Rynnat/endoskull/research/cad_estetik/ref/orbita_tur1_on.png

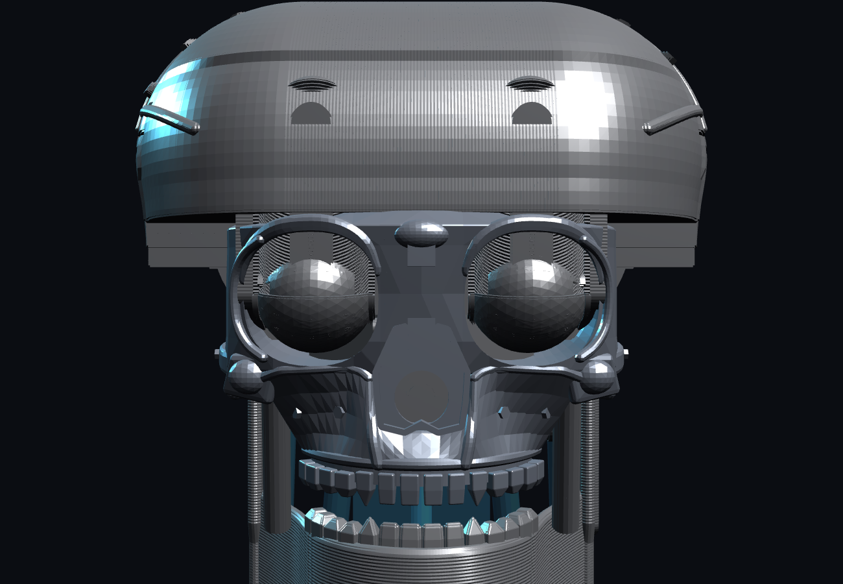
research/cad_estetik/ref/orbita_tur1_on.png
