Rynnat/endoskull/research/cad_estetik/ref/orbita_tur1_3q.png

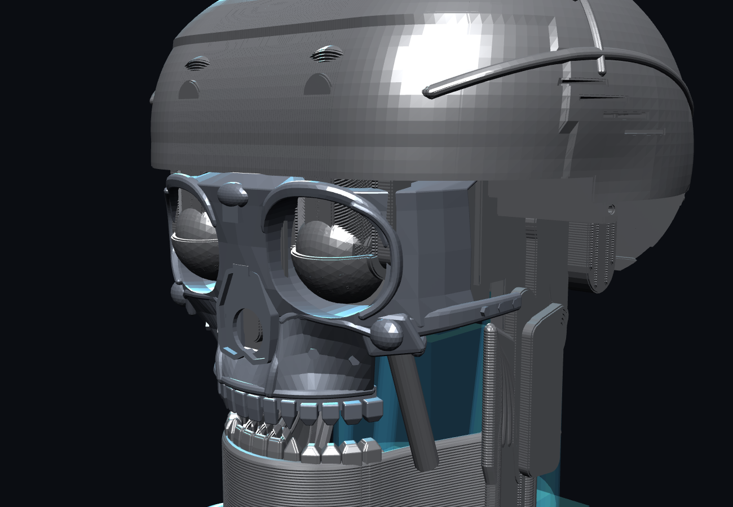
research/cad_estetik/ref/orbita_tur1_3q.png
