Rynnat/endoskull/README.md

# Endoskull

A 1:1 animatronic skull bust, designed as code (CadQuery).

**Status:** CAD and browser simulation stage.

Planned: camera eye tracking (MediaPipe), mechanical jaw, 3-axis neck (yaw / pitch / roll), audio.

## Contents
- `research/` — research notes, plan, decisions (Turkish)
  - `cad/` — parametric CadQuery model, check scripts, STL output
  - `cad_estetik/` — styling branch
  - `kuponlar/` — tolerance / measurement test coupons
- `versions/v1 … v14` — single-file interactive 3D simulation per version (`model.html`, opens in a browser)

## Note
A second design branch derived from an external model (y1, y2) and reference photos are not included in this repo for licensing reasons.
