Rynnat/endoskull/versions/v14/README.md

# Project Bust v14 — CAD SIM (omurga2 ara hali) + Etkileşim
v13 davranış katmanı + güncel CAD (2026-10-17 21:10):
- **B2 sadeleştirildi** (910k → 50.7k üçgen, simplify 0.02 mm; görünüm aynı).
- **Boyun omurga2 (ara hal, kullanıcı "şimdilik ekle")**: iki eğme MG996R sırt sırta omur kasasında (O1L/O1R, dikenli), arka L-kuleler kalktı, N1 disk, **yay ve yay direği kalktı**; arka taşma ~80 mm → ~0. P1'ler hâlâ ~30° geriye eğik (sonraki turda dikleşecek).
- Etkileşim: kişi girince "Bir insan görüyorum.", çıkınca 2 sn içinde "İnsan görüntüden çıktı." (2+ kişi: "Herkes"), geri gelince yine selam. Diğer davranışlar v13 README ile aynı (nesne algılama, sesli komutlar, uzun bakış jesti, boşta etrafa bakınma).
- Kafatası estetiği (cad_estetik/) bu sürümde YOK.

Test: `model.html?test` (BEHTEST). Üretim: research_notes/Project Bust/cad/sim_export.py.
