Rynnat/endoskull/research/cad/out/check_report_boyun.txt

SONUC: SORUN (8)
KAPSAM:
  OLCULDU:   [tek_govde_boyun] 13 parca: ayri govde sayisi (manifold decompose)
  OLCULDU:   [diferansiyel_tork [YAYSIZ (yay yok), nominal]] 70 poz: J = dpsi/dq sayisal (krank cos, rod acisi dahil), tau = J^-T (Q +- ek), pay >= 1.5 @ 2.5 kg*cm
  OLCULDU:   [diferansiyel_tork [YAYSIZ (yay yok), kutle +%30]] 70 poz: J = dpsi/dq sayisal (krank cos, rod acisi dahil), tau = J^-T (Q +- ek), pay >= 1.5 @ 2.5 kg*cm
  OLCULDU:   [yercekimi_tork_pitch [yaysiz, iki servo toplam, bilgi]] 36 parca kutle/AM, 10 aci (-25..+20): yercekimi torku + ek terimler, pay >= 1.5
  OLCULDU:   [strok_boyun] 16 eleman x 50 poz: kinematik cozum var mi + deger izinli aralikta mi (sinir payi)
  OLCULDU:   [kablo_boyun] 3 kablo x 27 poz: dogru parcali yol + servis halkasi <= kablo boyu
  OLCULDU:   [devrilme] 9 poz: toplam AM izdusumu destek cokgeninde (>= 15.0 mm, devrilme acisi >= 15.0 deg)
  OLCULDU:   [montaj_sokme_boyun_tezgah] 8 adim, 10 parca: dogrusal sokme yolu (1.0 mm adim, esik 0.5 mm3 / takili kesisim ustu)
  OLCULDU:   [montaj_sokme_boyun] 16 adim, 91 parca: dogrusal sokme yolu (1.0 mm adim, esik 0.5 mm3 / takili kesisim ustu)
  OLCULDU:   [poz_kilit] izgara 80 poz (bas_yaw 2 x bas_roll 2 x cene 2 x bas_pitch 10) + ikiye bolme (0.5 deg) = 104 poz olculdu; 1866 cift (kurallar: [('N3', 'N2', 0.3), ('N3', 'B1', 0.3), ('B4', '*', 5.0), ('*', '*', 0.4)])
  OLCULDU:   [tork_pay_ozeti_CP3b-2] pitch/roll en kotu servo payi 3 kapasite satiri (KAGIT 1: 2.0 / 2.5 / 3.5)
  OLCULMEDI: [diferansiyel_tork [YAYSIZ (yay yok), nominal]] servo kapasitesi, yay sabiti, surtunme ve dinamik ek terimler GIRDI (olculmedi); servo dis boslugu ve rod esnemesi modellenmedi
  OLCULMEDI: [diferansiyel_tork [YAYSIZ (yay yok), kutle +%30]] servo kapasitesi, yay sabiti, surtunme ve dinamik ek terimler GIRDI (olculmedi); servo dis boslugu ve rod esnemesi modellenmedi
  OLCULMEDI: [yercekimi_tork_pitch [yaysiz, iki servo toplam, bilgi]] GIRDI (olculmedi): dolgu orani / satin alinan parca kutleleri, servo kapasitesi (stall x kural), ek terimler (dinamik, surtunme); kapasite = 2 x 2.5 (krank cos ve diferansiyel paylasim diferansiyel_tork'ta)
  OLCULMEDI: [yercekimi_tork_pitch [yaysiz, iki servo toplam, bilgi]] kablo cekmesi / yay etkisi, eksen kaciklik surtunmesi, servo ic disli boslugu olculmedi
  OLCULMEDI: [strok_boyun] kinematik modelin kendisi (eklem boslugu, esneme, baski sapmasi) ve izgara disindaki ara pozlar olculmedi
  OLCULMEDI: [strok_boyun] kardan pim2 (mentese) +-45 siniri geometrik tahmin; gercek sinir poz_kilit carpismasinda (orta x dil)
  OLCULMEDI: [strok_boyun] rotil acisal siniri 25 deg [TAHMIN K3]; P1 0.4/0.6 varyant tuplerinde boy ayni, yalniz ic OD degisir
  OLCULMEDI: [kablo_boyun] kablonun gercek guzergahi, bukulme yaricapi, surtunme/asinma ve konnektor boyu olculmedi (dogru parcali model)
  OLCULMEDI: [kablo_boyun] kablo ile hareketli parcalar arasindaki carpisma (esnek) olculmedi; kanca/delik konumlari kablo yolu noktasi
  OLCULMEDI: [devrilme] dinamik kuvvetler (servo ivmesi, kablo cekmesi, carpma), masa surtunmesi / kayma, ayak esnemesi olculmedi; statik
  OLCULMEDI: [devrilme] gogus satin kalemleri (lazy susan 150 g, kartlar, hoparlor) ve adaptor kablosu cekmesi TAHMIN
  OLCULMEDI: [montaj_sokme_boyun_tezgah] yalniz dogrusal (tek yonlu) yol; donerek/egilerek takma, esnek parca, el/tornavida erisimi olculmedi
  OLCULMEDI: [montaj_sokme_boyun_tezgah] 1.0 mm'den ince engeller adim arasinda kacabilir
  OLCULMEDI: [montaj_sokme_boyun_tezgah] OMURGA: servolar kasa cebine DISARIDAN (+-X) takilir, kulak M4 somunlari yan girisli; sokme: krank vidasi -> 4 kulak vidasi -> servo; M4/M3 alet koridoru elle (olculmedi)
  OLCULMEDI: [montaj_sokme_boyun] yalniz dogrusal (tek yonlu) yol; donerek/egilerek takma, esnek parca, el/tornavida erisimi olculmedi
  OLCULMEDI: [montaj_sokme_boyun] 1.0 mm'den ince engeller adim arasinda kacabilir
  OLCULMEDI: [montaj_sokme_boyun] yay (esnek, S-kanca) ve kablo montaj sokmeye girmedi; rod grubu once kranka (asagi + yana), bas sonra iner, ust rotil vidasi sonra; P1: ortalar dillere, sonra kisaltilmis teleskop yandan catallara (pimler sokulu degil)
  OLCULMEDI: [poz_kilit] muaf cift B1 x P1L_orta_ust: kardan orta B1 diline M3 pimli (catal dili sarar)
  OLCULMEDI: [poz_kilit] muaf cift B1 x P1R_orta_ust: kardan orta B1 diline M3 pimli (catal dili sarar)
  OLCULMEDI: [poz_kilit] muaf cift B1 x rotil_ust_L: rotil gozu B1 kulagina M3 ile sikilir
  OLCULMEDI: [poz_kilit] muaf cift B1 x rotil_ust_R: rotil gozu B1 kulagina M3 ile sikilir
  OLCULMEDI: [poz_kilit] muaf cift N2 x pim_pitch_L: M4 saplama catal deliginde
  OLCULMEDI: [poz_kilit] muaf cift N2 x pim_pitch_R: M4 saplama catal deliginde
  OLCULMEDI: [poz_kilit] muaf cift N3 x pim_roll_M4x40: M4 roll pimi hac deliginde
  OLCULMEDI: [poz_kilit] muaf cift N4_L x rotil_alt_L: rotil gozu kranka M3 ile sikilir
  OLCULMEDI: [poz_kilit] muaf cift N4_R x rotil_alt_R: rotil gozu kranka M3 ile sikilir
  OLCULMEDI: [poz_kilit] muaf cift O1L x P1L_orta_alt: kardan orta kasa diline pimli
  OLCULMEDI: [poz_kilit] muaf cift O1R x P1R_orta_alt: kardan orta kasa diline pimli
  OLCULMEDI: [poz_kilit] muaf cift P1L_dis x P1L_orta_alt: orta catali tup dilini sarar
  OLCULMEDI: [poz_kilit] muaf cift P1L_ic x P1L_orta_ust: orta ust catali tup dilini sarar (M3 pim)
  OLCULMEDI: [poz_kilit] muaf cift P1R_dis x P1R_orta_alt: orta catali tup dilini sarar
  OLCULMEDI: [poz_kilit] muaf cift P1R_ic x P1R_orta_ust: orta ust catali tup dilini sarar (M3 pim)
  OLCULMEDI: [poz_kilit] muaf cift egme_mg996r_L x egme_mgkol_L: disk kol spline
  OLCULMEDI: [poz_kilit] muaf cift egme_mg996r_R x egme_mgkol_R: disk kol spline
  OLCULMEDI: [poz_kilit] muaf cift lazy_susan_alt x lazy_susan_ust: rulman (satin, tek parca)
  OLCULMEDI: [poz_kilit] muaf cift lazy_susan_ust x mg996r_yaw: servo mili rulman ic deliginde
  OLCULMEDI: [poz_kilit] kurallarla eslesmeyen ciftler bu kontrolde olculmedi (ayri cakisma kontrolleri); izgara arasi kombinasyonlar dogrusal varsayildi
  OLCULMEDI: [poz_kilit] goz yaw/pitch ve kapak pozlari izgaraya katilmadi: goz modulu bas icinde (y > 16), boyun/gogus parcalarina erisemez; goz x kapak supurmesi check.py cakisma_goz_kapak_supurme'de
  OLCULMEDI: [poz_kilit] bas ici ciftler (ayni 'bas' grubu: B4 x B1 vb.) burada olculmedi - cene supurmesi check.py'de

Project Bust CP3b-2 boyun

AYRINTI:
== tek_govde_boyun: GECTI (0 bulgu)
== diferansiyel_tork [YAYSIZ (yay yok), nominal]: GECTI (0 bulgu)
   . bas kutlesi 466 g, AM [3.8, 29.0, 9.3]; I_pitch 17.4 kg*cm2, dinamik pitch 0.149 / roll 0.104 kg*cm, surtunme 0.15; hedef 1.5
   . EN KOTU POZ p-10_r-15: servo torklari [0.234, 0.639] kg*cm (Q [0.644, 0.512] + ek {0: 0.29888298327649976, 1: 0.10372392071126256})
   . kapasite 2.2 kg*cm [2.2 kg*cm] -> en kotu pay 3.44 (hedef 1.5)
   . kapasite 2.5 kg*cm [2.5 kg*cm] -> en kotu pay 3.91 (hedef 1.5)
   . kapasite 3.5 kg*cm [3.5 kg*cm] -> en kotu pay 5.48 (hedef 1.5)
   .    p-10_r-15: maks servo 0.639 kg*cm
   .    p-25_r+0: maks servo 0.634 kg*cm
   .    p-15_r-15: maks servo 0.634 kg*cm
   .    p-15_r-10: maks servo 0.631 kg*cm
   .    p-20_r-5: maks servo 0.630 kg*cm
   .    p-20_r-10: maks servo 0.627 kg*cm
== diferansiyel_tork [YAYSIZ (yay yok), kutle +%30]: GECTI (0 bulgu)
   . bas kutlesi 605 g, AM [3.8, 29.0, 9.3]; I_pitch 22.7 kg*cm2, dinamik pitch 0.194 / roll 0.135 kg*cm, surtunme 0.15; hedef 1.5
   . EN KOTU POZ p-10_r-15: servo torklari [0.283, 0.814] kg*cm (Q [0.837, 0.665] + ek {0: 0.34354787825944966, 1: 0.13484109692464133})
   . kapasite 2.2 kg*cm [2.2 kg*cm] -> en kotu pay 2.70 (hedef 1.5)
   . kapasite 2.5 kg*cm [2.5 kg*cm] -> en kotu pay 3.07 (hedef 1.5)
   . kapasite 3.5 kg*cm [3.5 kg*cm] -> en kotu pay 4.30 (hedef 1.5)
   .    p-10_r-15: maks servo 0.814 kg*cm
   .    p-15_r-15: maks servo 0.809 kg*cm
   .    p-25_r+0: maks servo 0.807 kg*cm
   .    p-15_r-10: maks servo 0.804 kg*cm
   .    p-20_r-5: maks servo 0.802 kg*cm
   .    p-20_r-10: maks servo 0.800 kg*cm
== yercekimi_tork_pitch [yaysiz, iki servo toplam, bilgi]: GECTI (0 bulgu)
   . donen kutle 466 g, AM (notr) [3.8, 29.0, 9.3] mm, eksenden 30.5 mm
   . T(aci) kg*cm: -25:-0.180  -20:-0.057  -15:+0.067  -10:+0.190  -5:+0.312  +0:+0.432  +5:+0.548  +10:+0.660  +15:+0.766  +20:+0.867
   . yercekimi en kotu 0.867 kg*cm @ +20 deg; ek: dinamik 0.149, surtunme 0.150 -> gereken 1.166; kapasite 5.000 -> PAY 4.29 (hedef 1.5)
   . EGRI pitch: yercekimi / yay / net (kg*cm, + = asagi devirir): -25: +0.96/+0.73/+0.23  -20: +0.87/+0.65/+0.22  -15: +0.77/+0.57/+0.20  -10: +0.66/+0.49/+0.17  -5: +0.55/+0.40/+0.15  +0: +0.43/+0.32/+0.12  +5: +0.31/+0.23/+0.08  +10: +0.19/+0.15/+0.04  +15: +0.07/+0.06/+0.00  +20: -0.06/-0.02/-0.04
   . yay denge orani (nominal delik, en kucuk kareler) 0.75 (hedef 0.75); en buyuk sapma 0.022 kg*cm
   . OMURGA2: yay YOK (kaldirildi); yay sutunu bilgi amacli eski ankrajla hesaplandi
== strok_boyun: GECTI (0 bulgu)
   . P1 tup: dis 62.2 / ic 61.0 mm, pim1-tup 8.0/6.7; izinli pim1-pim1 [79.9, 117.9] (alt: ic tup ucu dis tup tabanina / dis tup agzi ic koniye 3.0 mm; ust: bindirme >= 2 x OD)
   . krank_L (r 22.8): -39.84..47.96 deg (p+20_r-15.0 / p-25_r+15.0); sinir [-60.0, 60.0] -> en kucuk pay 12.04 deg (ust, p-25_r+15.0)
   . rotil_alt_L: 0.00..1.65 deg (p-25_r+0.0 / p-25_r-15.0); sinir [None, 25.0] -> en kucuk pay 23.35 deg (ust, p-25_r-15.0)
   . rotil_ust_L: 0.00..16.65 deg (p-25_r+0.0 / p+5_r-15.0); sinir [None, 25.0] -> en kucuk pay 8.35 deg (ust, p+5_r-15.0)
   . P1L tup boyu (pim1-pim1): 80.40..115.56 mm (p+20_r-15.0 / p-25_r+15.0); sinir [79.9, 117.9] -> en kucuk pay 0.50 mm (alt, p+20_r-15.0)
   . P1L kardan ust pim1 (K5): -18.71..19.16 deg (p-15_r+15.0 / p-25_r-15.0); sinir [-25.0, 25.0] -> en kucuk pay 5.84 deg (ust, p-25_r-15.0)
   . P1L kardan alt pim1 (K5): -5.33..4.61 deg (p+20_r-15.0 / p-25_r+15.0); sinir [-25.0, 25.0] -> en kucuk pay 19.67 deg (alt, p+20_r-15.0)
   . P1L kardan ust pim2 (mentese): -26.78..32.55 deg (p-25_r+15.0 / p+20_r-15.0); sinir [-45.0, 45.0] -> en kucuk pay 12.45 deg (ust, p+20_r-15.0)
   . P1L kardan alt pim2 (mentese): -2.85..7.75 deg (p-10_r+15.0 / p+20_r-15.0); sinir [-45.0, 45.0] -> en kucuk pay 37.25 deg (ust, p+20_r-15.0)
   . krank_R (r 22.8): -39.84..47.96 deg (p+20_r+15.0 / p-25_r-15.0); sinir [-60.0, 60.0] -> en kucuk pay 12.04 deg (ust, p-25_r-15.0)
   . rotil_alt_R: 0.00..1.65 deg (p-25_r+0.0 / p-25_r+15.0); sinir [None, 25.0] -> en kucuk pay 23.35 deg (ust, p-25_r+15.0)
   . rotil_ust_R: 0.00..16.65 deg (p-25_r+0.0 / p+5_r+15.0); sinir [None, 25.0] -> en kucuk pay 8.35 deg (ust, p+5_r+15.0)
   . P1R tup boyu (pim1-pim1): 80.40..115.56 mm (p+20_r+15.0 / p-25_r-15.0); sinir [79.9, 117.9] -> en kucuk pay 0.50 mm (alt, p+20_r+15.0)
   . P1R kardan ust pim1 (K5): -19.16..18.71 deg (p-25_r+15.0 / p-15_r-15.0); sinir [-25.0, 25.0] -> en kucuk pay 5.84 deg (alt, p-25_r+15.0)
   . P1R kardan alt pim1 (K5): -4.61..5.33 deg (p-25_r-15.0 / p+20_r+15.0); sinir [-25.0, 25.0] -> en kucuk pay 19.67 deg (ust, p+20_r+15.0)
   . P1R kardan ust pim2 (mentese): -26.78..32.55 deg (p-25_r-15.0 / p+20_r+15.0); sinir [-45.0, 45.0] -> en kucuk pay 12.45 deg (ust, p+20_r+15.0)
   . P1R kardan alt pim2 (mentese): -2.85..7.75 deg (p-10_r-15.0 / p+20_r+15.0); sinir [-45.0, 45.0] -> en kucuk pay 37.25 deg (ust, p+20_r+15.0)
== kablo_boyun: GECTI (0 bulgu)
   . boyun 8 iletken (5V, GND, SDA, SCL, I2S SCK/WS/SD, 3V3): yol 272..323 mm (yaw0_p20_r15 / yaw70_p-25_r-15), degisim 51, + servis 60 = 383 / boy 420
   . egme servo L kablosu (30 cm + 30 cm uzatma): yol 178..194 mm (yaw0_p-25_r-15 / yaw70_p-25_r-15), degisim 17, + servis 40 = 234 / boy 600
   . egme servo R kablosu (30 cm + 30 cm uzatma): yol 175..191 mm (yaw0_p-25_r-15 / yaw70_p-25_r-15), degisim 17, + servis 40 = 231 / boy 600
== devrilme: GECTI (0 bulgu)
   . EN KOTU: yaw0_p20 -> on kenarina 85.6 mm, 28.7 deg
   . yaw-70_p-25: kutle 1408 g, AM (-1.2, 1.9, 153.6); en yakin destek kenari (arka, normal [-0.03, 1.0]) 87.0 mm, devrilme acisi 29.5 deg
   . yaw-70_p0: kutle 1408 g, AM (2.3, 0.6, 155.8); en yakin destek kenari (arka, normal [0.03, 1.0]) 88.2 mm, devrilme acisi 29.5 deg
   . yaw-70_p20: kutle 1408 g, AM (5.5, -0.6, 156.2); en yakin destek kenari (arka, normal [0.03, 1.0]) 89.3 mm, devrilme acisi 29.8 deg
   . yaw0_p-25: kutle 1408 g, AM (1.3, 1.9, 153.6); en yakin destek kenari (arka, normal [0.03, 1.0]) 87.0 mm, devrilme acisi 29.5 deg
   . yaw0_p0: kutle 1408 g, AM (1.3, -1.8, 155.8); en yakin destek kenari (on, normal [0.03, -1.0]) 89.1 mm, devrilme acisi 29.8 deg
   . yaw0_p20: kutle 1408 g, AM (1.3, -5.3, 156.2); en yakin destek kenari (on, normal [0.03, -1.0]) 85.6 mm, devrilme acisi 28.7 deg
   . yaw70_p-25: kutle 1408 g, AM (2.1, -0.4, 153.6); en yakin destek kenari (arka, normal [0.03, 1.0]) 89.3 mm, devrilme acisi 30.2 deg
   . yaw70_p0: kutle 1408 g, AM (-1.4, -1.7, 155.8); en yakin destek kenari (on, normal [-0.03, -1.0]) 89.2 mm, devrilme acisi 29.8 deg
   . yaw70_p20: kutle 1408 g, AM (-4.7, -2.9, 156.2); en yakin destek kenari (on, normal [-0.03, -1.0]) 87.9 mm, devrilme acisi 29.4 deg
== montaj_sokme_boyun_tezgah: GECTI (0 bulgu)
   . adim 8: 'egme_mgkol_R+N4_R' takma yonu (1.0, 0.0, 0.0) - 49 mm yol serbest
   . adim 7: 'egme_mgkol_L+N4_L' takma yonu (-1.0, 0.0, 0.0) - 49 mm yol serbest
   . adim 6: 'egme_mg996r_R' takma yonu (1.0, 0.0, 0.0) - 73 mm yol serbest
   . adim 5: 'egme_mg996r_L' takma yonu (-1.0, 0.0, 0.0) - 73 mm yol serbest
   . adim 4: 'O1R' takma yonu (0.0, -1.0, 0.0) - 127 mm yol serbest
   . adim 3: 'O1L' takma yonu (0.0, -1.0, 0.0) - 127 mm yol serbest
   . adim 2: 'N2' takma yonu (0.0, -1.0, 0.0) - 127 mm yol serbest
== montaj_sokme_boyun: SORUN (8 bulgu)
   - adim 16: 'P1R_ic+P1R_dis' sokulemez (takma yonu (1.0, 0.0, 0.0)): tersine 4.0 mm'de P1R_dis x P1R_orta_alt kesisim 1.7 mm3 (takili 0.0) -> bu sirayla TAKILAMAZ
   - adim 15: 'P1L_ic+P1L_dis' sokulemez (takma yonu (-1.0, 0.0, 0.0)): tersine 4.0 mm'de P1L_dis x P1L_orta_alt kesisim 1.7 mm3 (takili 0.0) -> bu sirayla TAKILAMAZ
   - adim 14: 'P1R_orta_alt' sokulemez (takma yonu (-0.001, 0.474, -0.88)): tersine 1.0 mm'de P1R_orta_alt x O1R kesisim 4.4 mm3 (takili 1.6) -> bu sirayla TAKILAMAZ
   - adim 13: 'P1L_orta_alt' sokulemez (takma yonu (0.001, 0.474, -0.88)): tersine 1.0 mm'de P1L_orta_alt x O1L kesisim 4.4 mm3 (takili 1.6) -> bu sirayla TAKILAMAZ
   - adim 12: 'P1R_orta_ust' sokulemez (takma yonu (-0.007, -0.473, 0.881)): tersine 2.0 mm'de P1R_orta_ust x bas:B1 kesisim 1.7 mm3 (takili 1.2) -> bu sirayla TAKILAMAZ
   - adim 11: 'P1L_orta_ust' sokulemez (takma yonu (0.007, -0.473, 0.881)): tersine 2.0 mm'de P1L_orta_ust x bas:B1 kesisim 1.7 mm3 (takili 1.2) -> bu sirayla TAKILAMAZ
   - adim 8: 'rotil_alt_R+rotil_ust_R+rod_R+N5_R' sokulemez (takma yonu (0.0, -1.0, 0.0) -> (-1.0, 0.0, 0.0) 6 mm): tersine 6.0 mm'de N5_R x N2 kesisim 4.6 mm3 (takili 0.0) -> bu sirayla TAKILAMAZ
   - adim 7: 'rotil_alt_L+rotil_ust_L+rod_L+N5_L' sokulemez (takma yonu (0.0, -1.0, 0.0) -> (1.0, 0.0, 0.0) 6 mm): tersine 9.0 mm'de rotil_alt_L x N2 kesisim 0.9 mm3 (takili 0.0) -> bu sirayla TAKILAMAZ
   . adim 10: 'pim_roll_M4x40' takma yonu (0.0, 0.0, 1.0) - 117 mm yol serbest
   . adim 9: 'bas:B1+bas:B2+bas:B3L+bas:B3R+bas:B4+bas:B5a+bas:B5b_L+bas:B5b_R+bas:B5c_L+bas:B5c_R+bas:B5g_L+bas:B5g_R+bas:B5h+bas:B5d_L+bas:B5d_R+bas:B5e_L+bas:B5e_R+bas:B5i+bas:B5f_yaw+bas:B5f_pitch+bas:B5f_alt+bas:B5f_ustL+bas:B5f_ustR+bas:C1+bas:B6L+bas:B6R+bas:sg90_yaw+bas:sgkol_yaw+bas:sg90_pitch+bas:sgkol_pitch+bas:sg90_alt+bas:sgkol_alt+bas:sg90_ustL+bas:sgkol_ustL+bas:sg90_ustR+bas:sgkol_ustR+bas:mg996r_cene+bas:mgkol_cene+bas:pca2+bas:inmp441_L+bas:kopuk_L+bas:inmp441_R+bas:kopuk_R+bas:kamera_rezerv+bas:rotil_krank+bas:rotil_cene+bas:cene_rod' takma yonu (0.0, -1.0, 0.0) - 218 mm yol serbest
   . adim 6: 'pim_pitch_R' takma yonu (1.0, 0.0, 0.0) - 176 mm yol serbest
   . adim 5: 'pim_pitch_L' takma yonu (-1.0, 0.0, 0.0) - 176 mm yol serbest
   . adim 4: 'N3' takma yonu (0.0, -1.0, 0.0) - 21 mm yol serbest
   . adim 3: 'N1+N2+O1L+O1R+egme_mg996r_L+egme_mg996r_R+egme_mgkol_L+egme_mgkol_R+N4_L+N4_R' takma yonu (0.0, -1.0, 0.0) - 133 mm yol serbest
   . adim 2: 'Y1' takma yonu (0.0, -1.0, 0.0) - 9 mm yol serbest
== poz_kilit: GECTI (0 bulgu)
   . sure 176 s; bas parcalari: bas cercevesinde y_min < 16 olanlar (taban, cene, mikrofon, cene mekanizmasi)
   . KILIT bas_yaw +0, bas_roll +0, cene +0: bas_pitch [-25.0, +20.0]  alt: -  ust: -
   . KILIT bas_yaw +0, bas_roll +0, cene +20: bas_pitch [-11.9, +20.0]  alt: ('B4', 'N2', 0.4)  ust: -
   . KILIT bas_yaw +0, bas_roll +15, cene +0: bas_pitch [-21.9, +20.0]  alt: ('B4', 'N2', 3.39)  ust: -
   . KILIT bas_yaw +0, bas_roll +15, cene +20: bas_pitch [-1.9, +20.0]  alt: ('B4', 'N2', 2.32)  ust: -
   . KILIT bas_yaw +70, bas_roll +0, cene +0: bas_pitch [-25.0, +20.0]  alt: -  ust: -
   . KILIT bas_yaw +70, bas_roll +0, cene +20: bas_pitch [-11.9, +20.0]  alt: ('B4', 'N2', 0.4)  ust: -
   . KILIT bas_yaw +70, bas_roll +15, cene +0: bas_pitch [-21.9, +20.0]  alt: ('B4', 'N2', 3.39)  ust: -
   . KILIT bas_yaw +70, bas_roll +15, cene +20: bas_pitch [-1.9, +20.0]  alt: ('B4', 'N2', 2.32)  ust: -
== tork_pay_ozeti_CP3b-2: GECTI (0 bulgu)
   . YAYSIZ (yay yok), nominal: 2.2 kg*cm -> pay 3.44  2.5 kg*cm -> pay 3.91  3.5 kg*cm -> pay 5.48
   . YAYSIZ (yay yok), kutle +%30: 2.2 kg*cm -> pay 2.70  2.5 kg*cm -> pay 3.07  3.5 kg*cm -> pay 4.30
