Rynnat/endoskull/research/08_yanak_piston_omurga_ref.md

# 08 — Yanak (P2) pistonu ve boyun omurgası: görsel/ölçü referansı

Tarih: 2026-10-17 · Araştırma notu, karar yok. Project Angela kullanılmadı.
Envanter (plan-v2) bu notta okunmadı: konu görsel referans, servo ölçüsü (MG996R 40.7 × 19.7 × 42.9) görevden alındı.
Etiketler: [K] kaynaklı · [H] hesap (bu not) · (belirsiz) gözlem/hafıza, kaynak bulunamadı, kullanıcı referans fotoğrafla doğrulasın.

**Kaynak durumu (önemli):** RPF'nin teknik başlıkları (neck piston placement, T1/T2 research thread, T-800 skull help) WebFetch'e **403** verdi. Bu yüzden içerikleri yalnızca arama özetinden alındı. Hiçbir üretici (Sideshow, Prime 1, Hot Toys, Blitzway) yanak pistonu ya da boyun omurgası için ölçü vermiyor. Aşağıdaki mm değerleri insan anatomisi ve bizim çene kinematiği üzerinden **hesap [H]**. Filmden ölçülmüş değil.

---

## 1. Kaynaklı bulgular

| # | Bulgu | Kaynak |
|---|---|---|
| 1 | Stan Winston Studio'nun T2-3D ışıklı T-800 kafatasında "cheek pistons, a neck assembly, connecting rods" var. Döküm üretan, vakum metalize kaplama. 38.25 × 25.5 × 15.25 cm (kaide ve boyun dahil) | [Propstore T2-3D skull](https://propstore.com/product/t2-3d-battle-across-time-1996/light-up-t-800-endoskeleton-skull/) |
| 2 | Yüzün iki yanındaki **dik** pistonlar yalnız görünüş içindir, çeneyi taşımaz (kit yapımcısının gözlemi) | [RPF T-800 Skull help](https://www.therpf.com/forums/threads/t-800-skull-help.361460/) (403, arama özeti) |
| 3 | Çene pistonlarının üst ve alt uçlarında çıkıntı/halka var. M1 ile LFS kitleri bunda farklı. Üstteki halka biraz kalın, alttaki ince. Hayatta kalan endo'ların çoğunda ince olanı var. T1/T2 referans fotoğrafları başlıkta | [RPF T1/T2 Endoskeleton Research Thread s.2](https://www.therpf.com/forums/threads/t1-and-t2-endoskeleton-research-thread.340427/page-2) (403, arama özeti) |
| 4 | Zizolfo yapımı: çene oyulmuş, küçük yanak pistonları arkadan görünüyor. Pistonlar kitten çıktığı gibi kullanılmış | [CultTVman, Zizolfo endo](https://culttvman.com/main/john-zizolfos-terminator-endoskeleton/) |
| 5 | Yazdırılabilir kafatası (Noah Williamson): çeneyi açan pistonlar **kırılgan**. Gerçek boy için %130 ölçek gerekiyor. Çene ve üst diş parçalarında doluluk artırılmalı. Toplam ~70 saat baskı | [All3DP](https://all3dp.com/4/3d-print-terminator-skull-complete-moving-eyes-jaw/) |
| 6 | Remix: borular baskıda zayıf kaldığı için **+2 mm kalınlaştırılmış**. Ağız ve çene boruları yüzünden model 3 parçaya bölünmüş | [3dgo / Thingiverse 392804](https://3dgo.app/models/thingiverse/392804) |
| 7 | Cults3D 1:1 animatronik kafatası: ayrı mafsallı çene ve boyun, içte çene servosu ve LED bağlantıları | [Cults3D](https://cults3d.com/:3363296) |
| 8 | Boyun: kopyalarda metal hortum kanalın **altında** da duruyor **içinde** de (Toynami ile Sideshow farklı). Pistonların düz mü açılı mı durduğu tartışmalı, "açılı" öneriliyor. Kablonun işi başı yana çekmek | [RPF neck piston placement](https://www.therpf.com/forums/threads/calling-all-terminator-endo-experts-neck-piston-placement.139569/post-2137086) (403, arama özeti) |
| 9 | Sideshow 1:1 büst: 27″ yükseklik × 17″ omuz genişliği (68.6 × 43.2 cm), mafsallı baş, LED göz. Basın fotoğrafları (arka/yan): [Press02](https://www.sideshow.com/wp/wp-content/uploads/2015/06/400219_Press02.jpg), [Press04](https://www.sideshow.com/wp/wp-content/uploads/2015/06/400219_Press04.jpg), [Press06](https://www.sideshow.com/wp/wp-content/uploads/2015/06/400219_Press06.jpg), [Press08](https://www.sideshow.com/wp/wp-content/uploads/2015/06/400219_Press08.jpg), [Press10](https://www.sideshow.com/wp/wp-content/uploads/2015/06/400219_Press10.jpg) | [Sideshow blog](https://www.sideshow.com/blog/presenting-the-terminator-t-800-life-size-bust) |
| 10 | Zizolfo: orijinal omuz parçasında boyun iki yandan bağlı. LED kabloları göğüsten geçip boynun tepesinden çıkıyor | [CultTVman](https://culttvman.com/main/john-zizolfos-terminator-endoskeleton/) |
| 11 | T2 için Stan Winston Studio hem kabloyla oynatılan kukla hem de sabit endo yaptı | [Propstore full-size T2 endo](https://propstore.com/product/terminator-2-judgment-day/full-size-t-800-endoskeleton/) |
| 12 | 1:2 Agora: uzaktan kumandalı çene, 650+ parça. Kit topluluğunda pack fotoğrafları var | [Agora](https://www.agoramodels.com/jp/terminator-t-800), [Agora topluluk pack 10](https://community.agoramodels.com/topic/198-james-hs-terminator-t-800-pack-10/) |
| 13 | Sideshow 1:1 T2 "Combat" büstü (görsel referans) | [ScreenAnarchy](https://screenanarchy.com/2008/10/sideshow-terminator-2-combat-exclusive-11-endoskeleton-bust.html) |
| 14 | Boyun hortumu için ev yapımı çözümler: araba ayna mafsalı, lehim teli | [BYC forum endo kit](https://byyourcommand.net/cylonforum/viewtopic.php?p=37268) |
| 15 | Kafatasını referans alan RPF baskı yapımları (çene doğruluğu tartışması) | [RPF 3D printed display](https://www.therpf.com/forums/threads/t-800-skull-3d-printed-display.289728/), [RPF 3D printing T-800 bust](https://www.therpf.com/forums/threads/3d-printing-t-800-bust.214545/) |
| 16 | Ayrıntılı T1 kafatası 3B modeli (görsel referans için render) | [RenderHub Rekvizit T1 V2](https://www.renderhub.com/skynet-2029/terminator-t-800-endoskeleton-rekvizit-t1-v2) |

### Gözlem (belirsiz, fotoğrafla doğrula: #3, #9, #16 görselleri)
- Yanak pistonu her yanda **tek** ve neredeyse **dik**. Üst ucu elmacık kemiğinin (zigomatik ark) altında, göz çukurunun dış-alt köşesinin altında. Alt ucu mandibula gövdesinin dış yüzünde, ramus ile gövdenin birleştiği yerin önünde (masseter kasının yeri). Kulak arkasına bağlanmıyor.
- Görünüş **2 kademe**: kalın silindir yukarıda, ince rod aşağıda. Her iki uçta halka ya da göz (#3'teki "üst/alt çıkıntı").
- Silindir çapı göz çukurunun genişliğinin ~1/4'ü. 1:1'de kabaca Ø9–12 silindir, Ø5–7 rod.

---

## 2. Konu 1: P2 yanak pistonu, uç noktaları ve strok [H]

**Çerçeve:** Orijin = çene kondil pivotu (I22 ekseni), **x ileri, y yukarı**, mm, yandan görünüş. Pistonun yanal konumu kafatası dış yüzüne göre: yüzeyden ~6–8 mm dışarıda (Ø8–10 boru + boşluk).
**Anatomi girdisi [H, tipik erkek]:** kondilden gonion'a (ramus boyu) ~55–60 mm. Zigomatik arkın alt kenarı kondil seviyesinde (±5 mm). Elmacık gövdesi kondilin ~30–40 mm önünde. Kafatası boyu 190 mm.
**Çene:** 0..20° açılma (PLAN §3). Açılmada x>0 olan noktalar aşağı ve geriye döner.
Hesap: L' = (x cos θ + y sin θ, −x sin θ + y cos θ), θ = 20°.

| Seçenek | Üst uç U (B2) | Alt uç L (B4) | Boy kapalı → açık | Strok | Duruş | Boy / kafatası | Çap önerisi |
|---|---|---|---|---|---|---|---|
| **A: film oranı, kısa ve dik** | (+30, +8), zigomatik ark altı, elmacık kökü | (+25, −50), mandibula gövdesi, açının önü | 58.2 → 67.8 | **+9.6** | üst uç 5° önde, açılınca ~20° arkaya yatar | 0.31 | silindir Ø10 × 36, rod Ø6 |
| **B: plana yakın (82.5→90.5)** | (+20, +30), elmacık üstü / şakak altı | (+30, −50), gövde | 80.6 → 87.7 | **+7.1** | 7° geri yatık, açılınca neredeyse dik | 0.42 | Ø8 × 48 + rod Ø5 (plandaki Ø8 × 80) |
| **C: çapraz, neredeyse strok yok** | (−10, +5), kondilin arkası, kulak önü | (−5, −60), gonion | 65.2 → 61.6 | **−3.6** (kısalır) | dik, ramusun arkasında | 0.34 | Ø10 tek kademe + kılıf |

**Yorum:**
- A, film görüntüsüne en yakın seçenek (belirsiz). Strok büyük olunca teleskop bindirmesi en az 10 mm olmalı. Kapalı boy 58 mm, bunun 36'sı silindir. Kapalı konumda bindirme 26, açıkta 16 mm kalır. Açılırken alt uç ~6 mm dışa da kayar; rotil ya da küresel mafsal gerekir (I28 zaten K5).
- B, plandaki P2 boyu ve stroku (82.5→90.5, 8 mm) ile tutarlı. Görsel olarak "uzun yanak pistonu", filmdekinden ~%35 uzun (belirsiz).
- C açılmada kısalıyor. Teleskop gerekmez, bir kılıf yeter, sürtünme en az. Ama ramusun arkasında olduğu için önden pek görünmez.
- Üç seçenekte de alt uç alt diş sırasının en az 8 mm arkasında kalmalı. Konsept dersi (PLAN §6): ramus önü 5°'de kilitleniyordu. A'nın alt ucu ramus önüne yakın, `poz_kilit` taramasında öncelikli bakılmalı.
- Sürtünme 0.3 N, kol ~40 mm alınırsa çeneye 2 × 0.12 = 0.24 kg·cm. Bu PLAN'daki ile aynı ve A, B, C arasında fark ≤ 0.05 kg·cm [H].

---

## 3. Konu 2: boyun omurgası, arka görünüm

### Filmdeki görsel dil (belirsiz, #8, #9, #13 fotoğraflarıyla doğrula)
- Ortada omur benzeri **istif bir kolon**: yuvarlak gövde + disk aralığı. Arkada kısa diken çıkıntıları var ama insan omurgasına göre belirgin değiller.
- Kolonun iki yanında **2 büyük piston**. Üstleri kafatası tabanında, altları omuz/köprücük köküne bağlı. Hafif açılı duruyorlar (#8 tartışması).
- Kolon boyunca ya yanından geçen **örgülü metal hortum** var (konumu kopyaya göre değişiyor, #8). Ek olarak ince kablo demetleri.
- Arka yüz, ön yüzden daha "dolu". Pistonlar ve hortum arkaya yakın geçiyor, aralar açık ve içi görülüyor.

### İnsan ölçüsü girdisi [H, tipik]
C2–C7 toplam ~110–120 mm. Omur gövdesi ~14–15 mm, disk ~4–5 mm (adım ~19 mm). Diken boyu C3–C5 ~12–18 mm, C7'de en uzun ~25–30 mm (vertebra prominens; C3–C6 dikenleri çatallı). Genel anatomi: [Wikipedia Cervical vertebrae](https://en.wikipedia.org/wiki/Cervical_vertebrae).

### Bizim kısıt
İki MG996R sırt sırta (19.7 boyutları birleşik) blok olarak 40.7 × 39.4 × 42.9 mm. Kulaklarla 54 mm. Kasa et kalınlığı 2 mm ile dış ölçü ≈ **45 × 44 × 47** (kulaklar hariç) [H]. Bu blok arkada yaklaşık 2.5 omur adımı (47 / 19) yer kaplar.

| Seçenek | Görünen omur | Adım / ara | Diken | Servo bloğu | Görünüm |
|---|---|---|---|---|---|
| **O1: anatomik 6 omur (C2–C7)** | 6 | 19 mm (gövde 14 + ara 5) | 12, 14, 16, 18, 22, 28 mm (aşağı doğru artan), 10° aşağı eğik | 3 omur (C4–C6) servo kasasının arka kapağına kabartma, ön yüzleri sahte; aralarda 3 mm gölge yarığı | İnsana en yakın; diken uçları kasa arkasından 28 mm'ye kadar taşar, yaw süpürmesinde göğüs kafesine çarpabilir |
| **O2: endo stili 4 kalın omur** | 4 | 26 mm (gövde 20 + ara 6) | eşit 15 mm, köşeli plaka | 2 omur tam olarak servo kasasının kendisi (47 mm ≈ 2 × 26 − ara) | En sade; ara boşluklardan servo gövdesi ve kablolar görünür ("açık yapı") |
| **O3: 5 omur + 2 arka piston** | 5 | 22 mm (gövde 16 + ara 6) | 12–20 mm | Kasa 2 omur. Kasanın iki yanından 2 kozmetik arka piston (Ø8, P1 ile aynı boru) iniyor; bir yanda örgülü hortum (Ø6) | Filme en yakın (#8 açılı piston + hortum). Parça sayısı +4 (2 piston, hortum klipsi ×2) |

**Ortak öneriler:** dikenleri omur kasasından ayrı basılan, M3 ile takılan parçalar olarak yap. Bu sayede uzunluk kuponla denenebilir ve tabla yönü dik kalır. Ara yarıkları kablo çıkışı olarak kullan; MG996R kablosu 3 mm, demet Ø~7. Arka pistonlar P1 boru stokundan gelirse yeni malzeme gerekmez.

---

## 4. Tek öneri (karar değil)
**P2 için A seçeneği**, plana göre P2 boyu 80'den ~58 mm'ye, stroku 8'den ~10 mm'ye çıkar. **Boyun için O3.** İkisi de filme en yakın oranlar. Ölçüler [H]; yazıcıya geçmeden önce Sideshow Press04/Press06 görselinden kafatası boyuna oranla piksel ölçümü yapılmalı.

## 5. Plan için riskler
| Risk | Bu projede | Rakam |
|---|---|---|
| **Çakışma / kilitlenme (kritik)** | A'nın alt ucu ramus önüne yakın; konsepte çene 5°'de kilitlenmişti | alt uç–diş sırası mesafesi ≥ 8 mm olmalı, yanal kayma ~6 mm |
| Tolerans zinciri | teleskop bindirmesi + 2 küresel mafsal | A: bindirme açıkta 16 mm; boşluk 0.4–0.6 (P1_ic varyantı ile aynı) |
| Mukavemet | yazdırılmış ince borular kırılgan (#5, #6) | rod ≥ Ø5, et ≥ 1.2 mm; ya da rodu M3 dişli çubuk/Ø5 alüminyum yap |
| Tork | kozmetik sürtünme | çeneye +0.24 kg·cm, mevcut pay 4.4 → değişmez |
| Montaj erişimi | P2 adım 15, yandan, B2 kabuğu takılıyken | M3×10 vidaya tornavida açısı: üst uç elmacık altında kalınca ≤ 30° eğik erişim |
| Boyun dikeni ↔ göğüs | O1'in 28 mm C7 dikeni | yaw ±, pitch +20'de G1 manubrium/T1'e yakın; `poz_kilit` ızgarasına ekle |
| Tabla | dikenler ve pistonlar dik basılır | diken ayrı parça → kasa tablaya düz oturur |
| Kablo | 2 MG996R + 5 SG90 + LED, boyun içinden | demet Ø~7–9, omur arası yarık ≥ 5 mm |
