Rynnat/endoskull/research/cad_estetik/DECISIONS.md

# CP3b-1 kararları (2026-10-17)

Kaynaklar: PLAN.md (onaylı), KARARLAR.md, KAGIT_OLCUM.md (kupon yerine kâğıt değer, kötü uç), konsept v6 (model.html, yalnız koordinat/form). Project Angela dosyalarına bakılmadı.

## Genel yaklaşım
- Organik formlar (kafatası kabuğu, tüpler, kaburgalar) manifold3d ile kuruldu (konsept `skullWarp` aynen Python'a taşındı). Mekanik arayüzler (SG90 cebi, somun tuzağı, vida-pim, kol cepleri) agent-flow/sablonlar'dan CadQuery kesicisi olarak alındı. Alternatif: tamamen CadQuery. Organik yüzeyde loft/sweep hem yavaş hem kırılgan olurdu, o yüzden seçilmedi.
- Kabuk kütlesi KAGIT_OLCUM 8'deki kötü uç değeriyle hesaplandı: 0.22 g/cm² × dış alan. Diğer basılı parçalar için dilimleyici yaklaşımı kullanıldı (çevre 1.0 mm + %15 dolgu). Tartıyla doğrulanmadı.
- Üst kapak stroku ≤ 60° ve kapak kolunda 1.5× (r 8) ile 1.8× (r 6.67) iki delik: KAGIT_OLCUM 6.
- MG996R cebi +0.3, kol cebi 0.2, M3 vida-pim 3.3: KAGIT_OLCUM 3, 4, 11.

## PLAN SAPMASI: ust kapak stroku 75 -> 60
Neden: KAGIT_OLCUM 6'da SG90'ın kötü uç hızı 0.15 s/60°. 1.5× bağlantıyla 60° kapak için servo 40° döner, bu da ~100 ms eder. 75° ile 100 ms tutmuyordu. Alternatif 1.8× deliği daha hızlı ama torku daha düşük; ikisi de modelde.

## PLAN SAPMASI: kapak malzemesi PETG 0.8 -> PLA 1.2
Neden: KARARLAR'da "PETG YOK" var. PLA'da 0.8 mm kabuk 2 çevreye düşüyor ve kırılgan oluyor, o yüzden 1.2 mm (3 çevre) seçildi. Kapak başına ~1 g ek kütle çıktı.

## PLAN SAPMASI: goz yaw pimi M3 vida-pim -> O1 tel pim
Neden: göz yaw ekseni gimbal halkasının üst ve alt noktasında. Halka radyal 1.6 mm (r 12.6..14.2) ve üst kapağın iç yarıçapı 15.0, yani M3 kafası (1.9 mm) ya da somunu sığmıyor. Halka O1.0 deliğe pres O1 çelik tel (BOM'daki tel), göz O1.3 delikte dönüyor. Pitch ekseni M3 olarak kaldı (dışta M3x10 vida-pim, içte M3 dişli çubuk). Alternatif olarak halkanın dışına yoke konabilirdi, ama kapak süpürmesine giriyordu.

## PLAN SAPMASI: ust kapak pivotu iki yan -> tek yan (dis)
Neden: iç bantta (göz merkezinden 12.6–14.6 mm) halkayı pitch çubuğuna bağlayan kulak var. Bu kulak θ 109–157° aralığında süpürüyor; üst kapağın iç yan plakası açıkken aynı bölgeye giriyordu. Üst kapak yalnız dış yanda pivotlu. Kabuk 1.2 mm, kapak ~1 g; konsol açıklığı 24 mm. Alt kapak iki yanda pivotlu.

## PLAN SAPMASI: B2 vidalari onden 4x M3 -> alttan 4x M3
Neden: önden (−Z) girecek alet yolunu elmacık ve göz modülü kapatıyor. B1'in iki alt kulağına (x ±38..52) 2'şer M3 alttan (+Y) giriyor, somun yan kanallı. Bunun için montaj sırası değişti (aşağıya bakın).

## PLAN SAPMASI: montaj sirasi B2, B4'ten once
Neden: B2 vidaları alttan giriyor ve çene takılıyken alet yolu dar kalıyor. Baş tezgâh montajı: B1 → SG90×5 → çene MG996R → PCA#2 → mikrofonlar → kamera rezervi → **B2 (alttan, +Y)** → B5 göz modülü (−Y) → SG90 kolları → **B4 (alttan, +Y)** → C1 + rod → B3R (+X) → B3L (−X). Kontrol: montaj_sokme_bas.

## PLAN SAPMASI: kubbe sagital bindirme + 6x M3 her yari -> bindirme dili vidasiz + 3x M3 B1'e
Neden: sagital dikişteki iç vidalara iki yarı kapandıktan sonra erişilemiyor. B3L'de 6 mm × 1.6 mm bindirme dili var ve B3R'nin altına giriyor. Her yarı B1'e 3 vidayla bağlanıyor: 2 yandan (X ekseni, şakak penceresinden; vida başı dışta "cıvata" görünümü veriyor) ve 1 arkadan (Z). Toplam 6 vida, plandaki 12 yerine.

## PLAN SAPMASI: mikrofon yeri kabuk deligi 12 mm -> sakak penceresinde ayri kap
Neden: kubbenin yan alt kenarı y 46'da bitiyor. Bunun altı şakak penceresi; çene krankı, kondil ve rod görünür kalıyor (Terminatör iskelet görünümü). Kulak hizasındaki mikrofon bu açık bölgede, B6 kabının içinde duruyor. Kart köpük (EVA 1.5) içinde yüzüyor, kap B1 koluna köpük conta + 2× M2 ile bağlı. Dış yüzde O1.5 delikli ızgara var. Titreşim yolu: B1 → conta → kap → köpük → kart. Ölçülmedi.

## PLAN SAPMASI: cene servosu yonu konsept mil Y -> mil X
Neden: konseptte çene servosunun mili Y'deydi; krank XZ düzleminde dönüyor, kondil kolu ise YZ'de hareket ediyordu, ikisi uyuşmuyordu. Mil +X'e çevrildi: B1'in +X yan duvarına 4× M4 kulak (PLAN I21), krank r 20 (Ç1) YZ düzleminde, rod 2 rotil ile kondilin arkasındaki kola (r ~20) bağlı. Servo konumu PLAN'daki yer (pivotun arkası, z −10..−50, y 34..54). R1'i önlemek için konseptten ~10 mm yukarı alındı; rotil REZERV kulakları (x ±27.5..32.5, y < 15) servonun altında kaldı.

## PLAN SAPMASI: lazy susan 100-120 -> 100 OD [TAHMIN]
Neden: köprücük iç ucu (x ±18..70) güverte kenarına yaklaşıyor. Ø100 ile 2 mm pay kalıyor. Delikler oval (±3 mm, KAGIT 10). K8 ölçülünce güncellenir.

## Diğer tasarım seçimleri (sapma değil)
- SG90'ların mile yakın ucu (kablo) arkaya bakıyor. Kollar tel yönüne göre seçildi: yaw +Z r 18 (iki göz, iki tel tek delikte), pitch −X r 12 → pitch çubuğu, alt kapak +X r 12 → alt çubuk, üst kapaklar dışa r 12. Kol katmanları farklı yükseklikte (ped 12/18/24), böylece teller ve kollar birbirini kesmiyor.
- Göz modülü: kapak/halka/plaka x bantları (göz merkezinden): halka göbeği 12.6–14.6, üst kapak 15.0–16.2, alt kapak 16.6–17.8, çerçeve 18.2–21.2. Bantlar arasında 0.4 eksenel pay var. Kapak kabukları |x| ≤ 12'de, yani eksen etrafında süpürmede birbirine giremiyor.
- B3 kubbe alt kenarı: önde y 50 (üst kapak süpürmesi en çok y 47.8), yanlarda 46, arkada (z < −58) 10.
- REZERV (CP3b-2): B1'de roll pimi kulakları (Z, y 0), rotil kulakları (X, y −6), yay kancası (z −64) yalnız yer tutucu. U-haç süpürmesi y ≤ 14.2 hesabıyla B1 tabanı y 15..18'de.
- Kozmetik detay (cıvata başı, sırt, oluk) kabuğa entegre. Kütle bütçesinde ayrı satır yok, CAD hacminde var.

# CP3b-1 devam (2026-10-17, 2. oturum)

## PLAN SAPMASI: kamera rezervi 32x32 -> 24x24
Neden: göz çukuru kenarı ile maksilla arasında ~25 mm yer var, 32×32 OV5640 kartı sığmıyor. B2 kamera çerçevesi 24×24 kart için (M2 ×2, lens Ø8). Kart seçilince yeniden bakılacak (STATE: kullanıcı işi).

## Alt kapak bağlantısı yeniden düzenlendi (sapma değil: servo ve kapak plandaki gibi)
Sorun: tel noktası θ −160'taydı ve kapak kapanırken orada çoğunlukla −Y yönünde hareket ediyor. Dikey milli SG90 kolu ise XZ düzleminde dönüyor; 20°'nin üstünde tel boyu tutmadı.
Çözüm: alt çubuğa göz ekseninin altında bir tel kolu eklendi (`ALT_KOL`: r 11, θ −118 → −78, x −13.2, orta blok ile alt kapak iç bandı arasında). Bu nokta kapanırken ~+Z yönünde 7.5 mm ilerliyor. Servo plakanın altına alındı (ped 28.7 → 7.7, alçak ped kodu yaw ile aynı), kol r 14 → 10, nötrde −24°. Tel neredeyse yatay (y 23 → 20). Tel yaw tellerinin (y ≥ 27) altından geçiyor ve yaw kolunun |x| ≤ 12.1 süpürmesinin dışında kalıyor. Kapak 0..40° için servo 0..−44° dönüyor, doğrusal ve her pozda çözülüyor.
Alternatifler: (a) önceki aday, yani mil (−31.3, 40) ve r 16: sol üst kapak servosu ile çakışıyordu. (b) X milli yatay servo (paralel düzlemde 4-çubuk): yeni bir B1 braketi gerektiriyordu, seçilmedi.

## Süpürme çakışmaları için yerleşim kaydırmaları
- Üst kapak kapalı aralığının üst kenarı 60 → 55 (kabuk ve yan köprü). Yaw −32/pitch −24 pozunda göz yaw kolu, kapağın arka kenarına 2° giriyordu.
- Pitch servosu mil x 18 → 20.5 (pitch çubuğu tel kulağı x 8.5): yaw kolu, ±27° süpürmede pitch servo gövdesine giriyordu.
- Üst kapak servoları mil x ±38 → ±37: kolun ucu (r 9 + 2.6) B3 ön direğine 0.3 mm yaklaşıyordu.
- B1 ön kenarında |x| 14..16.6, z 54..60 bölgesine çentik açıldı: alt kapak iç kolu kapanırken plakanın ön kenarına iniyordu.
- B3 kenar kaburgasında B1'in arka plakası, arka dili ve arka direk tabanı için (+0.4) boşluk bırakıldı: B1 × B3 arka dil kesişimi 8 mm³'tü.
- Alçak pedli SG90 (yaw, alt) için plaka açıklığı yerel x −11.5 → −12.6: kablo çıkışı çıkıntısı yukarı sökmede plakaya takılıyordu.

## B2 tek gövde
Burun köprüsü, kaş kemerine ve armut kenarına 8 mm genişliğinde iki blokla bağlandı. Kamera çerçevesi zaten bağlıydı; ayrık gövde köprüydü.

## G4 bindirme dili
Boss, dilin üstünde (aynı Y bandında) yer alıyordu ve G4L × G4R kesişimi 1.5 cm³'tü. Boss dilin ALTINA taşındı (tek blok, iki vida, kendi yarısının z ±50 kaburgasına bağlı). Somun tuzağı boss tabanında. Orta bölgede (|x| < 12.4) kaburgalar dilin 0.4 altına kadar boşaltıldı. Dilin kökü kendi üst plakasına bağlandı.

## Destek listesi (havada ada kararı)
Aşağıdaki parçalar ağaç destekle basılacak, ada bulgusu not olarak raporlanıyor (`params.DESTEKLI`). Diğer bütün parçalar desteksiz ve adasız.
B1 (alt kulaklar), B2 (kemer/köprü/diş sırası), B3L/B3R (kaburga uçları), B4 (çene kolu ucu), B5a (pivot diskleri), B5d_L/R (0.05 mm² tesselasyon kenarı), B5g_L/R (pitch kulağı), G1 (omur/kart tablası çıkıntıları), G2L/G2R (kaburga uçları). Yön değişimi denenmedi: organik formlarda tek düz taban yok.

## B1 hafifletme (yarım)
Plakada açgözlü daire delik yerleşimi kullanıldı (delik + 2 mm et halkası, hiçbir özelliğe ve kenarın 2.5 mm içine girmiyor) ve PCA dik plakasına 40×22 pencere açıldı. Sonuç 58.4 → 54.6 g (dilimleyici yaklaşımı), hedef ≤ 45 g'a ulaşılamadı. Bu kütle modelinde ince levhanın kütlesi yüzey alanıyla orantılı. Kalan 25.7 g plakada; ön/yan bölgeler servo cepleri, kulaklar ve REZERV yük yolu (roll/rotil kulakları) ile dolu. Açık iş (STATE).

# ESTETIK TUR (2026-10-17, 3. oturum)

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

# ESTETIK TUR 2 (2026-10-17, 4. oturum): "gozluk gibi" duzeltmesi, mekanizmaya dokunulmadi

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

# CP3b-2 (2026-10-17, boyun mekanizmasi) - ara

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

## ORBITA TURU (2026-10-17): oyulmus goz cukuru (kullanici: "gozluk takiyor gibi")
- Kok neden: eklenen halka/huni, arkasinda ve yaninda yuzey yok. Cozum: ust yuz tek surekli kabuk (`_YUZ` satir tablosu, `serit` 1.6), cukurlar boolean ile oyulur (`_loft` bukey halka zarflari). Eski `_orb_ic`, `_orbita`, alin rafi, frontal zigoma `yassi_tup`, burun koprusu ust kutusu silindi. Kenar = oyugun kenari (ekli tup YOK; tur 1'de denenen supraorbital/yanal tup gozluk cercevesi gibi okundugu icin tur 2'de kaldirildi).
- Mekanizma sabit: yeni kabuk `zarf_b2.py` yasak zarfindan cikarilir. Zarf = 81 goz/kapak pozu + cene 0..CENE_ACI (5 deg adim) hareketli gruplar + montaj-sokme supurmeleri (B2 -Y cikar -> digerleri +Y 50 mm/1 mm adim; B3 +-X 40; B4/C1/rod -Y) + P2 rezervi; 6 eksen x 0.6 + yuz bolgesinde 26 yon x 0.45 buyutme. Sadece eksen buyutmesi kosegen yuzeylerde 0.35 kalip B2 x B5e 0.000 mm (411 bulgu) verdi -> 26 yon eklendi. Zarf kesiminden kopan adaciklar atilir (build ciktisinda listelenir, en buyugu ~180 mm3).
- Sonuc: cukur tavani B2'de olamaz (B5 +Y sokulur). Derin duvar z 66'da biter.
- Acik: Z1 (kure<->B2 1.02 nominal) ve et_yapisal B2 %14.6 -> STATE.

# CP3b-2 devam (2026-10-17)
- **Yay yeniden konumlandi (gercek AM ile):** CAD bas AM (3.7, 28.8, 8.8) planin (19.8 one) cok gerisinde; bas +17 deg'de kendiliginden dengede. Pivotun dik altindaki ankraj %75'i tutturamiyordu (oran -3..+7). En kucuk kareler taramasi (_tmp/cp2/yay2.py): kafa kulagi (8, -2, -54), ankraj (8, -45, -118), k 0.020 N/mm, etkin sifir boy 22.8 -> oran 0.77, en buyuk sapma 0.033 kg*cm. 5 delik yay hatti boyunca 9 mm arayla (on gerilme ayari): oran 0.57..0.96 (KAGIT %60-95 kapsar).
- **Yay kulagi x 0 -> x 8 (B1_boyun icinde eski kulak kesildi):** roll pimi M4x40 arkadan (+Z) takiliyor (onde sg90_yaw govdesi var); x 0 kulagi pim yolunu kapatiyordu (montaj_sokme ile bulundu).
- **Egme servo montaji:** servo ortadan asagi indirilip disari (+-X) kaydirilir (kulaklar braket ic yuzunde) - N2'den ONCE. Krank asagi + 8 mm yana. Rod grubu (iki rotil + rod + kilif) bastan ONCE kranka takilir, bas indirilince ust rotil vidalanir.
- **Braket arka kosegeni kaldirildi, braket z -64'e kadar:** P1 dis tupu pitch +13 / roll 15'te 0.11 mm yaklasiyordu (poz_kilit buldu).
- **PLAN SAPMASI: P2 yanak pistonu bu turda kurulmadi.** Neden: plan ust ucu B2'de; B2 paralel ajanin calisma alaninda (dokunma yasagi). B1'e baglanan duzlemsel varyant mandibula govdesinin (x 50-57, y -40..-60) icinden geciyor, disindan gecen varyant (x >= 60) icin B4'e yeni kulak + B2 elmacik olcusu gerekiyor. B2 serbest kalinca plan yerinden (B2 kulagi -> B4) mentese uclu (duzlemsel hareket, kardan gerekmez; strok ~10, bindirme yeterli - hesap STATE_CP3b2). Yer tutucu satin.rezerv'de, kutle PLAN tahmini (6 g).
- Yeni check'lerin kendi testi: `checks/test_bust_cp3b2_ekleri.py` (strok 65>60 ve cozumsuz poz yakalanir; diferansiyel J^-T dogrulanir ve pay 1.25 < 1.5 yakalanir; poz_kilit bilinen engelde alt siniri bulur ve hedef ihlalini yakalar).

# CP3b-2 plan sapmalari (baslik bicimi; gerekceler yukaridaki "CP3b-2" bolumlerinde)
## PLAN SAPMASI: pitch pimi 1x M4x40 -> 2x M4x14 saplama
Neden: roll (Z) ve pitch (X) eksenleri U-mafsal merkezinde kesisiyor; roll M4x40 B1 kulaklari + hactan geciyor, pitch iki yandan catal disindan hac icine 3.3 kendinden kilavuzlu (PLAN I13).
## PLAN SAPMASI: P1 SCM yeri (+-55, -10, -20) -> mastoid alti (+-42, -4, -30) -> N1 arka kolu
Neden: plan yeri bas -25'te gonion'a 4 mm (piston r 5) ve K5 kardan yigini ile bindirme 8 mm; yeni yerde strok 34.5, bindirme 31, kardan pim1 +-18.7.
## PLAN SAPMASI: N5 kilif et 0.8 -> 1.2
Neden: PETG yok; PLA 0.8 iki cevre (kapak karari ile ayni).
## PLAN SAPMASI: P2 yanak pistonu kurulmadi (B2 kilitli)
Neden: ust ucu B2'de; B2 paralel ajanin alani. B1'e baglanan varyant mandibula govdesinden geciyor. B2 serbest kalinca mentese uclu duzlemsel P2 (STATE_CP3b2 acik is 1).

# ESTETIK TUR 3 (2026-10-17, paralel cad_estetik/): orbita_tavan / kubbe_kenar / sakak, params.ESTETIK ile ayri ayri geri alinabilir
- Her anahtar False -> eski kod yolu birebir (dogrulandi: ucu False build'inde B2 39.35, B3L 46.864, B3R 45.774 cm3 = degismemis kodun bugunku ciktisi; cache'teki eski B3 46.724/45.587 bayatti).
- **orbita_tavan (B3):** B5 +Y ile cikarildigi icin B2'de goz ustu yok (supurme kesigi = ustten acik yarik). B3 en son takilir, +-X cikar; B2'nin sakak duvari y <= 54.3'te her z'de oldugundan tavan B2 ust sinirinin ALTINA inemez. Bu yuzden tavan = y >= 55.0'da, kas satiri (y 49.5) 3 mm gerisinden baslayip kubbe yuzeyine egimle kaynayan 1.6 alin plakasi (serit, 4 satir). z > 40'ta B3 disi hicbir parca y > 49 degil. 1. deneme duz yatay plaka -> "kask siperi" etkisini artirdi, atildi; 2. deneme egimli alin.
- **kubbe_kenar (B3):** alt kenar basamaklari kosinus gecis: on z 16..44 (46 -> 54.5), arka z -74..-60 (10 -> 46); kenar kaburgasi = bolge - (bolge +4 y ve +-3 z kaydirmalarinin kesisimi). Yalniz malzeme kaldiran / B2'nin arkasinda kalan bolge. Gorsel etkisi kucuk (STATE_estetik).
- **sakak (B2):** _YUZ satirlarinin son 3 noktasi params.EST_SAKAK: kas ucu (y 49.5) ve elmacik satirlari (y 16, 7) disari, orta satirlar (y 30, 44) B5a supurme zarfinin (|x| <= ~57.6) hemen disinda -> 5..8 mm icbukey temporal cukur; son noktalar 6..9 mm geri (z 44..47). Orbita oyugu (_zyuz) eski tabloyu kullanir, goz cukuru degismez. Ice cokertme denenmedi: B5a cerceve +Y supurmesi |x| < 57 bolgesini zaten kesiyor (delik olurdu).

# ESTETIK TUR 3 / 2. bolum (2026-10-17, T-800 referansi ref_t800/ORANLAR.md): kas_kemeri + sakak_pencere, orbita_tavan=False
- Koordinator/kullanici: tavan "sapka siperi", sakak farki az, kubbe yuze oturtulmus kask. kubbe_kenar begenildi (kaldi), orbita_tavan False.
- **kas_kemeri (B3 + B2):** kas bandi B3'e tasindi. B5 +Y cikar (B3'ten SONRA cikar: sokme sirasi B3L, B3R ilk), B3 +-X en son takilir -> goz ustunde malzeme ancak B3'te olabilir ve B2 o y bandinda olmamali: B2 y <= 47.0'a kirpilir (eski kas satirlari 49.5/53.5 + glabella ustu gider), B3 kas alt yuzu y 48.6 + 1.6 kemer (kapak supurmesi 47.8, B5g 47.4). Kas onu min(104, kubbe + 5.5) (goz +27 mm, ORANLAR #2: 30). Basamaksiz alin icin kubbe kabugu z'de gerdirilir (z > 4: k(y) = 1 + 0.11 t^0.8, y 60 -> 136 sonumlenir; ayni warp detaylara). Duz alin plakasi + kubbe kesimi denendi (tur 2.1): siperlik gibi okundu, atildi.
- **sakak_pencere (B3):** once alt kenari oval yayla kaldirmak denendi (tur 2.1) -> tum yan acildi, ref'te pencere kapali. Son: yan duvarda kapali oval delik (z -48..36, y 50..90, 84 x 40; ref 90 x 70 ama y < 46 alani mekanizma nedeniyle zaten acik) + 1.6 genis 8 mm ice donen dudak. Alt bant y 46..50 kalir -> on direk sekmesi kabuga bagli kalir.
- **YAPILMADI (kisit):** kubbe arka-alt kenari goz hizasina indirilmedi: z -52..-58'de B1 arka direk (x 42..48, y <= 46) ve cene krank C1 (x 61.4..65.4, y <= 42, z -26..-14) kabuk icinde kaliyor; arka (z < -60) zaten y 10..13'e iniyor. Pencere altinda (y < 46) kapali sakak kemigi yok: ayni neden (C1 + B1 aski). Panel cizgileri referanstaki gibi islenmedi (butce).
