Rynnat/endoskull/versions/v11/README.md

# Project Bust v11 — CP3b-2 ara hali: boyun mekanizması CAD (N1–N5, Y1, P1)
Kontroller henüz bağlanmadı; baskıya gönderme.
