Rynnat/endoskull/versions/v12/README.md

# Project Bust v12 — CAD SIM
Gerçek CAD parçaları + CAD kinematiğinden eklem tabloları (göz 9x9, kapaklar, çene, boyun pitch x roll) + v6 hareket motoru (fare/otonom/kamera yüz takibi/mikrofon/TTS hoparlör) + çene-eğme kilidi (check_report_boyun). Üretim: research_notes/Project Bust/cad/sim_export.py
