Rynnat/endoskull/versions/v3/README.md

# Project Bust v3 — detaylı görsel

Gölgeler, fırçalanmış metal, kırmızı göz parıltısı + göz çukuru ışığı, diş eti / cıvata detayları, kaburga kemik/kıkırdak ayrımı, kablo demetleri, yazılı kaide, Döndür düğmesi, T-800 tarzı boyun pistonları.
Bilinen sorun: boyun pistonları ramusun ÖNÜNDEN geçiyor → baş ~5°'den fazla eğilemiyor (kilit). v4'te düzeltildi.
