Rynnat/endoskull/versions/v4/README.md

# Project Bust v4 — boyun pistonları ramus arkasında (güncel)

v3 + yan boyun pistonları ense yanına alındı (ramusun arkasından iner); kilit yalnız aşağı eğmeyi sınırlar. Ölçüm (adım adım sim): nötr boşluk 28 mm, çene kapalı −21°, çene açık −8°.
Kaynak notlar ve kararlar: research_notes/Project Bust/ (KARARLAR.md bağlayıcı).
