Rynnat/endoskull/versions/v7/README.md

# Project Bust v7 — CAD önizleme (CP3b-1, kontroller TEMİZ DEĞİL: SORUN 33)
Gerçek CadQuery parçaları (31 STL), nötr poz. Mavi yarı saydam = CP3b-2 yer tutucuları (boyun, eğme, yay, pistonlar).
Baş 437.9 g / 500. Açık: gövde statik çakışmaları, montaj sökme, çene servo vida aleti yolu, Z2 toleransı, B1 54.6 g > 45.
Kaynak: research_notes/Project Bust/cad/ (onizleme.py ile üretildi). Baskıya gönderme.
