Rynnat/endoskull/versions/v8/README.md

# Project Bust v8 — CAD önizleme, estetik tur (SORUN 23, temiz değil)
v7 + maksilla/elmacık/burun açıklığı, anatomik mandibula (gonial açı, ramus, çene ucu), yassı kaburgalar, S köprücük, akromion + humerus başı. Baş 446.3 g / 500. Mekanizma değişmedi. Baskıya gönderme.
