Rynnat/endoskull/versions/v10/README.md

# Project Bust v10 — orbita sıfırdan (oyulmuş göz çukurları), ara hal
Yüz üst yarısı sürekli kemik kütlesi; orbitalar boolean ile oyuldu. Açık: kubbe-alın geçişi kask gibi, gözler sığ. Baskıya gönderme.
