Rynnat/endoskull/versions/v5/README.md

# Project Bust v5 — insan iskeleti kabartmaları

v4 + gerçek omur biçimi (gövde, disk, arka kemer, arkaya-aşağı diken, yan çıkıntılar; C7 uzun diken), göğüs omurları T1–T5, kaburga başları, üçgen kürek kemiği + spina + akromion, köşeli (süperelips) göz çukuru kenarı + dış sütun, şakak çizgisi, mastoid, ense çizgisi ve çıkıntısı, şakakta soğutma yarıkları (girinti), sivri köpek dişleri, çene ucu çıkıntısı.
Kütle notu: kabartmalar ince sırt (birkaç g), girintiler kafayı hafifletir.
