Rynnat/endoskull/versions/v9/README.md

# Project Bust v9 — 2. estetik tur son hali (SORUN 23, temiz değil)
Tek tek dişler (köpek dişi sivri), göz çukuru kenarları kalınlaştı/kafaya bağlandı, burun plakası. Ajan bitmeden alınan ara görüntü. Baskıya gönderme.
