Rynnat/endoskull/research/cad/ref/boyun_adim1_arka3q.png

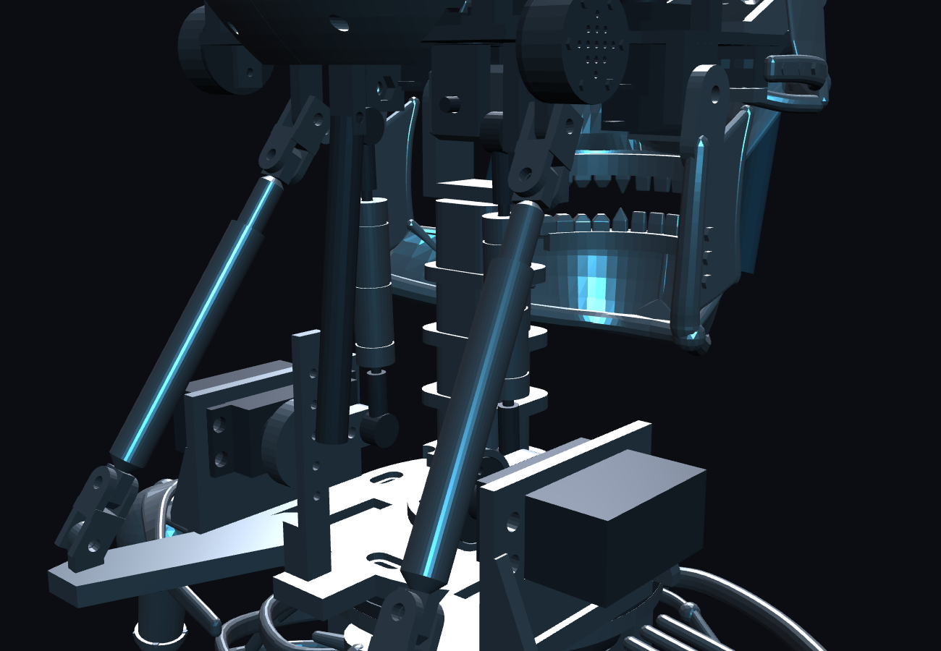
research/cad/ref/boyun_adim1_arka3q.png
