Rynnat/endoskull/research/cad/ref/boyun_adim1_yan.png

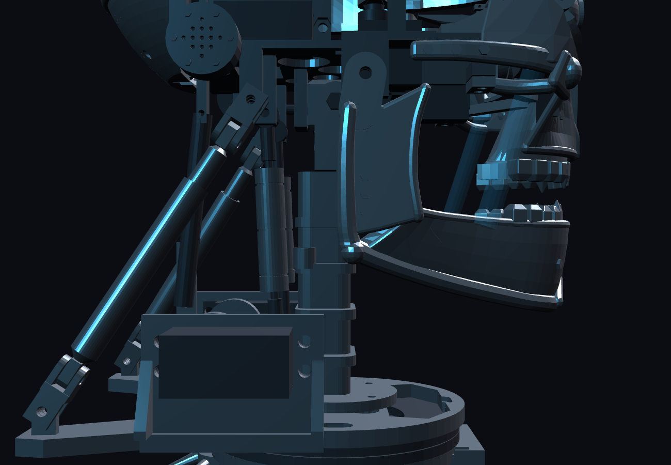
research/cad/ref/boyun_adim1_yan.png
