Rynnat/endoskull/research/cad/ref/boyun_adim2_arka.png

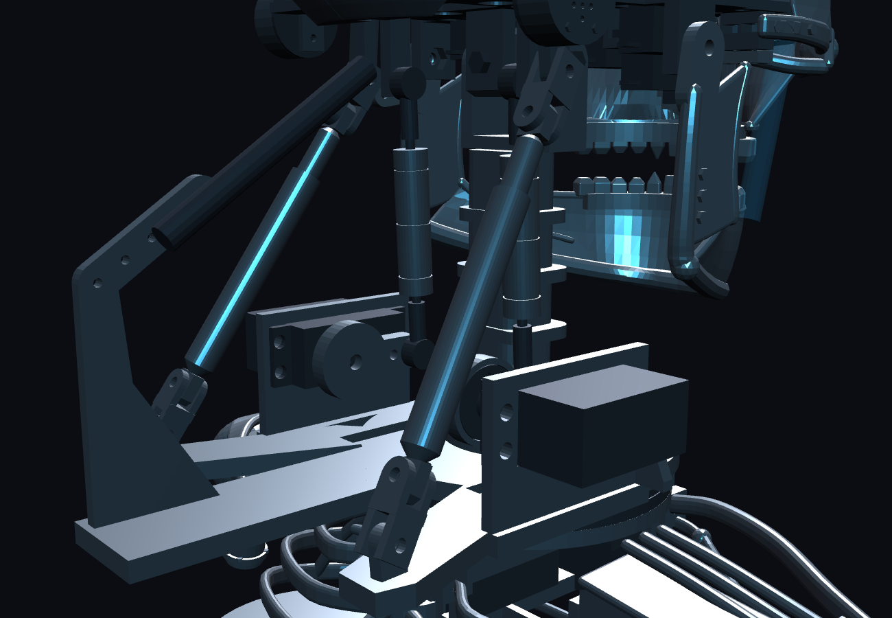
research/cad/ref/boyun_adim2_arka.png
