Rynnat/endoskull/research/cad/ref/boyun_adim2_on3q.png

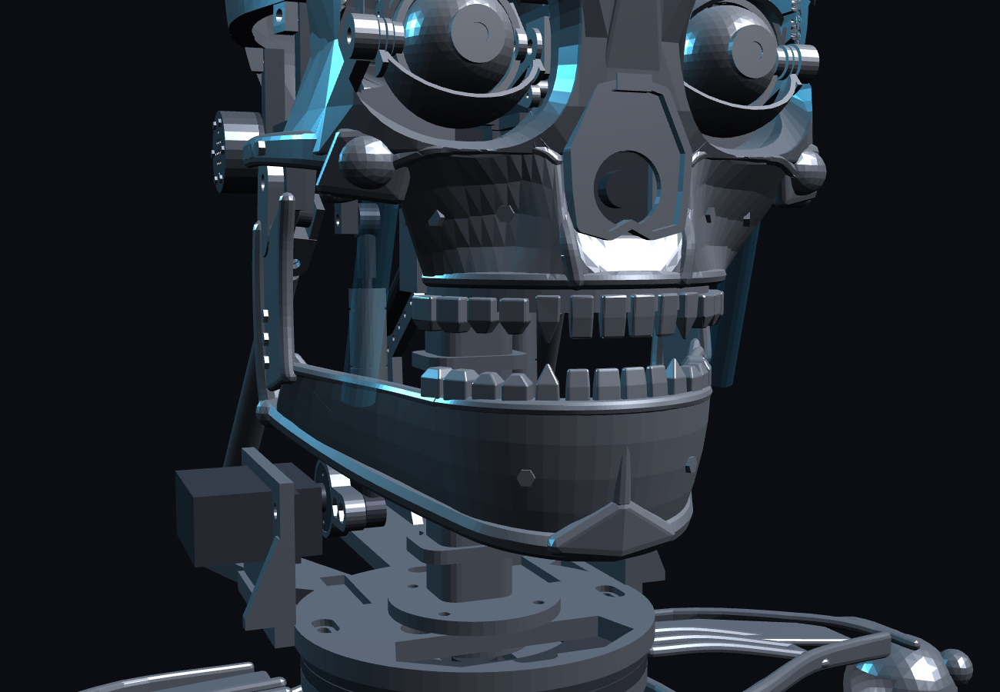
research/cad/ref/boyun_adim2_on3q.png
