Rynnat/endoskull/research/cad/ref/boyun_adim2_yan.png

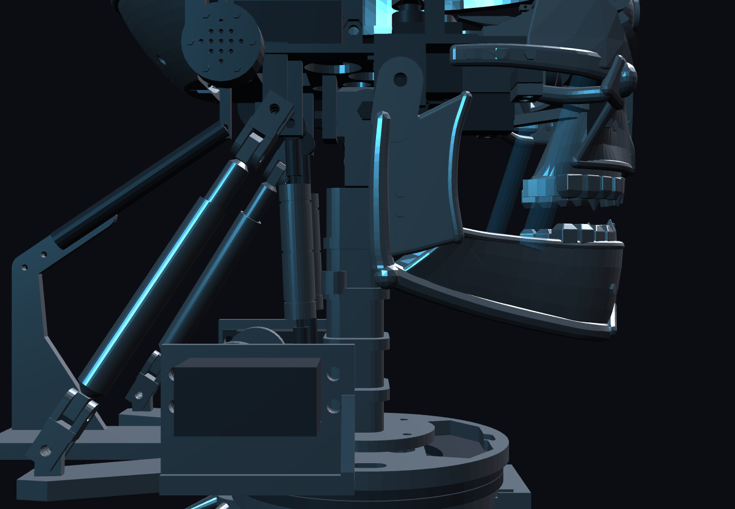
research/cad/ref/boyun_adim2_yan.png
