Rynnat/endoskull/research/cad/ref/cad_estetik2_3q.png

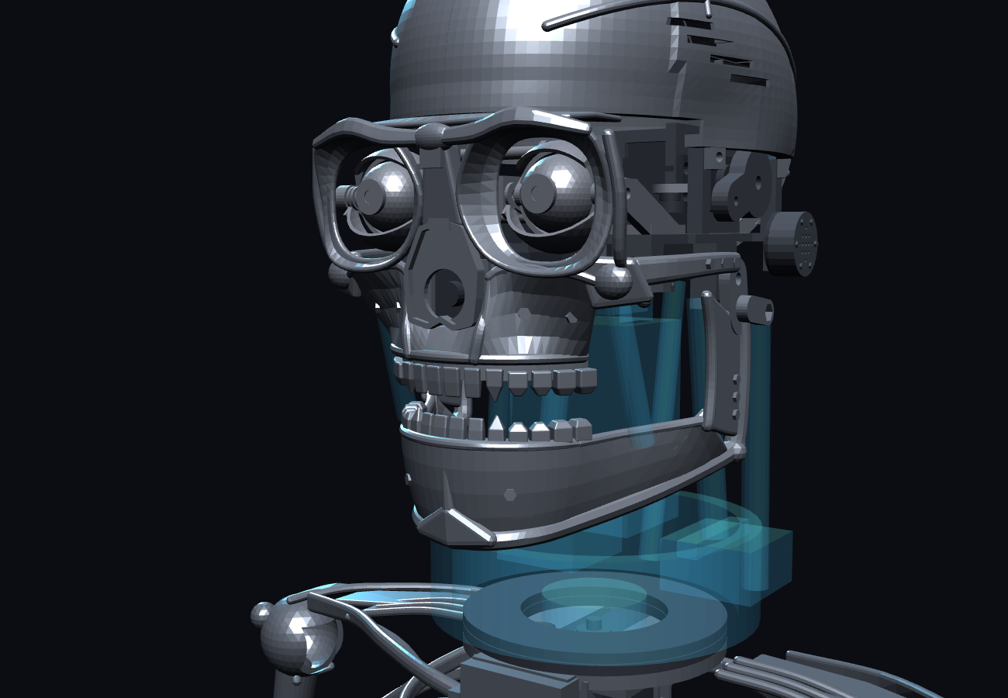
research/cad/ref/cad_estetik2_3q.png
