Rynnat/endoskull/research/cad/ref/cad_estetik2_on.png

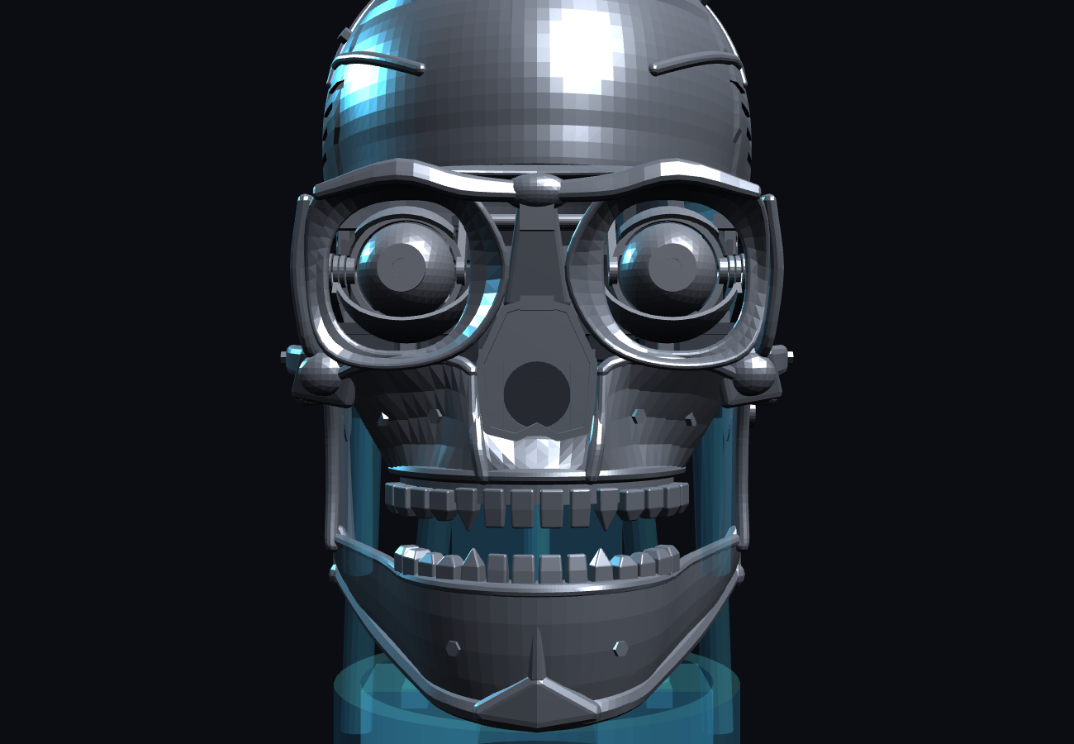
research/cad/ref/cad_estetik2_on.png
