Rynnat/endoskull/research/cad/ref/cad_estetik2_yuz.png

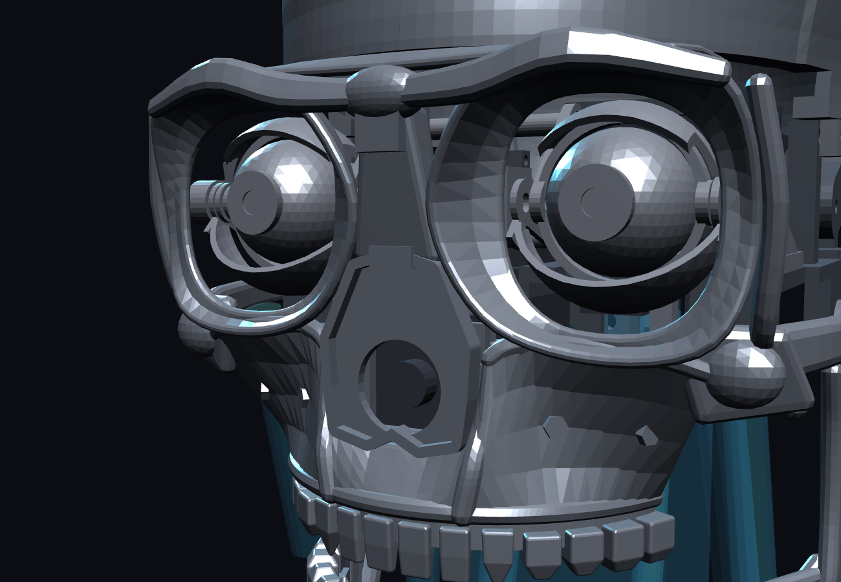
research/cad/ref/cad_estetik2_yuz.png
