Rynnat/endoskull/research/cad/ref/cad_estetik_3q.png

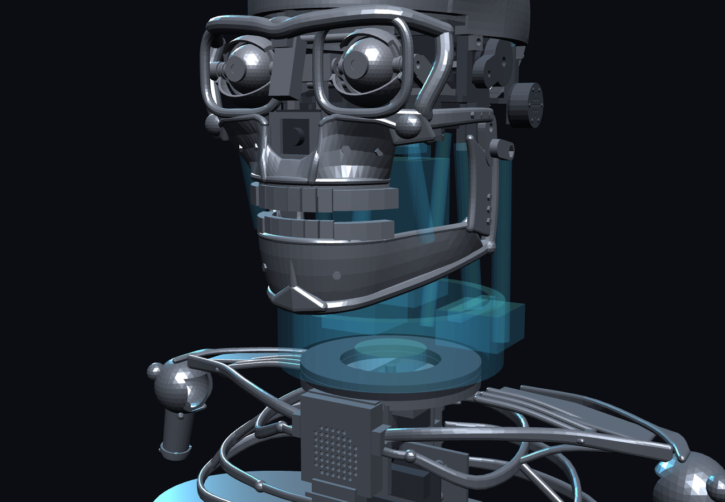
research/cad/ref/cad_estetik_3q.png
