Rynnat/endoskull/research/cad/ref/cad_estetik_on.png

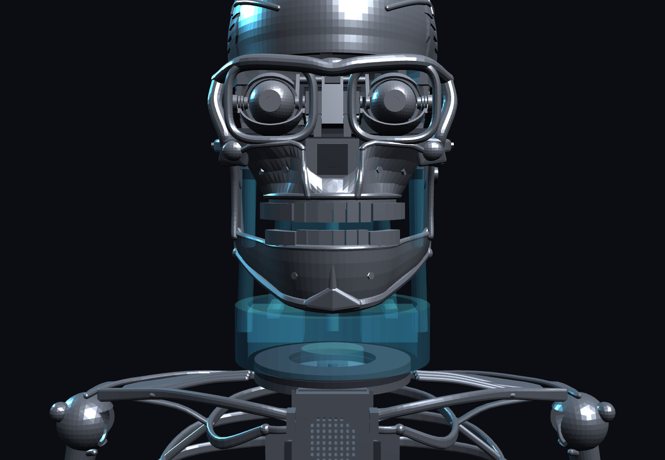
research/cad/ref/cad_estetik_on.png
