Rynnat/endoskull/research/cad/ref/cad_estetik_yan.png

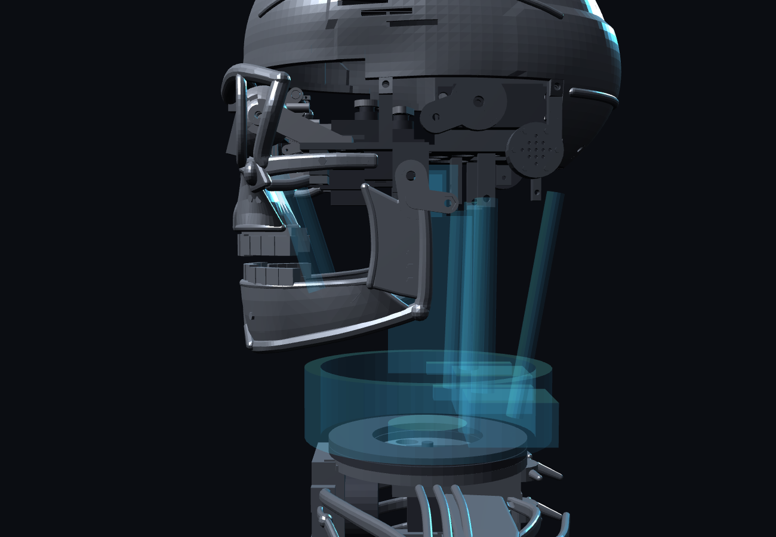
research/cad/ref/cad_estetik_yan.png
