Rynnat/endoskull/research/cad/ref/cad_estetik_yuz3q.png

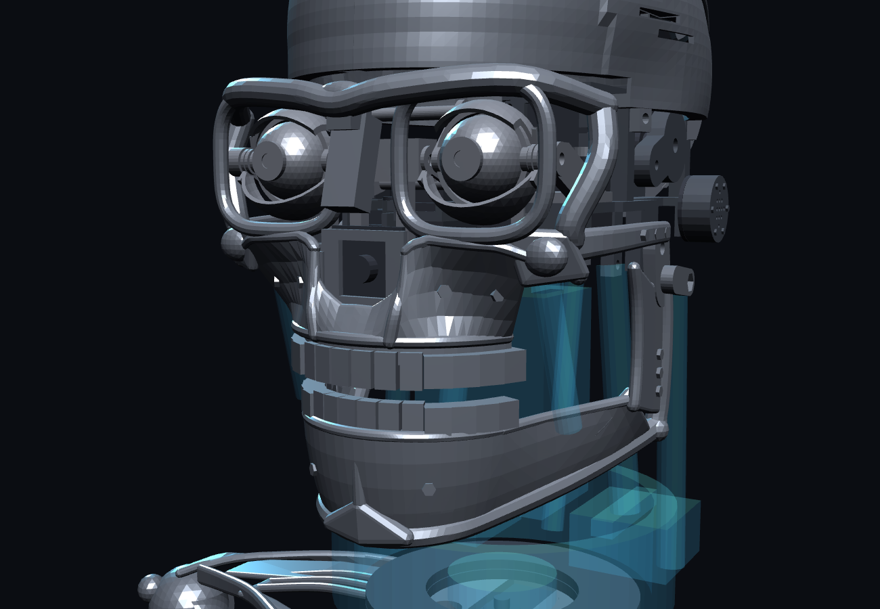
research/cad/ref/cad_estetik_yuz3q.png
