Rynnat/endoskull/research/cad/ref/cad_v7_3q.png

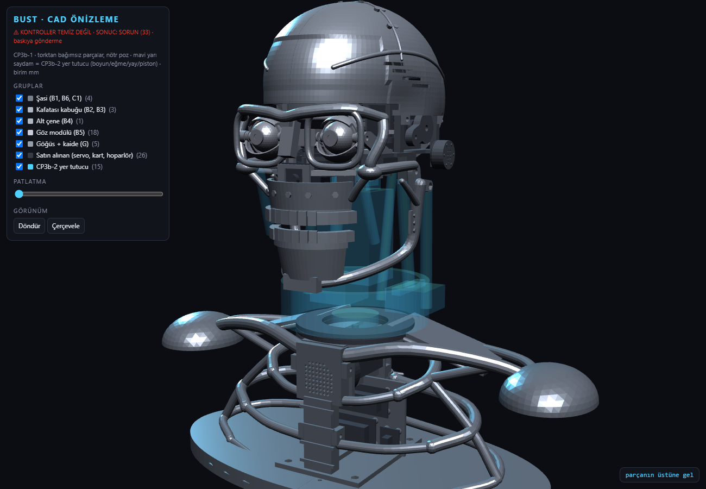
research/cad/ref/cad_v7_3q.png
