Rynnat/endoskull/research/cad/ref/konsept_3q.png

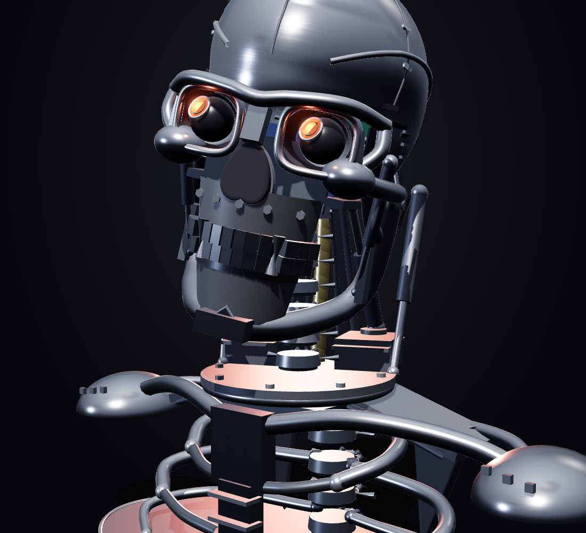
research/cad/ref/konsept_3q.png
