Rynnat/endoskull/research/cad/ref/konsept_on.png

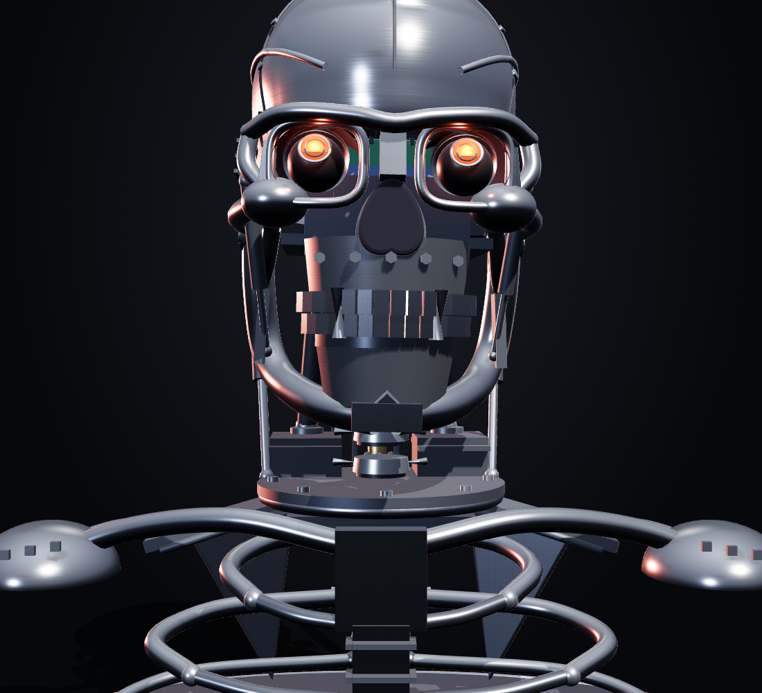
research/cad/ref/konsept_on.png
