Rynnat/endoskull/research/cad/ref/konsept_yan.png

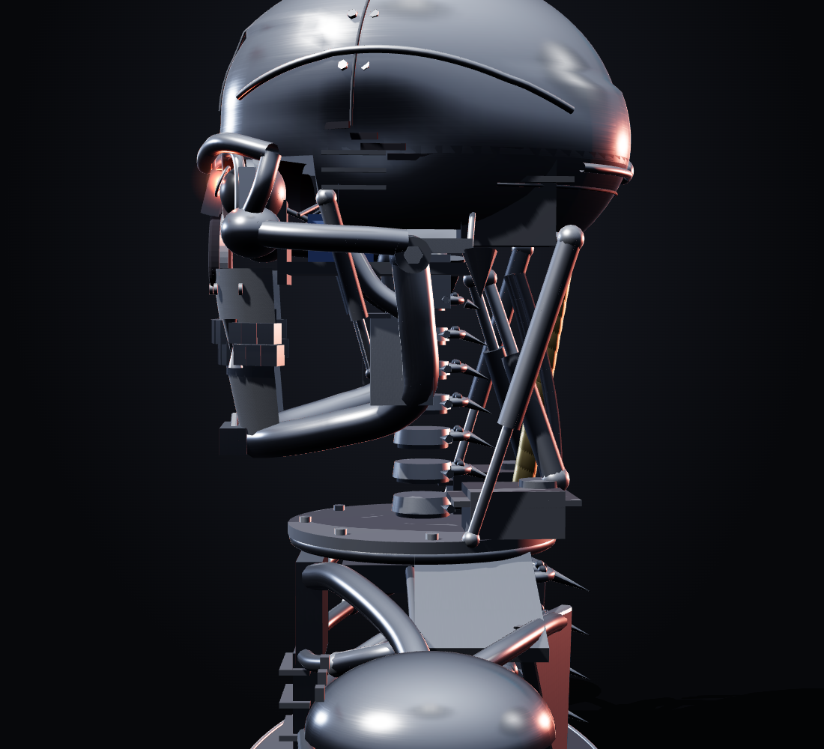
research/cad/ref/konsept_yan.png
