Rynnat/endoskull/research/cad/ref/omurga2_arka34.png

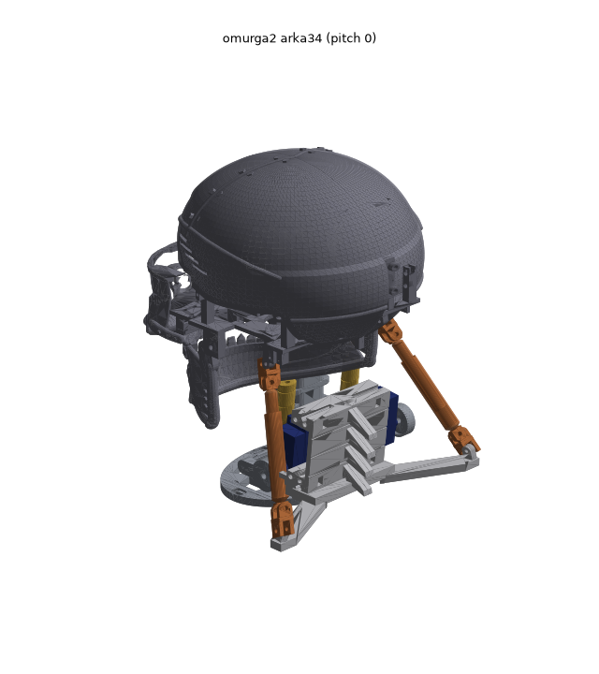
research/cad/ref/omurga2_arka34.png
