Rynnat/endoskull/research/cad/ref/omurga2_karsilastirma.png

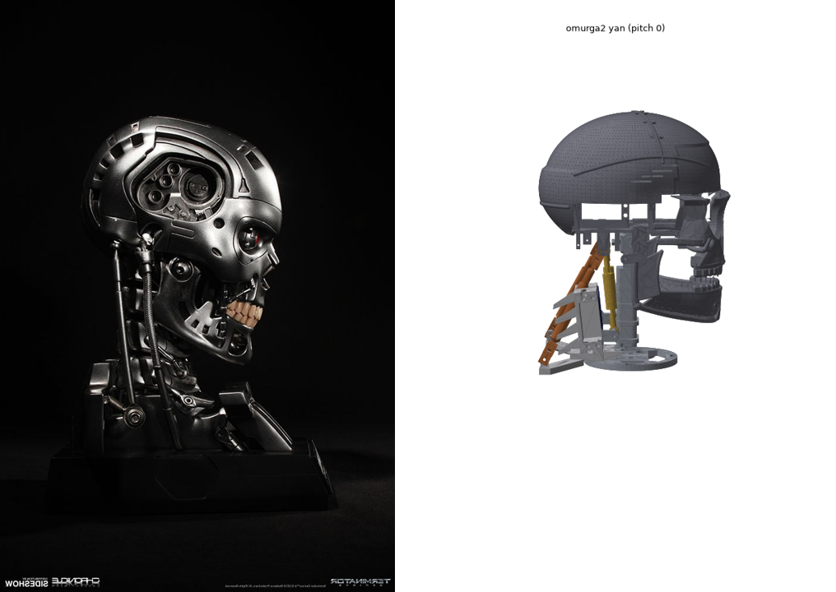
research/cad/ref/omurga2_karsilastirma.png
