Rynnat/endoskull/research/cad/ref/omurga2_on34.png

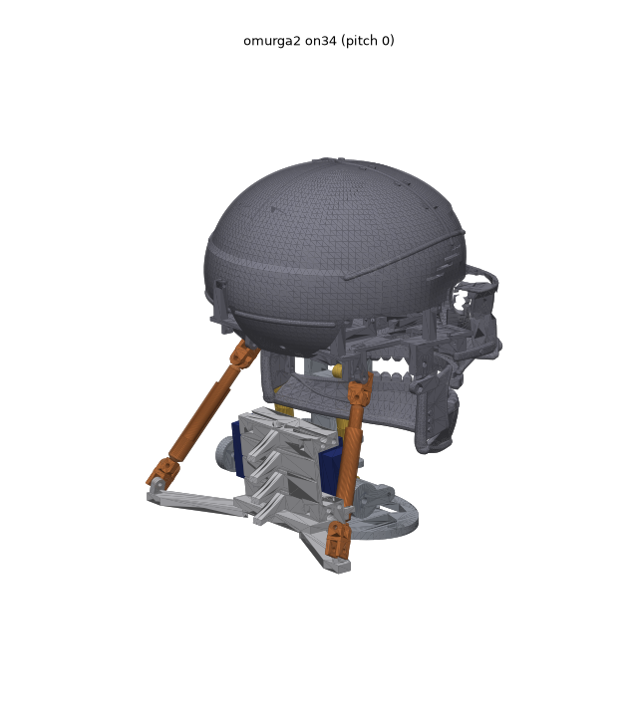
research/cad/ref/omurga2_on34.png
