Rynnat/endoskull/research/cad/ref/omurga2_yan.png

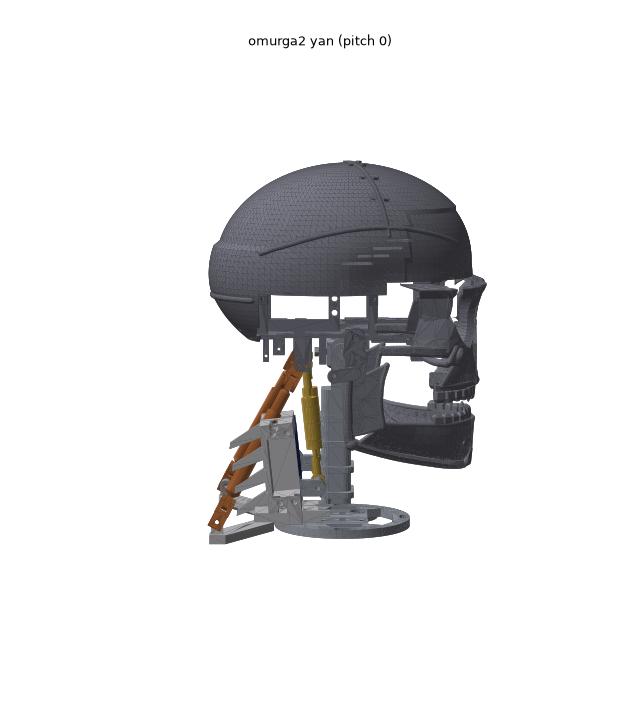
research/cad/ref/omurga2_yan.png
