Rynnat/endoskull/research/cad/ref/omurga_arka34.png

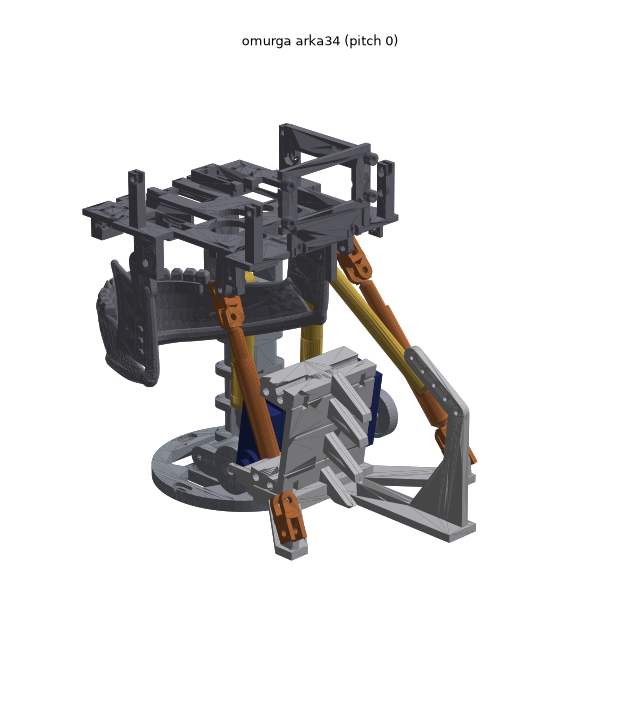
research/cad/ref/omurga_arka34.png
