Rynnat/endoskull/research/cad/ref/omurga_arka.png

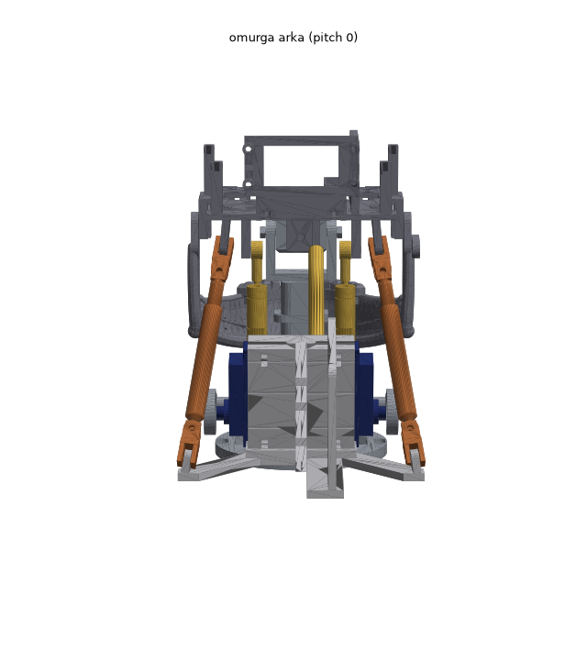
research/cad/ref/omurga_arka.png
