Rynnat/endoskull/research/cad/ref/omurga_yan.png

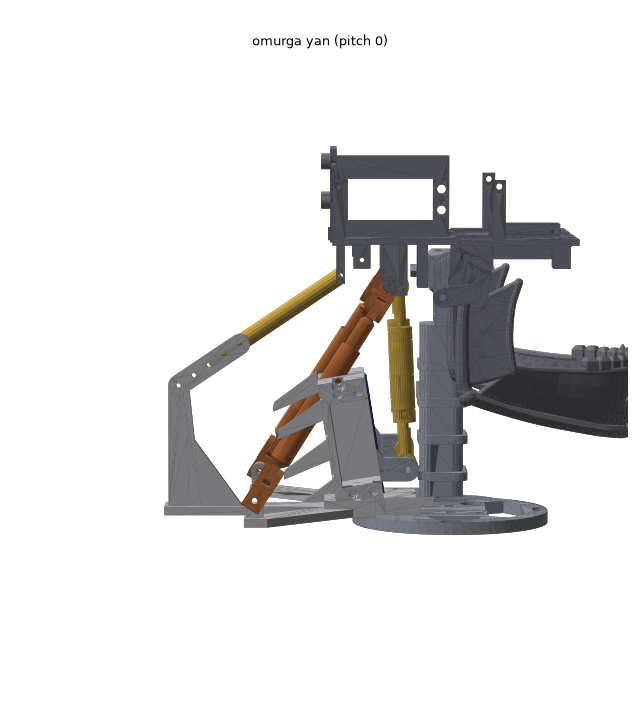
research/cad/ref/omurga_yan.png
