Rynnat/endoskull/research/cad/ref/orbita_tur1_yuz.png

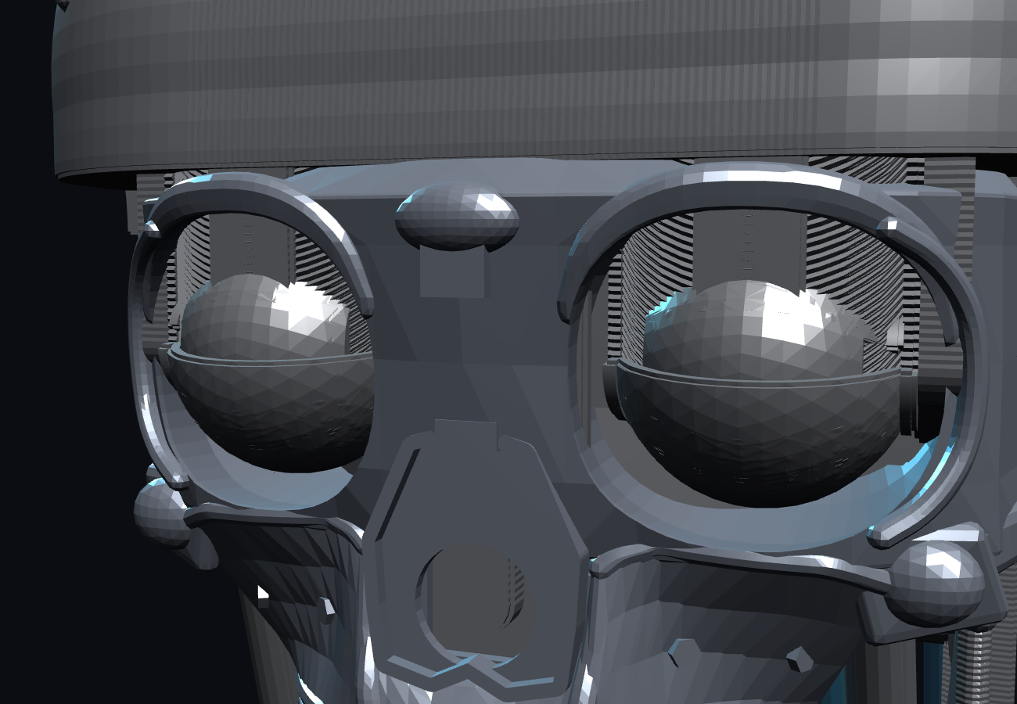
research/cad/ref/orbita_tur1_yuz.png
