Rynnat/endoskull/research/cad/ref/orbita_tur2_yuz.png

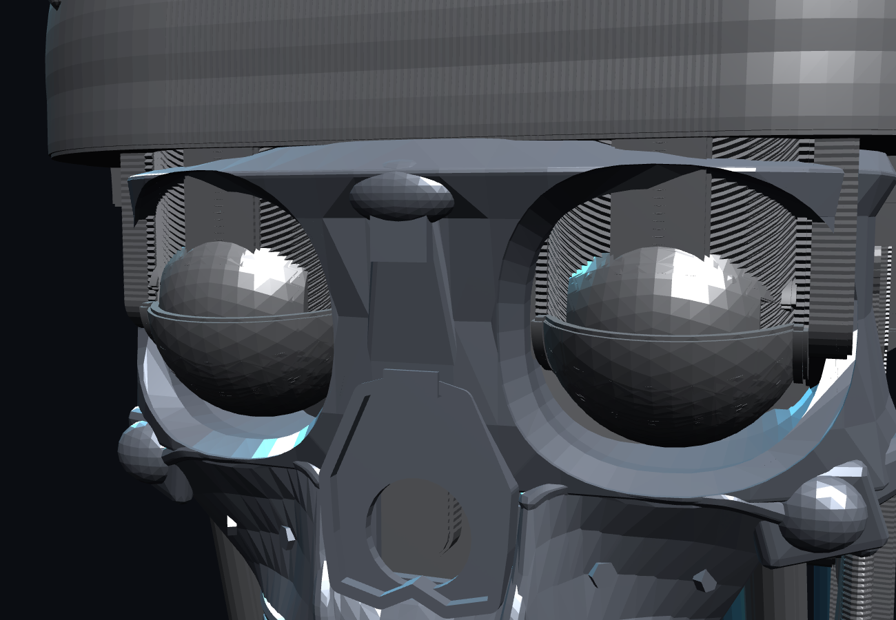
research/cad/ref/orbita_tur2_yuz.png
