Rynnat/endoskull/research/cad_estetik/ref/estetik_hepsi.png

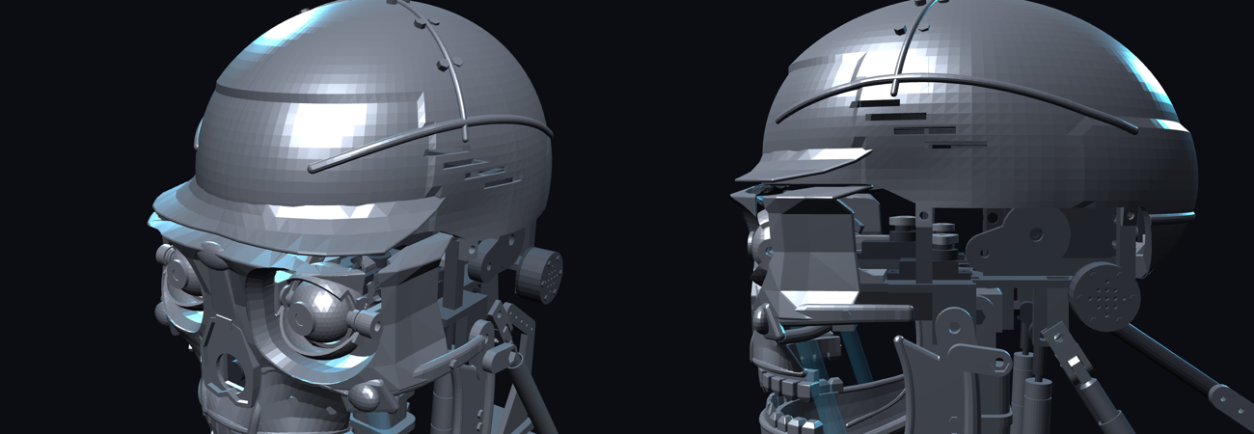
research/cad_estetik/ref/estetik_hepsi.png
