Rynnat/endoskull/research/cad_estetik/ref/kars_on34_1.png

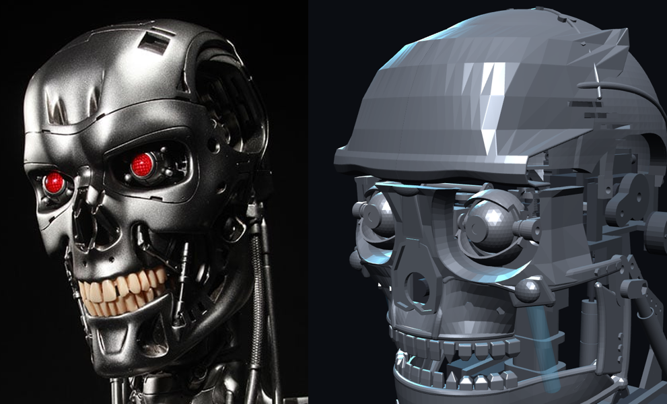
research/cad_estetik/ref/kars_on34_1.png
