Rynnat/endoskull/research/cad_estetik/ref/kars_on34_2.png

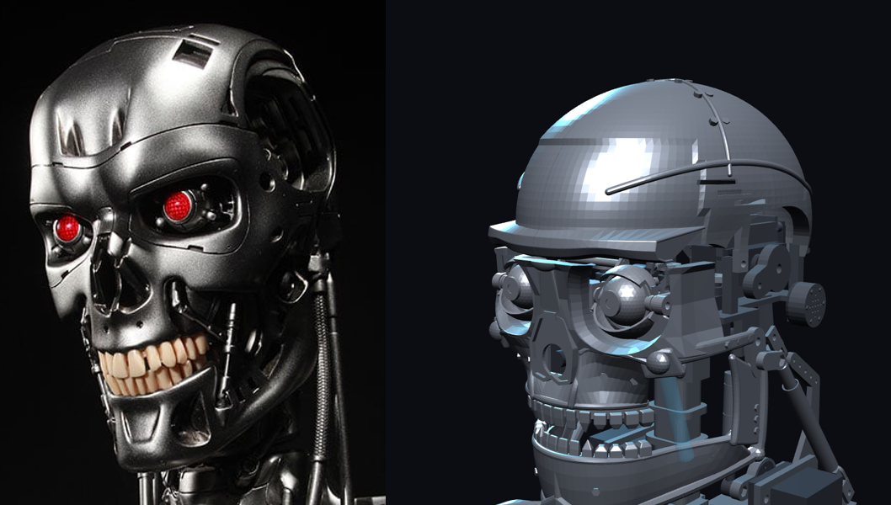
research/cad_estetik/ref/kars_on34_2.png
