Rynnat/endoskull/research/cad_estetik/ref/kars_on_2.png

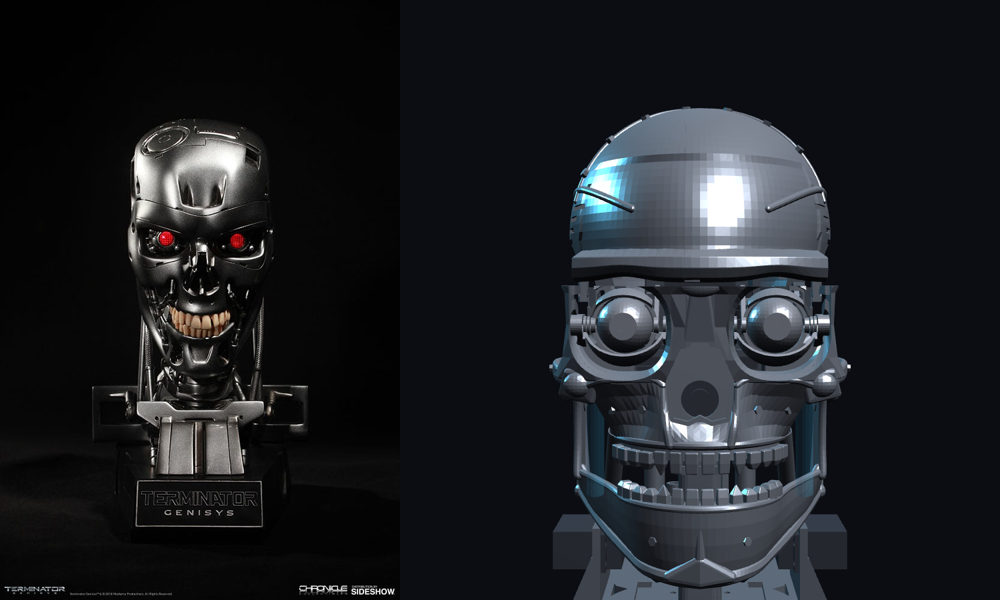
research/cad_estetik/ref/kars_on_2.png
