Rynnat/endoskull/research/cad_estetik/ref/kars_yan_1.png

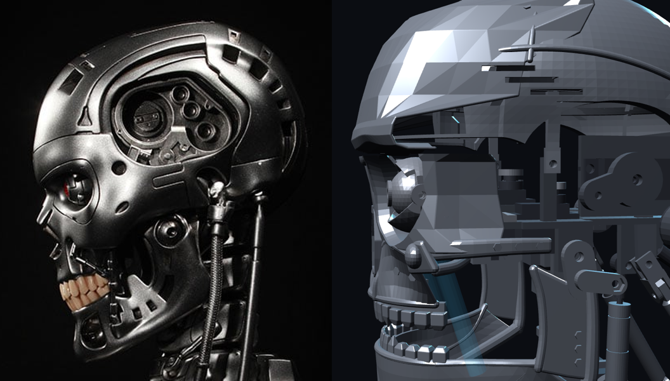
research/cad_estetik/ref/kars_yan_1.png
