Rynnat/endoskull/research/cad_estetik/ref/kars_yan_2.png

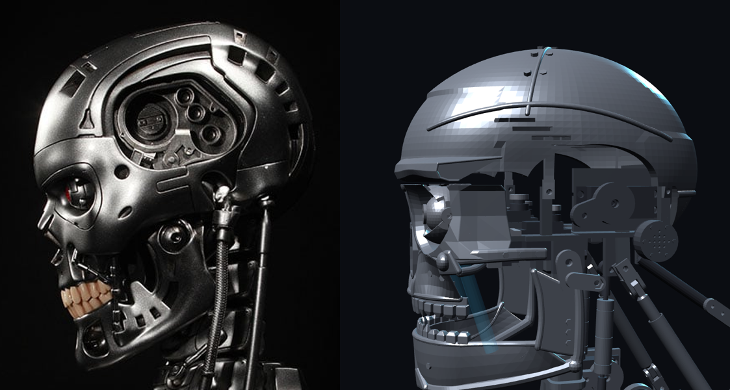
research/cad_estetik/ref/kars_yan_2.png
