Rynnat/endoskull/research/kuponlar/out/render/K1_3q.png

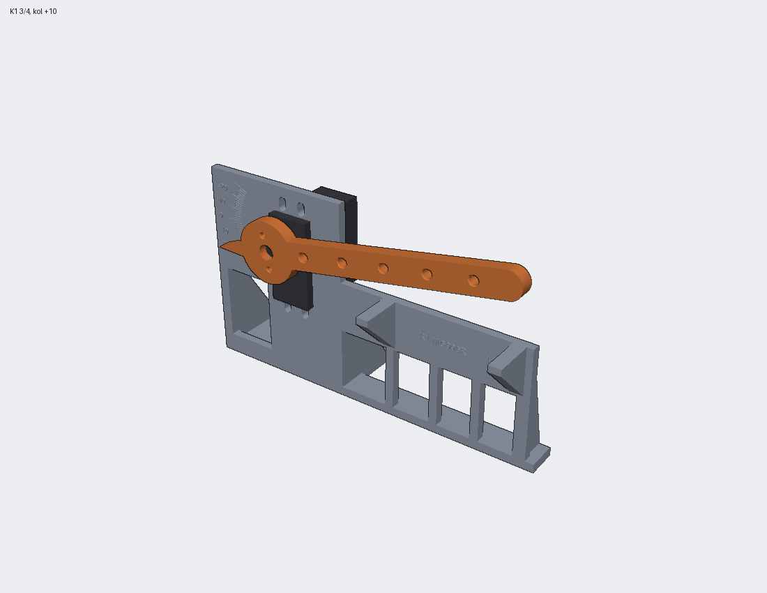
research/kuponlar/out/render/K1_3q.png
