Rynnat/endoskull/research/kuponlar/out/render/K1_arka.png

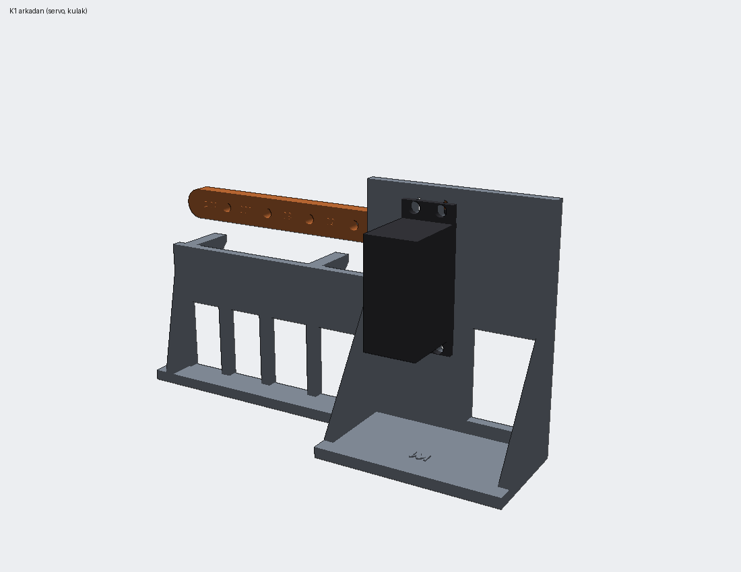
research/kuponlar/out/render/K1_arka.png
