Rynnat/endoskull/research/kuponlar/out/render/K2_mg_K1de.png

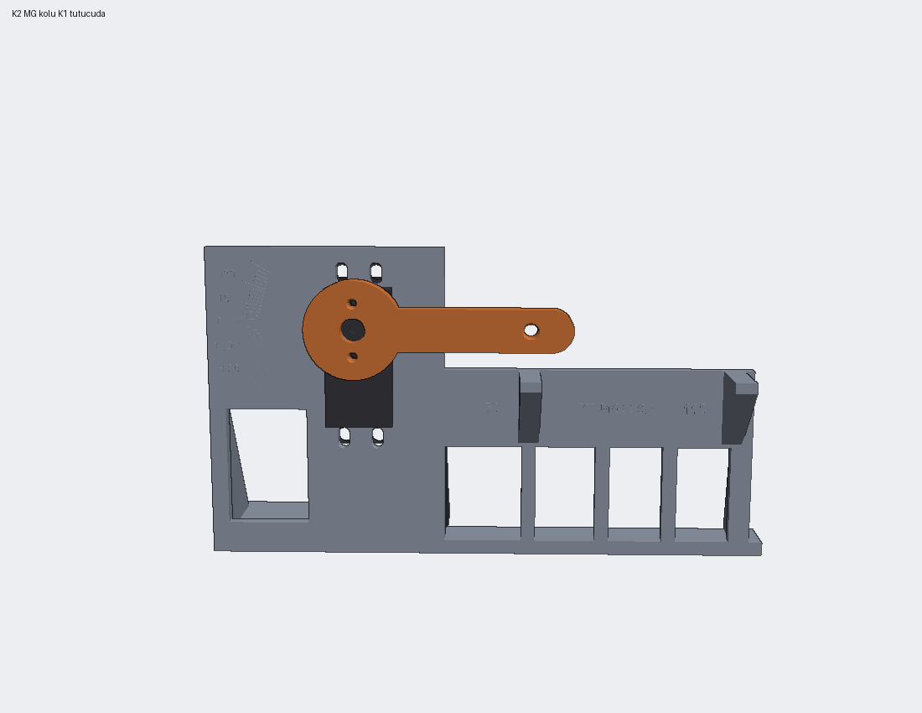
research/kuponlar/out/render/K2_mg_K1de.png
