Rynnat/endoskull/research/kuponlar/out/render/K2_pim.png

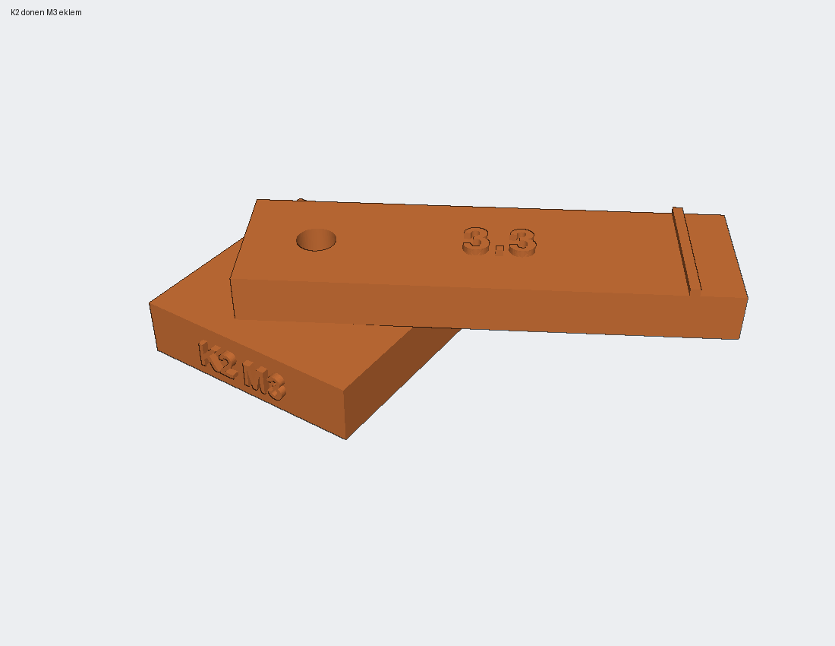
research/kuponlar/out/render/K2_pim.png
