Rynnat/endoskull/research/kuponlar/out/render/K3_3q.png

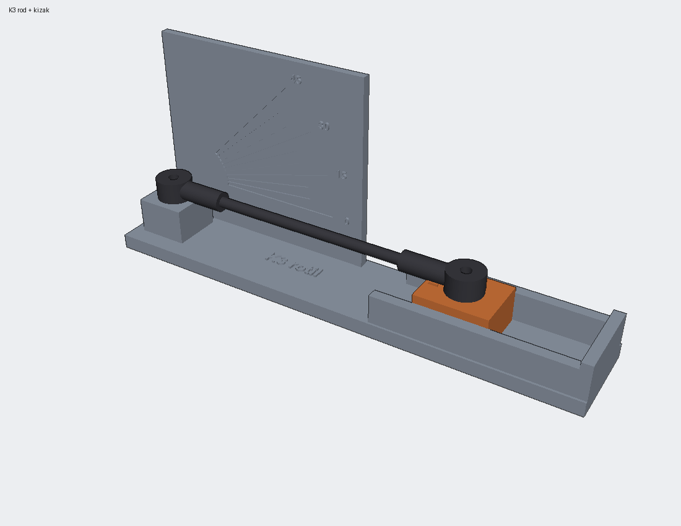
research/kuponlar/out/render/K3_3q.png
