Rynnat/endoskull/research/kuponlar/out/render/K3_egim45.png

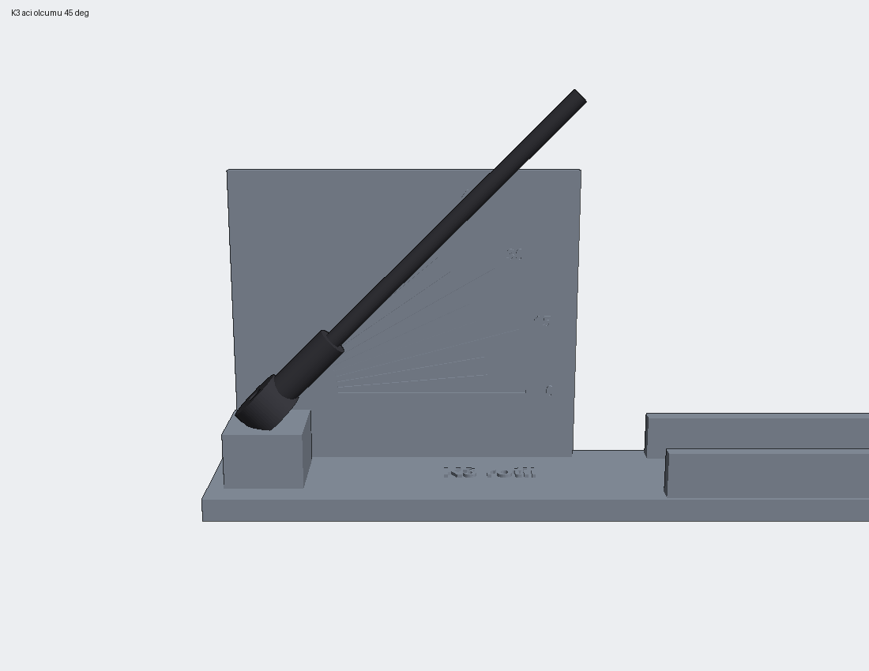
research/kuponlar/out/render/K3_egim45.png
