Rynnat/endoskull/research/kuponlar/out/render/K4_3q.png

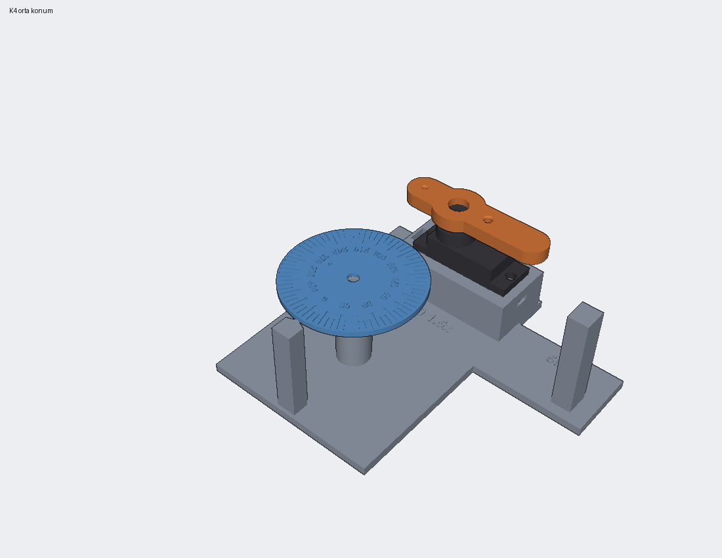
research/kuponlar/out/render/K4_3q.png
