Rynnat/endoskull/research/kuponlar/out/render/K4_K2sg.png

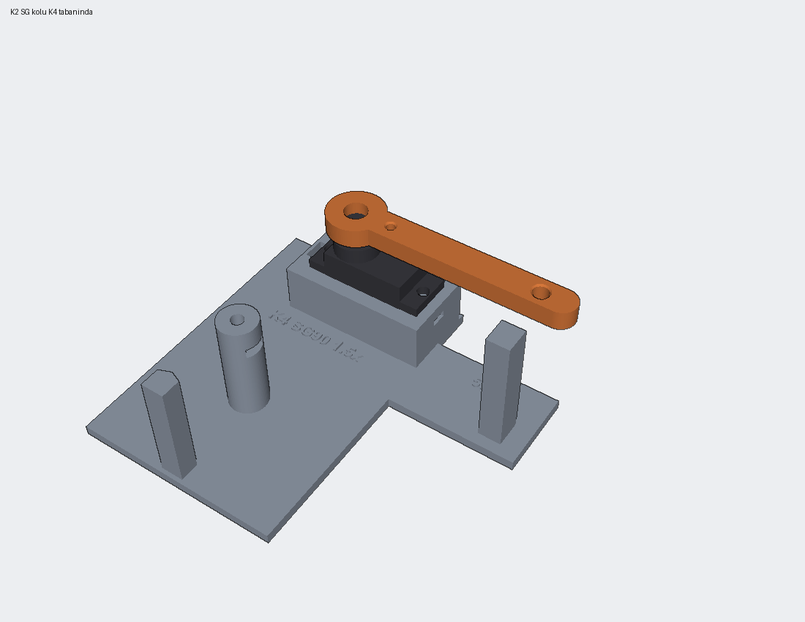
research/kuponlar/out/render/K4_K2sg.png
