Rynnat/endoskull/research/kuponlar/out/render/K4_ust_m25.png

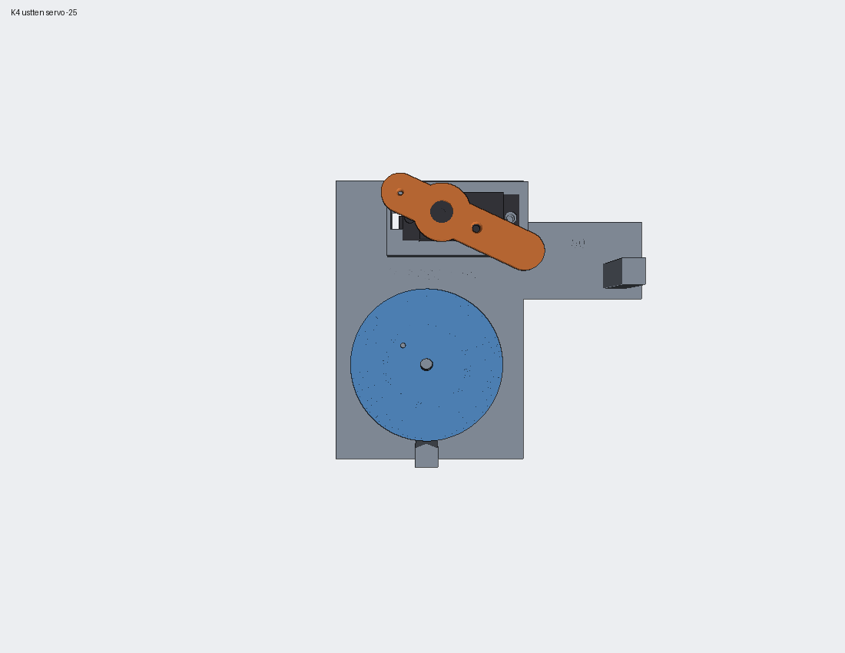
research/kuponlar/out/render/K4_ust_m25.png
