Rynnat/endoskull/research/kuponlar/out/render/K5_cift.png

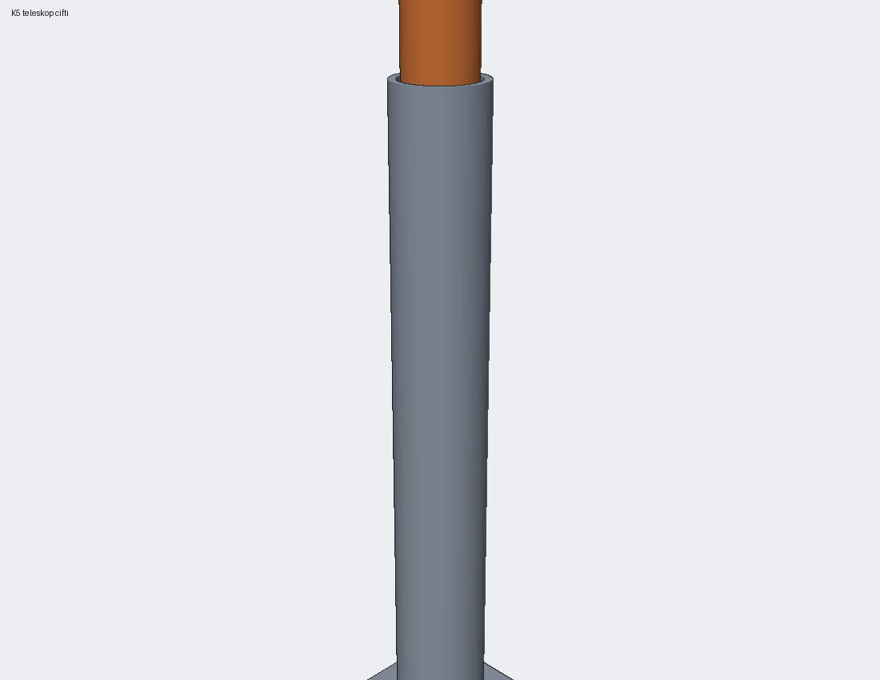
research/kuponlar/out/render/K5_cift.png
