Rynnat/endoskull/research/kuponlar/out/render/K5_kardan.png

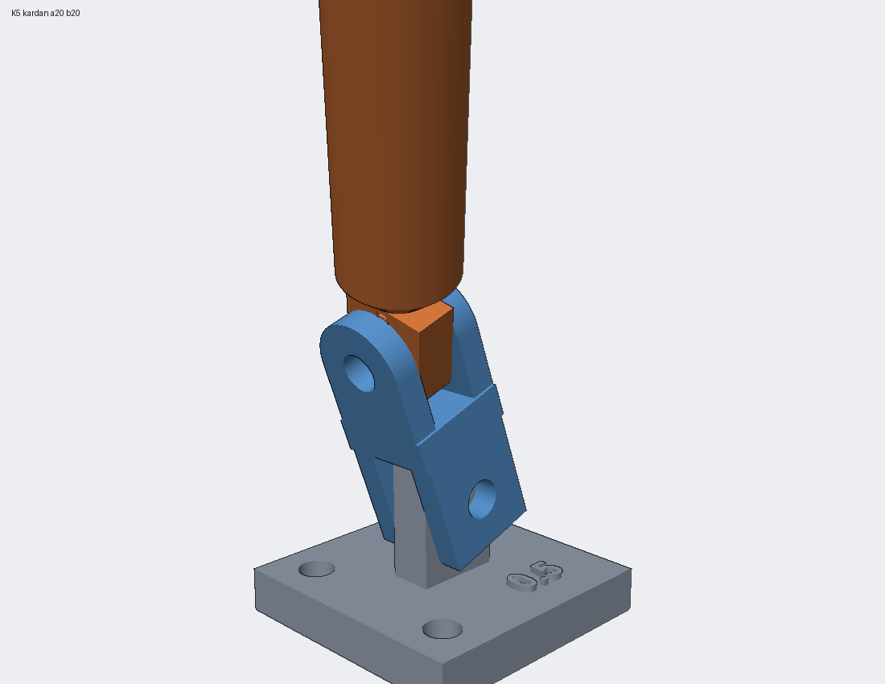
research/kuponlar/out/render/K5_kardan.png
