Rynnat/endoskull/research/kuponlar/out/render/tabla_1.png

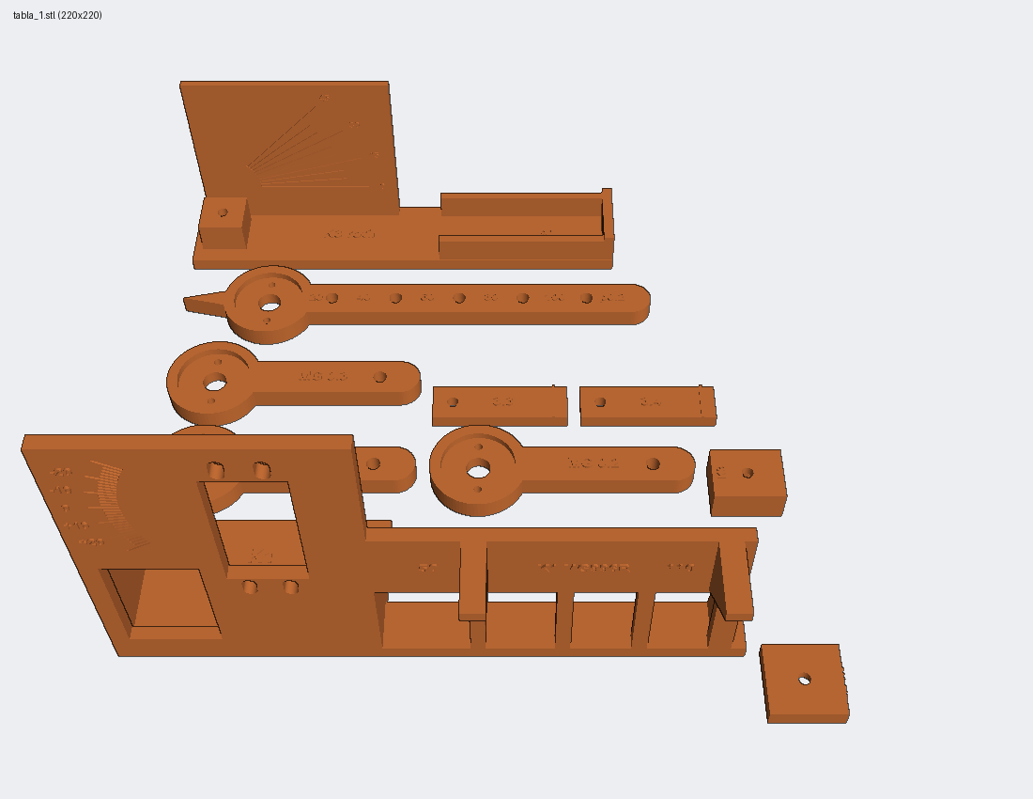
research/kuponlar/out/render/tabla_1.png
