Rynnat/endoskull/research/kuponlar/out/render/tabla_2.png

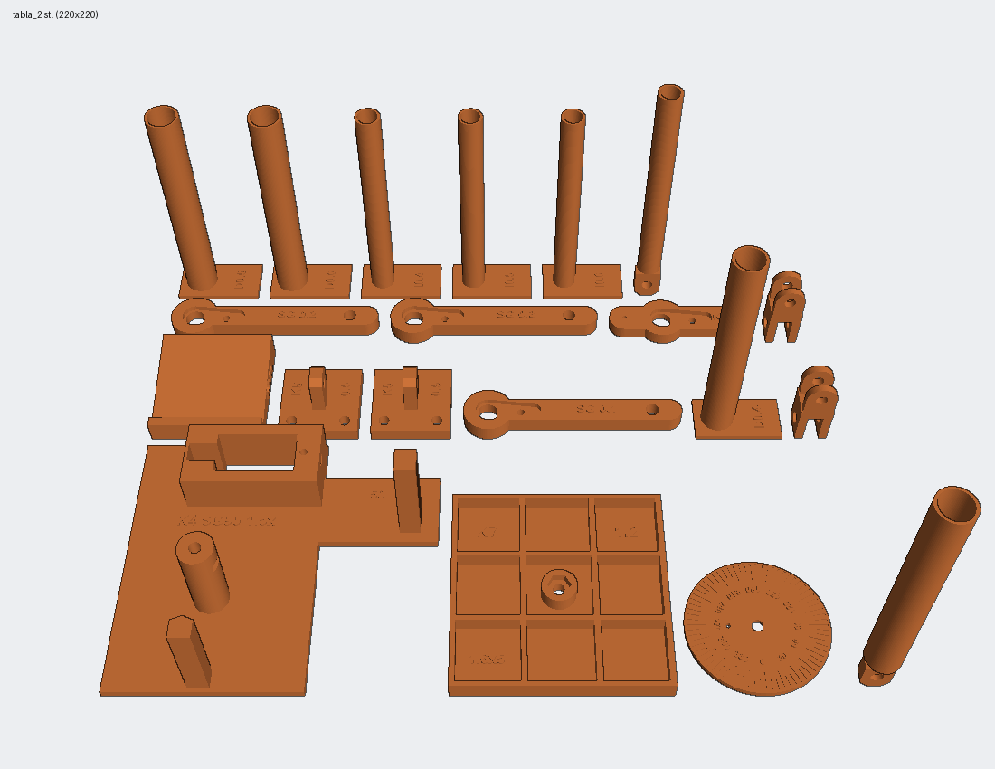
research/kuponlar/out/render/tabla_2.png
