Rynnat/endoskull/research/cad/out/stl/B5d_R.stl

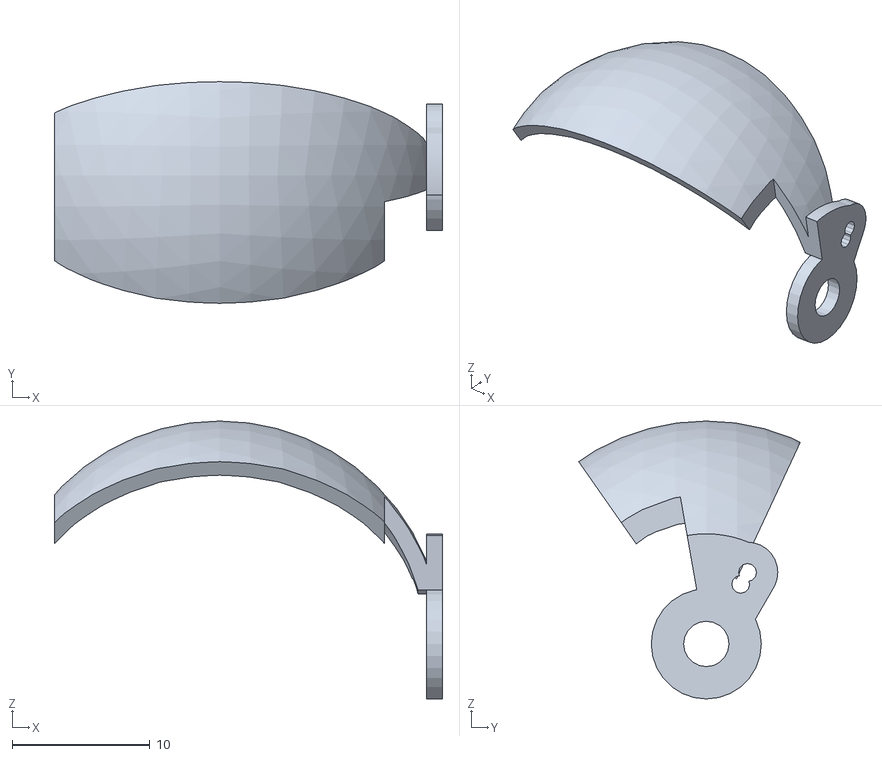
[picture p48: CAD file, 2026-10-19]
research/cad/out/stl/B5d_R.stl
28.2 x 16.1 x 20.2
