Rynnat/endoskull/research/cad/out/stl_varyant/P1_ic_bosluk06.stl

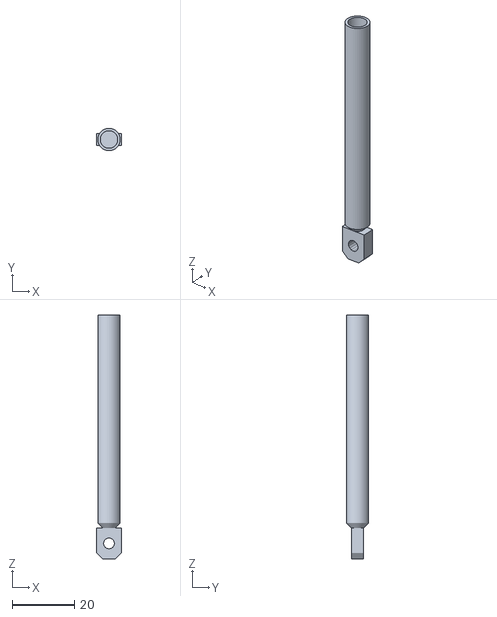
[picture p49: CAD file, 2026-10-19]
research/cad/out/stl_varyant/P1_ic_bosluk06.stl
8.00 x 7.20 x 78.4
