Rynnat/endoskull/research/cad_estetik/out/stl/B5f_pitch.stl

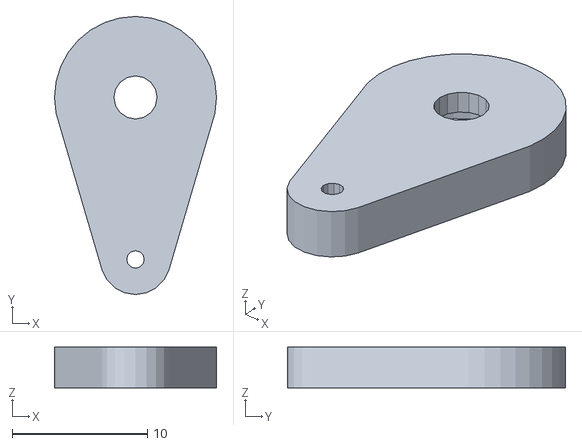
[picture p50: CAD file, 2026-10-19]
research/cad_estetik/out/stl/B5f_pitch.stl
12.0 x 20.6 x 3.00
