Rynnat/endoskull/research/cad_estetik/out/stl_varyant/N4_L_pay03.stl

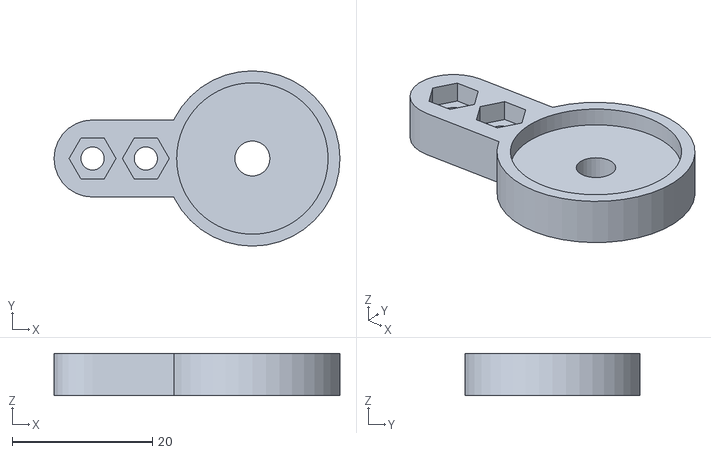
[picture p51: CAD file, 2026-10-19]
research/cad_estetik/out/stl_varyant/N4_L_pay03.stl
40.8 x 25.0 x 6.00
