Rynnat/endoskull/research/kuponlar/out/stl/K5_kardan_orta.stl

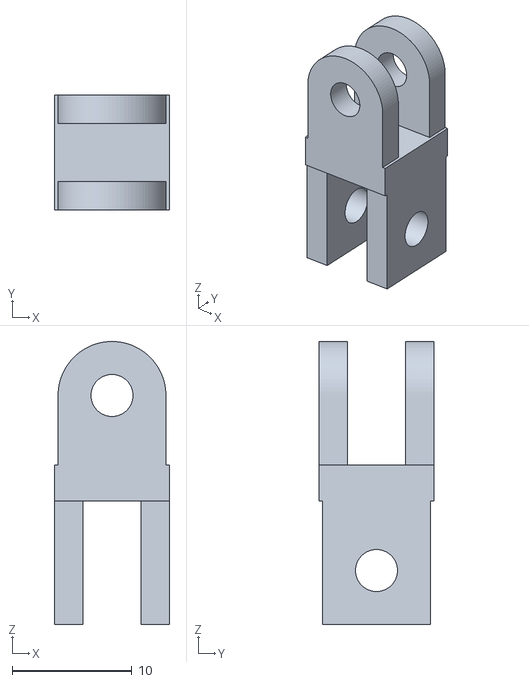
[picture p52: CAD file, 2026-10-19]
research/kuponlar/out/stl/K5_kardan_orta.stl
9.60 x 9.60 x 23.6
