Rynnat/endoskull/research/kuponlar/out/tabla/tabla_1.stl

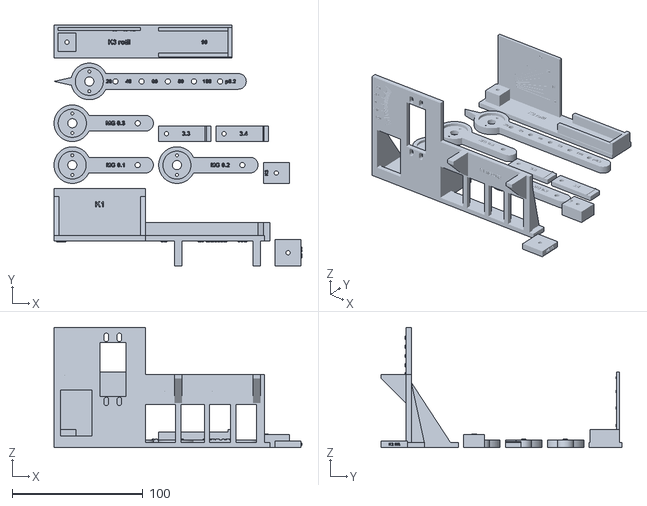
[picture p53: CAD file, 2026-10-19]
research/kuponlar/out/tabla/tabla_1.stl
189.6 x 184.0 x 92.0
