Rynnat/endoskull/research/cad/out/stl/B6L.stl

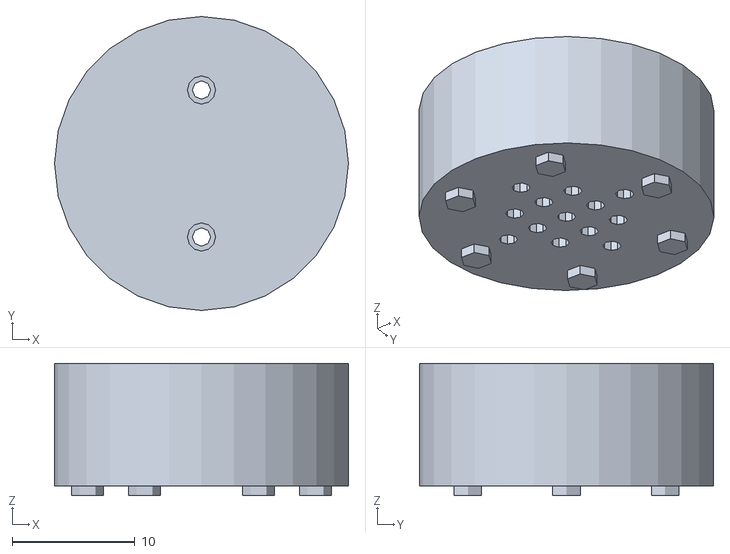
[picture p54: CAD file, 2026-10-19]
research/cad/out/stl/B6L.stl
24.0 x 24.0 x 10.8
