Rynnat/endoskull/research/kuponlar/out/stl/K4_krank.stl

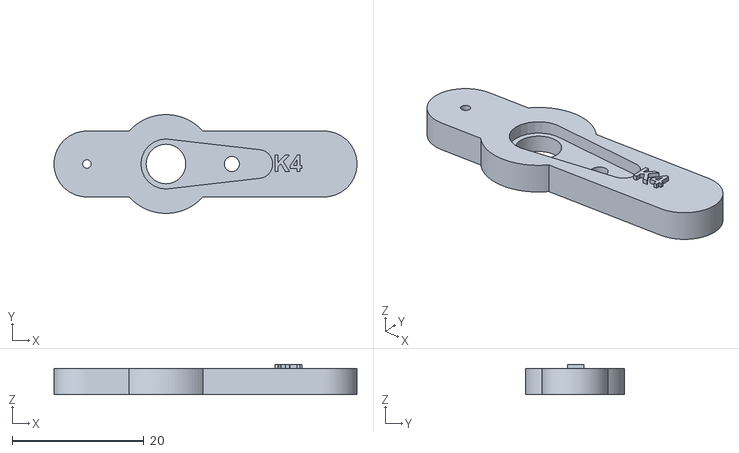
[picture p55: CAD file, 2026-10-19]
research/kuponlar/out/stl/K4_krank.stl
46.0 x 15.0 x 4.60
