Rynnat/endoskull/research/kuponlar/out/tabla/tabla_2.stl

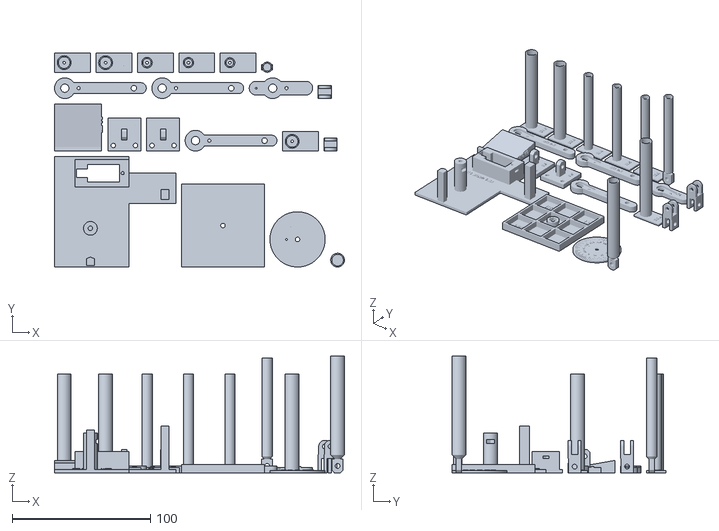
[picture p56: CAD file, 2026-10-19]
research/kuponlar/out/tabla/tabla_2.stl
210.0 x 155.0 x 84.5
