Rynnat/endoskull/research/cad/out/stl/B5h.stl

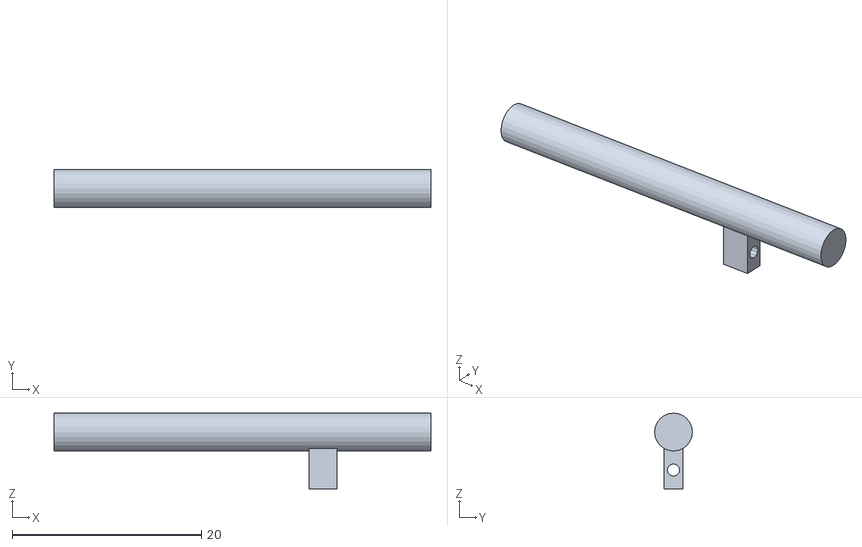
[picture p57: CAD file, 2026-10-19]
research/cad/out/stl/B5h.stl
39.8 x 4.00 x 8.00
