Rynnat/endoskull/research/cad/out/stl_varyant/P1_ic_bosluk04.stl

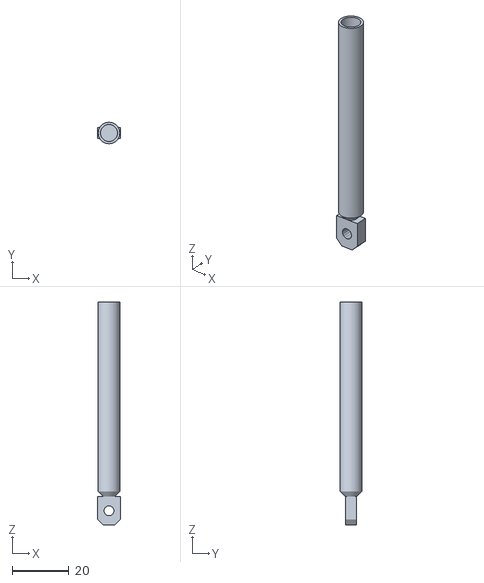
[picture p58: CAD file, 2026-10-19]
research/cad/out/stl_varyant/P1_ic_bosluk04.stl
8.00 x 7.60 x 78.6
