Rynnat/endoskull/research/cad_estetik/out/stl/B5e_L.stl

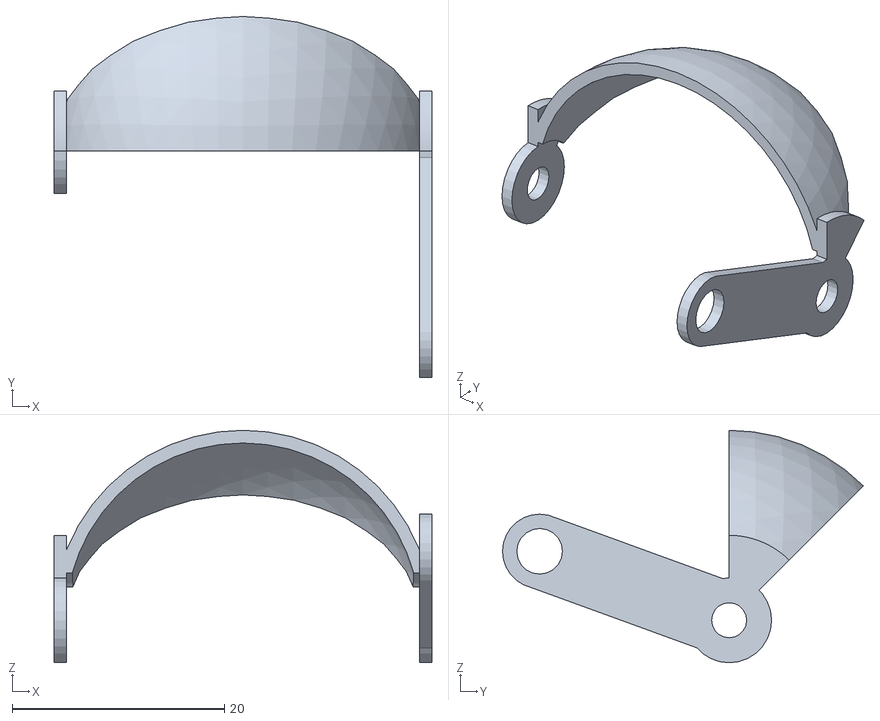
[picture p59: CAD file, 2026-10-19]
research/cad_estetik/out/stl/B5e_L.stl
35.6 x 34.0 x 21.9
