Rynnat/endoskull/research/kuponlar/out/stl/K2_mg_p0.3.stl

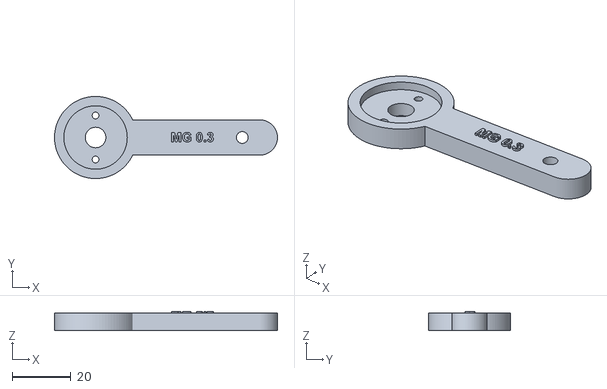
[picture p60: CAD file, 2026-10-19]
research/kuponlar/out/stl/K2_mg_p0.3.stl
76.0 x 28.0 x 6.60
