Rynnat/endoskull/research/kuponlar/out/stl/K4_taban.stl

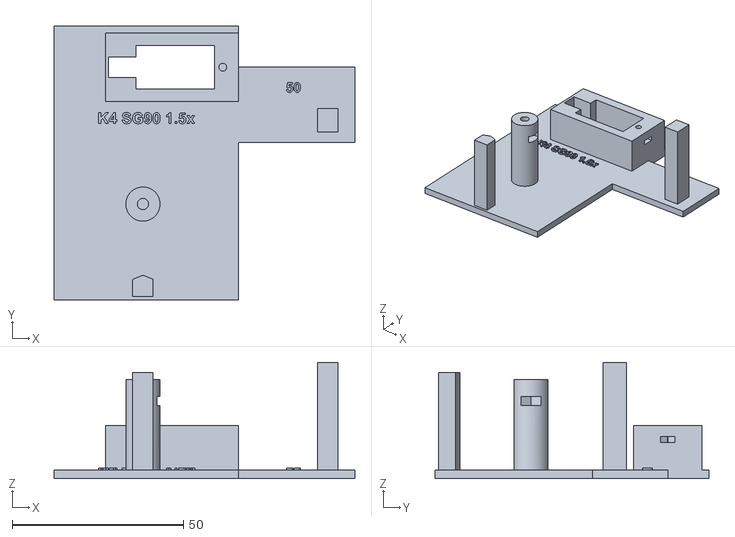
[picture p61: CAD file, 2026-10-19]
research/kuponlar/out/stl/K4_taban.stl
88.0 x 80.0 x 34.0
