Rynnat/endoskull/research/cad/out/stl/G2L.stl

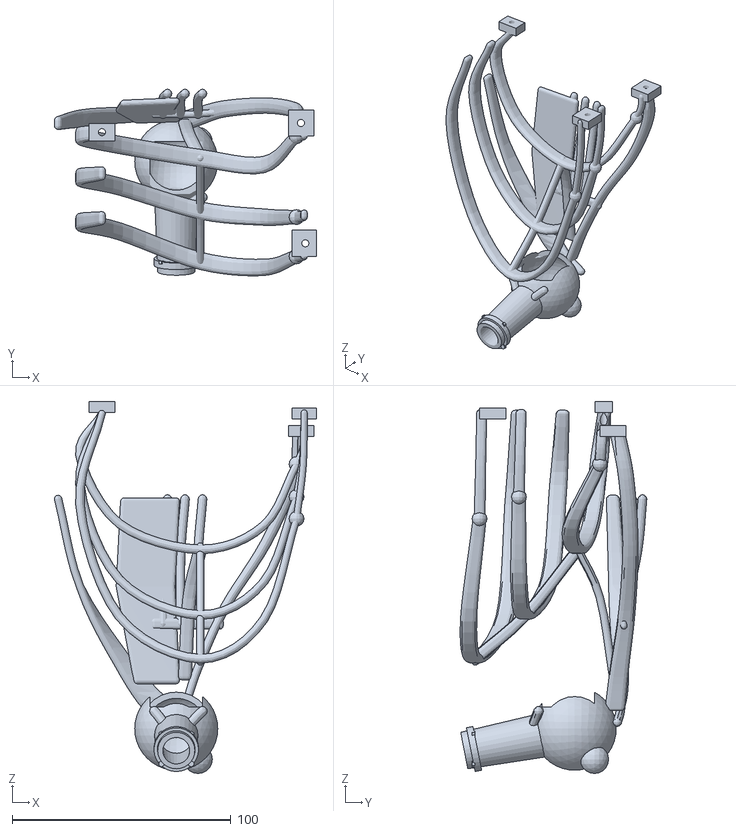
[picture p62: CAD file, 2026-10-19]
research/cad/out/stl/G2L.stl
119.9 x 85.4 x 170.1
