Rynnat/endoskull/research/cad_estetik/out/stl/B4.stl

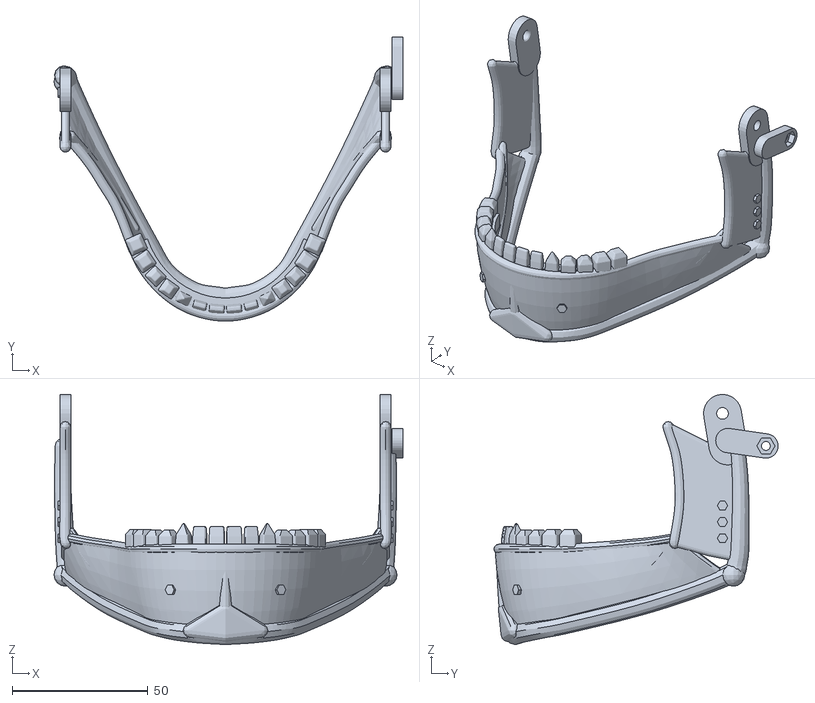
[picture p63: CAD file, 2026-10-19]
research/cad_estetik/out/stl/B4.stl
128.6 x 104.7 x 92.2
