Rynnat/endoskull/research/kuponlar/out/stl/K4_disk.stl

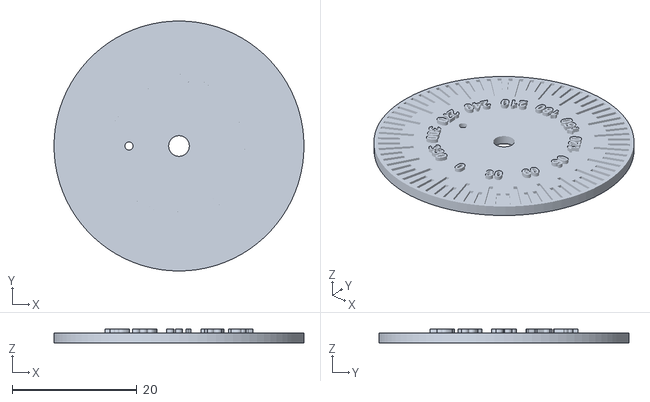
[picture p64: CAD file, 2026-10-19]
research/kuponlar/out/stl/K4_disk.stl
40.0 x 40.0 x 2.20
