Rynnat/endoskull/research/cad/out/stl/B1.stl

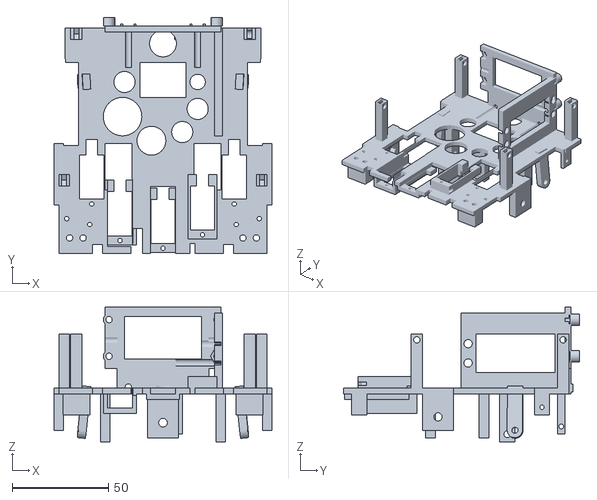
[picture p65: CAD file, 2026-10-19]
research/cad/out/stl/B1.stl
113.2 x 122.4 x 70.0
