Rynnat/endoskull/research/cad_estetik/out/stl/B5c_L.stl

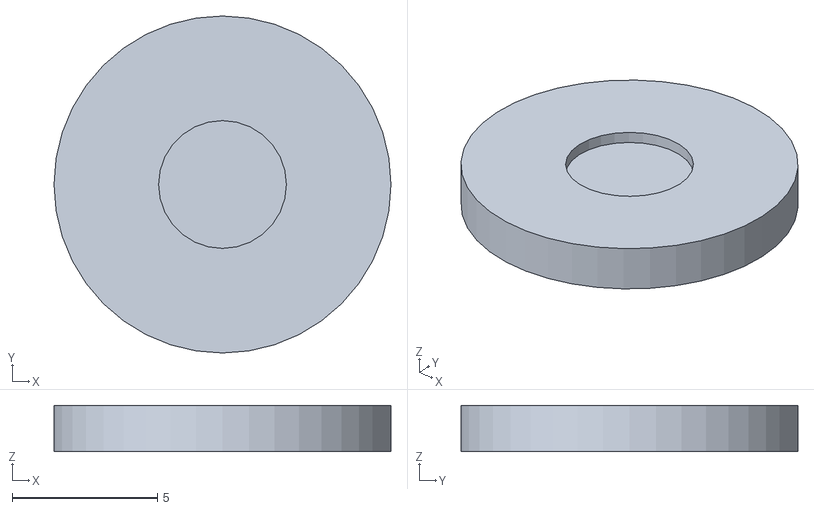
[picture p66: CAD file, 2026-10-19]
research/cad_estetik/out/stl/B5c_L.stl
11.6 x 11.6 x 1.60
