Rynnat/endoskull/research/kuponlar/out/stl/K3_kizak.stl

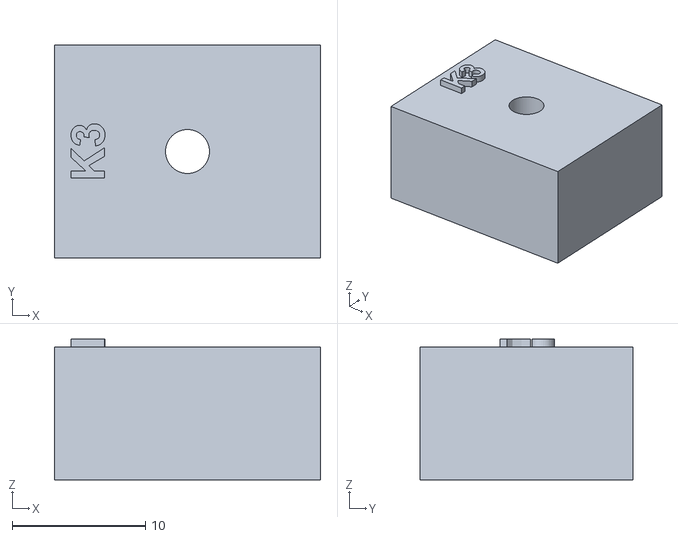
[picture p67: CAD file, 2026-10-19]
research/kuponlar/out/stl/K3_kizak.stl
20.0 x 16.0 x 10.6
