Rynnat/endoskull/research/cad/out/stl/N5.stl

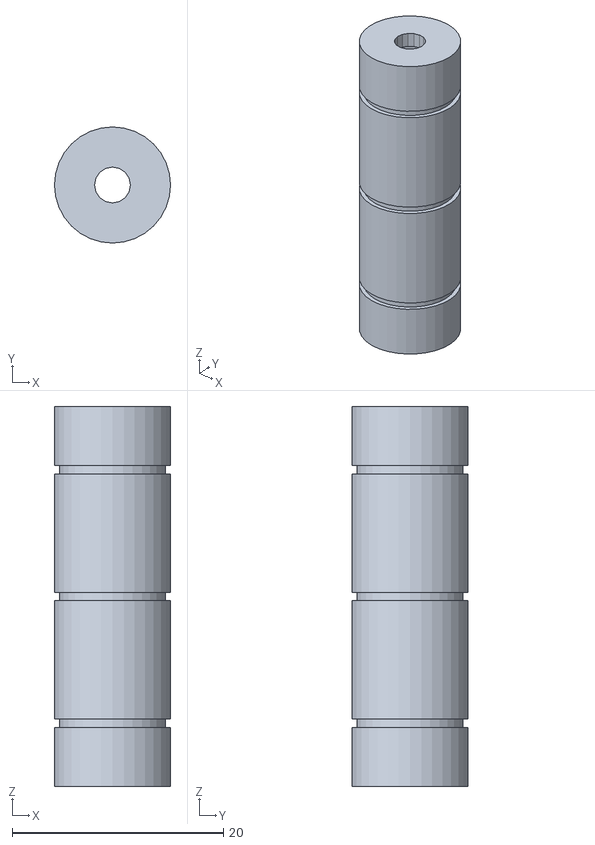
[picture p68: CAD file, 2026-10-19]
research/cad/out/stl/N5.stl
11.0 x 11.0 x 36.0
