Rynnat/endoskull/research/cad_estetik/out/stl/P1_ic.stl

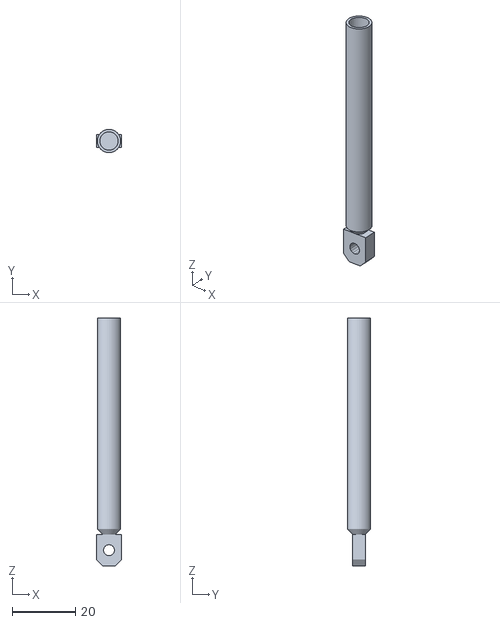
[picture p69: CAD file, 2026-10-19]
research/cad_estetik/out/stl/P1_ic.stl
8.00 x 7.40 x 78.5
