Rynnat/endoskull/research/cad/out/stl/B3L.stl

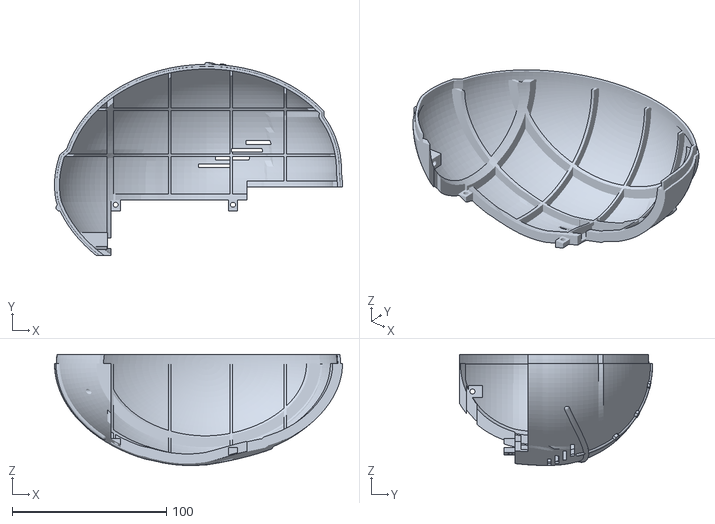
[picture p70: CAD file, 2026-10-19]
research/cad/out/stl/B3L.stl
186.6 x 125.3 x 71.9
