Rynnat/endoskull/research/kuponlar/out/stl/K5_ic_0.6.stl

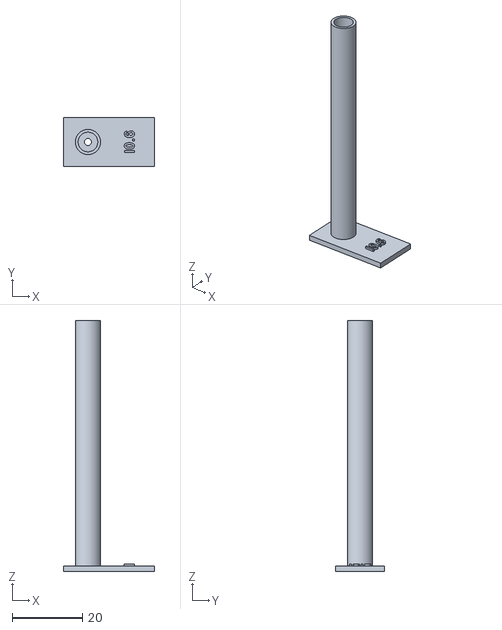
[picture p71: CAD file, 2026-10-19]
research/kuponlar/out/stl/K5_ic_0.6.stl
26.0 x 14.0 x 71.6
