Rynnat/endoskull/research/cad/out/stl/N1.stl

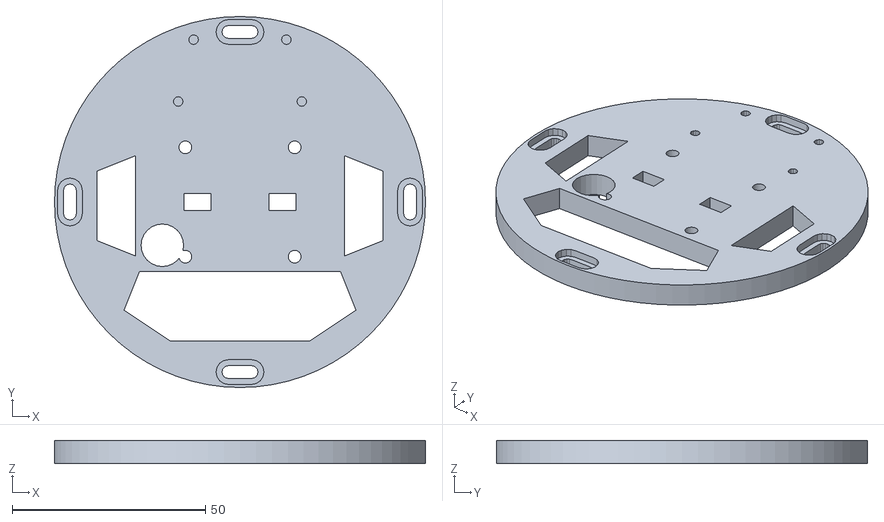
[picture p72: CAD file, 2026-10-19]
research/cad/out/stl/N1.stl
96.0 x 96.0 x 6.00
