Rynnat/endoskull/research/cad_estetik/out/stl/B3L.stl

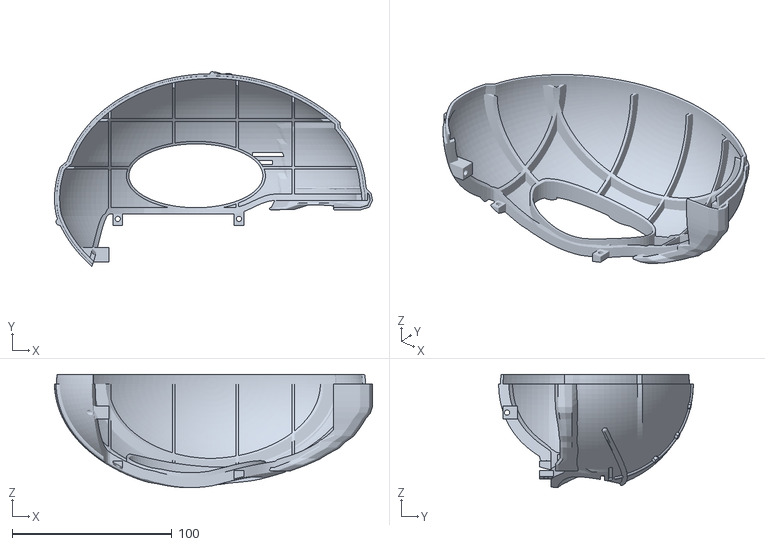
[picture p73: CAD file, 2026-10-19]
research/cad_estetik/out/stl/B3L.stl
199.4 x 122.1 x 71.1
