Rynnat/endoskull/research/kuponlar/out/stl/K2_sg_p0.3.stl

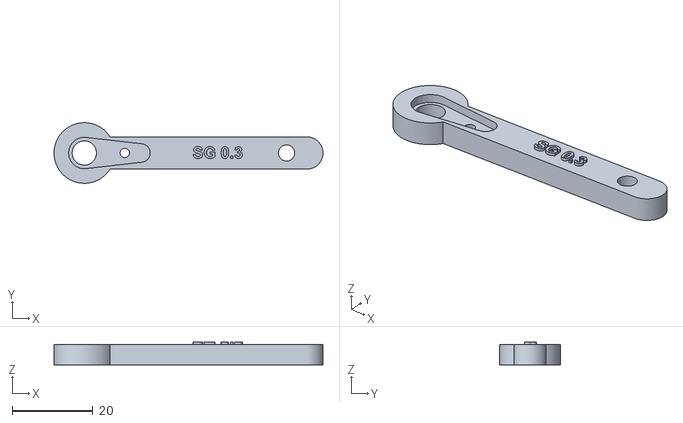
[picture p74: CAD file, 2026-10-19]
research/kuponlar/out/stl/K2_sg_p0.3.stl
66.5 x 15.0 x 5.60
