Rynnat/endoskull/research/cad/out/stl/B5b_R.stl

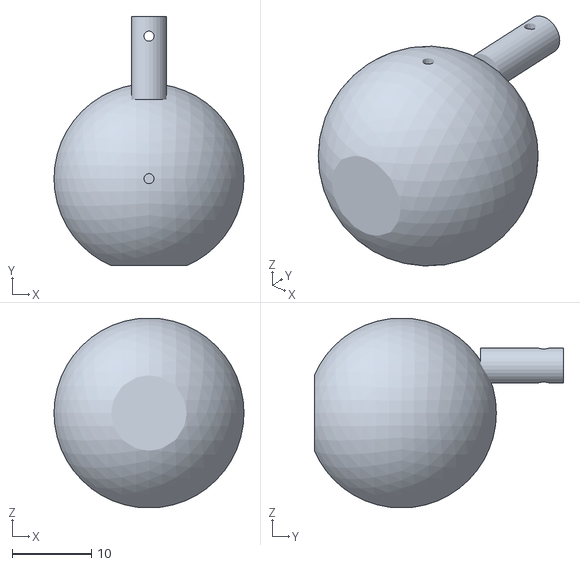
[picture p75: CAD file, 2026-10-19]
research/cad/out/stl/B5b_R.stl
24.0 x 31.5 x 23.9
