Rynnat/endoskull/research/cad_estetik/out/stl/B5g_R.stl

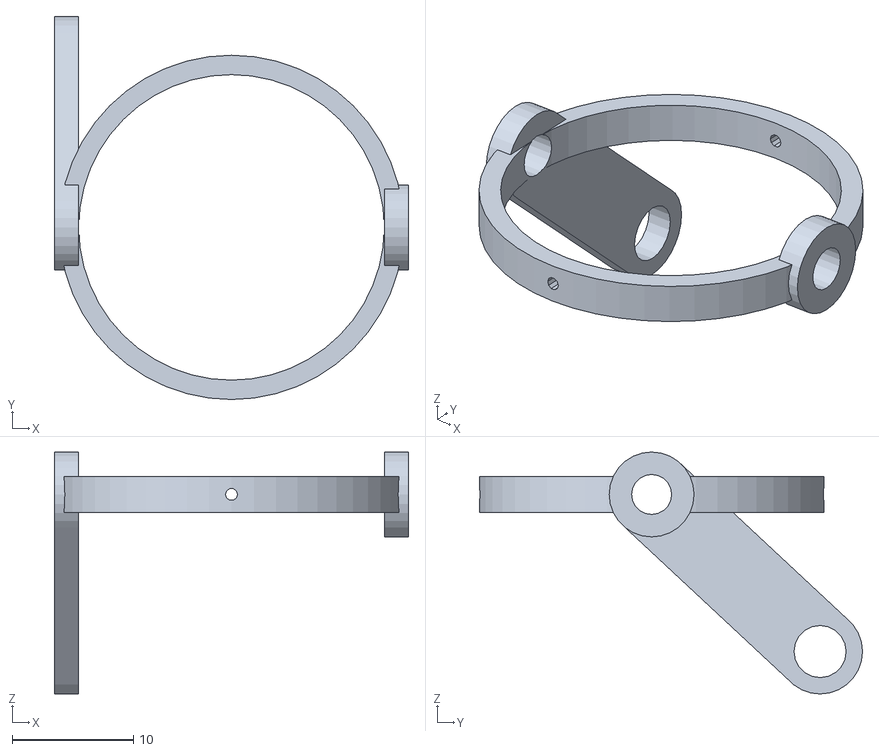
[picture p76: CAD file, 2026-10-19]
research/cad_estetik/out/stl/B5g_R.stl
29.2 x 31.6 x 20.0
