Rynnat/endoskull/research/kuponlar/out/stl/K5_kardan_ankraj.stl

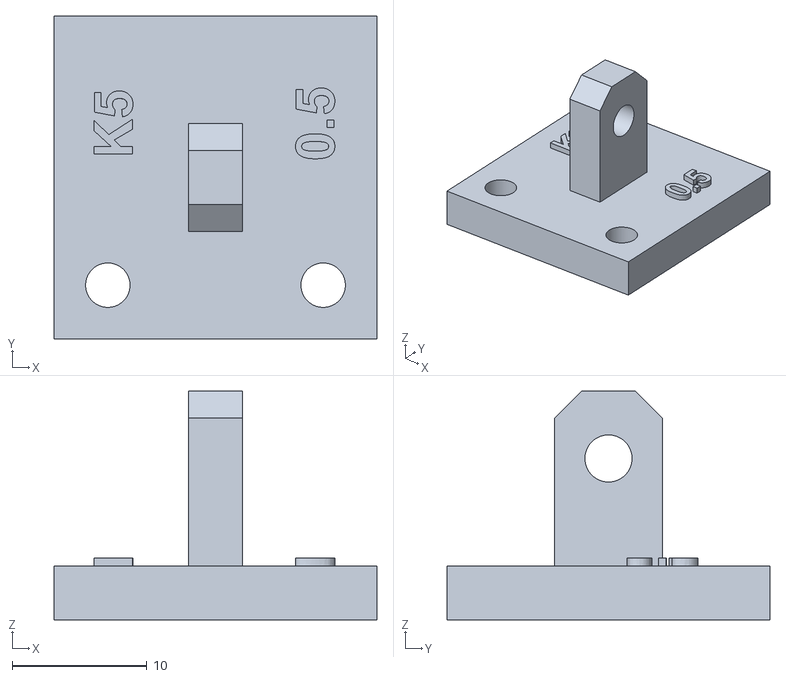
[picture p77: CAD file, 2026-10-19]
research/kuponlar/out/stl/K5_kardan_ankraj.stl
24.0 x 24.0 x 17.0
