Rynnat/endoskull/research/cad/out/stl/Y1.stl

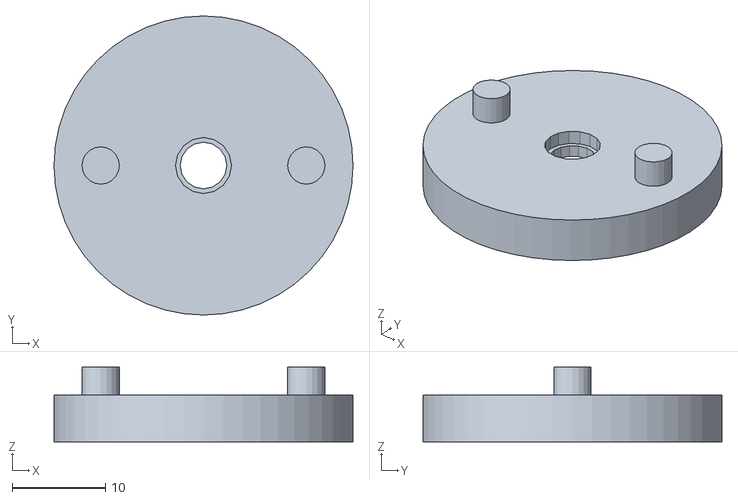
[picture p78: CAD file, 2026-10-19]
research/cad/out/stl/Y1.stl
32.0 x 32.0 x 8.00
