Rynnat/endoskull/research/kuponlar/out/stl/K3_taban.stl

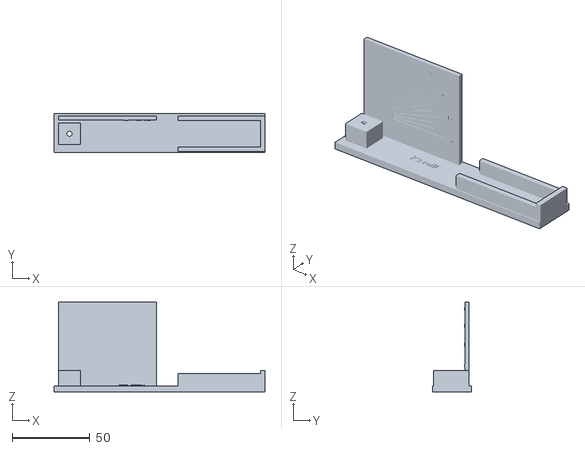
[picture p80: CAD file, 2026-10-19]
research/kuponlar/out/stl/K3_taban.stl
136.0 x 25.0 x 58.0
