Rynnat/endoskull/research/cad/out/stl/N4_L.stl

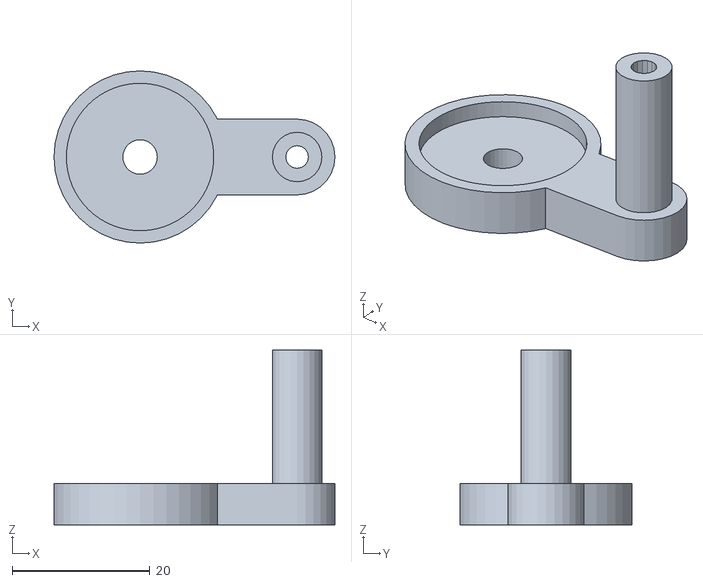
[picture p81: CAD file, 2026-10-19]
research/cad/out/stl/N4_L.stl
40.8 x 25.0 x 25.4
