Rynnat/endoskull/research/cad_estetik/out/stl/N2.stl

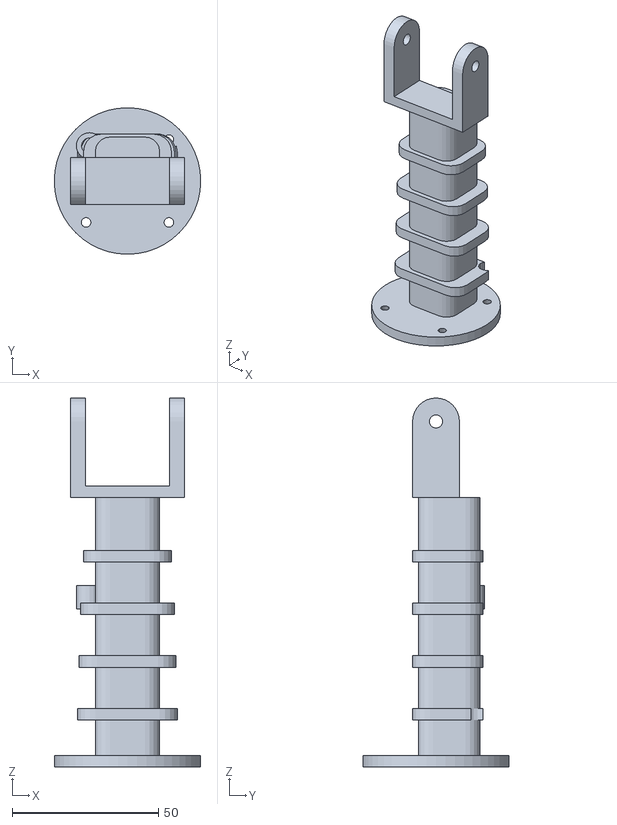
[picture p82: CAD file, 2026-10-19]
research/cad_estetik/out/stl/N2.stl
50.0 x 50.0 x 126.0
