Rynnat/endoskull/research/cad_estetik/out/stl/G1.stl

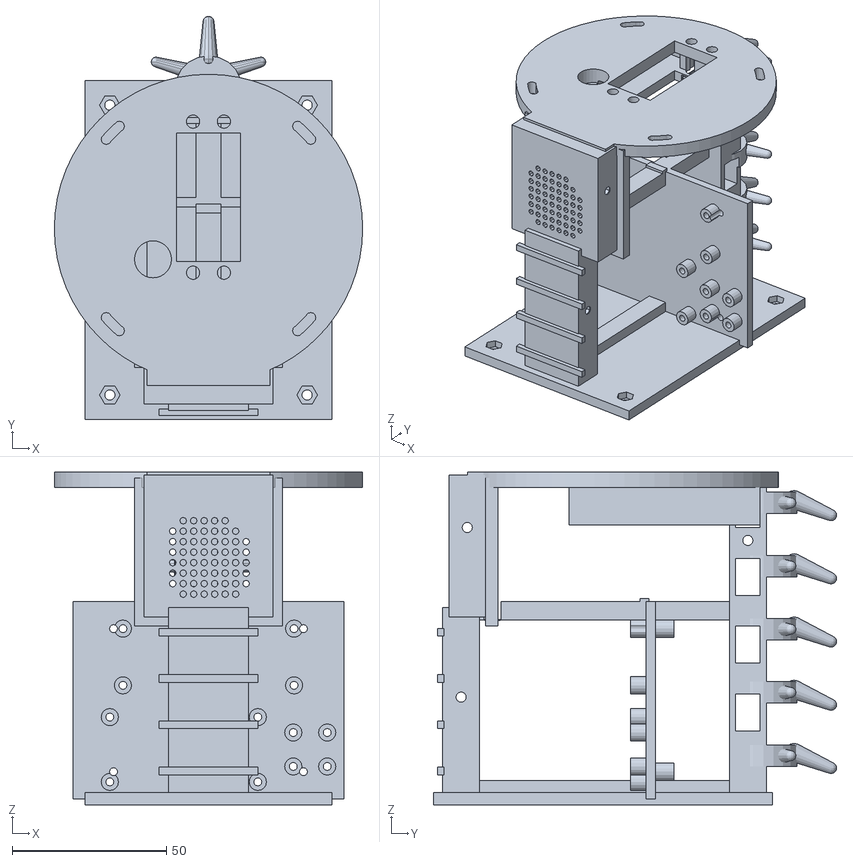
[picture p83: CAD file, 2026-10-19]
research/cad_estetik/out/stl/G1.stl
100.0 x 130.8 x 108.0
