Rynnat/endoskull/research/kuponlar/out/stl/K1_kol.stl

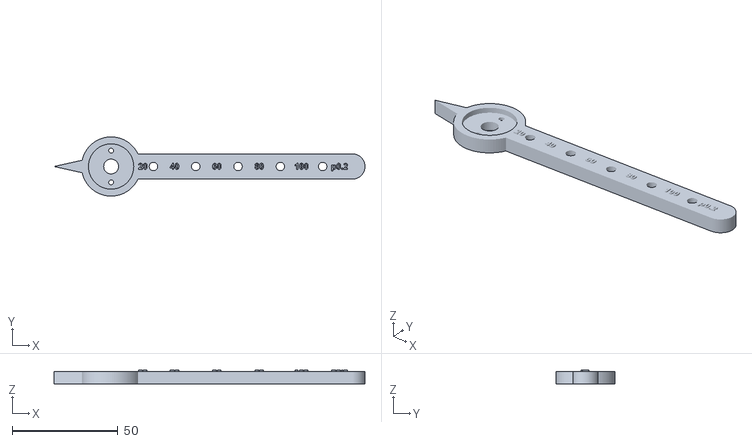
[picture p84: CAD file, 2026-10-19]
research/kuponlar/out/stl/K1_kol.stl
147.0 x 28.0 x 6.60
