Rynnat/endoskull/research/cad_estetik/out/stl/N1.stl

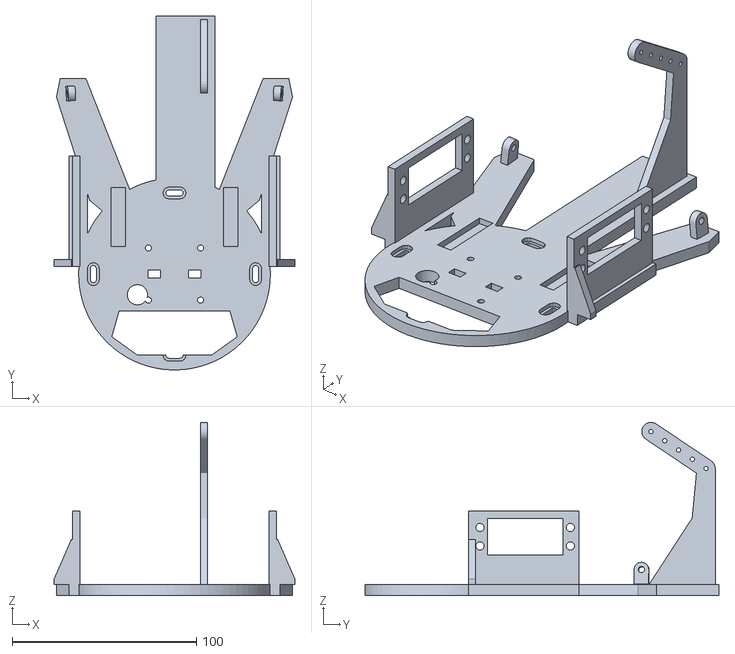
[picture p85: CAD file, 2026-10-19]
research/cad_estetik/out/stl/N1.stl
130.6 x 191.9 x 94.0
