Rynnat/endoskull/research/kuponlar/out/stl/K5_kardan_dis.stl

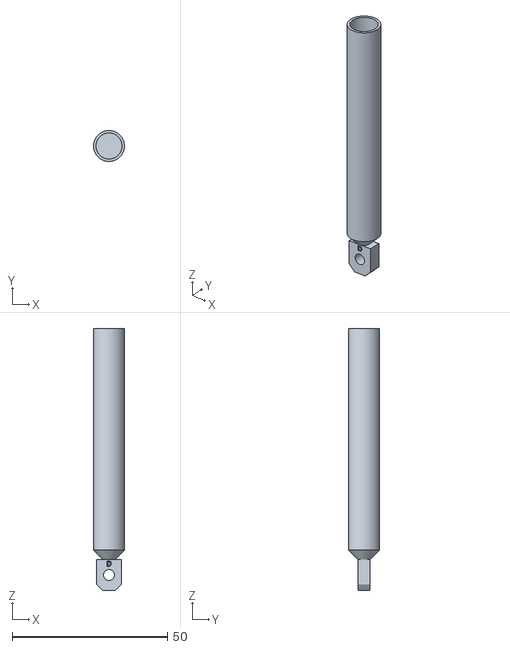
[picture p86: CAD file, 2026-10-19]
research/kuponlar/out/stl/K5_kardan_dis.stl
10.0 x 10.0 x 84.5
