Rynnat/endoskull/research/cad/out/stl/B3R.stl

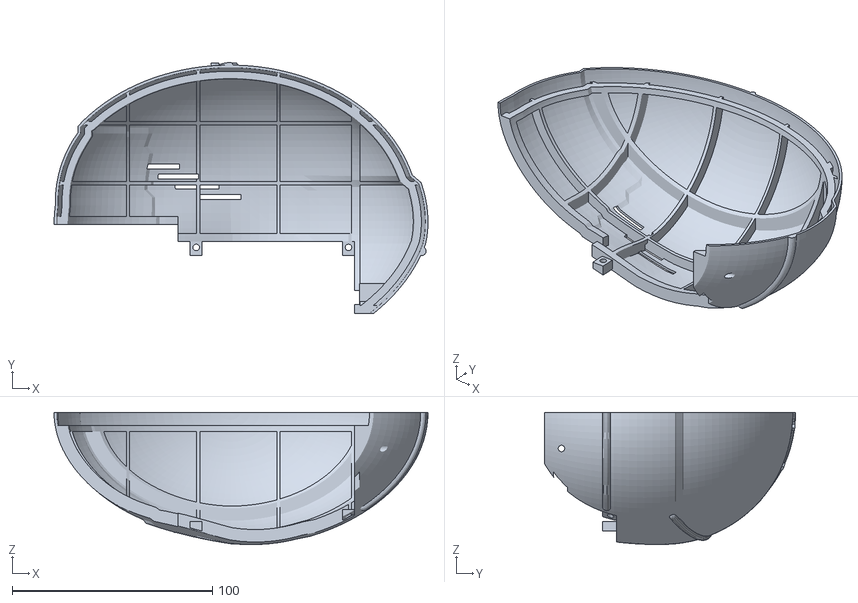
[picture p87: CAD file, 2026-10-19]
research/cad/out/stl/B3R.stl
186.6 x 125.3 x 65.9
