Rynnat/endoskull/research/cad_estetik/out/stl/B5i.stl

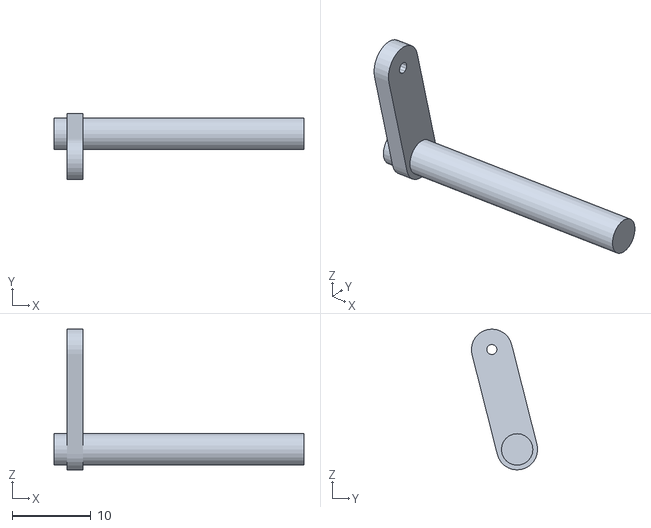
[picture p88: CAD file, 2026-10-19]
research/cad_estetik/out/stl/B5i.stl
31.8 x 8.41 x 17.9
