Rynnat/endoskull/research/cad/out/stl/B5f_ustL.stl

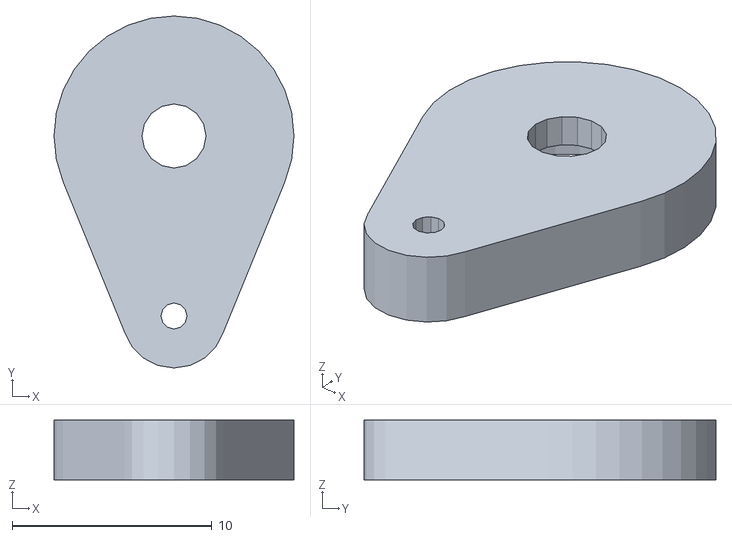
[picture p89: CAD file, 2026-10-19]
research/cad/out/stl/B5f_ustL.stl
12.0 x 17.6 x 3.00
