Rynnat/endoskull/research/kuponlar/out/stl/K1_tutucu.stl

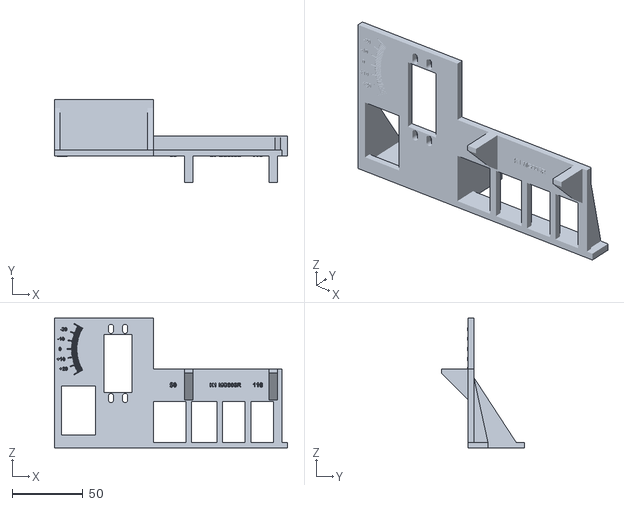
[picture p90: CAD file, 2026-10-19]
research/kuponlar/out/stl/K1_tutucu.stl
165.0 x 59.0 x 92.0
