Rynnat/endoskull/research/cad_estetik/out/stl/N3.stl

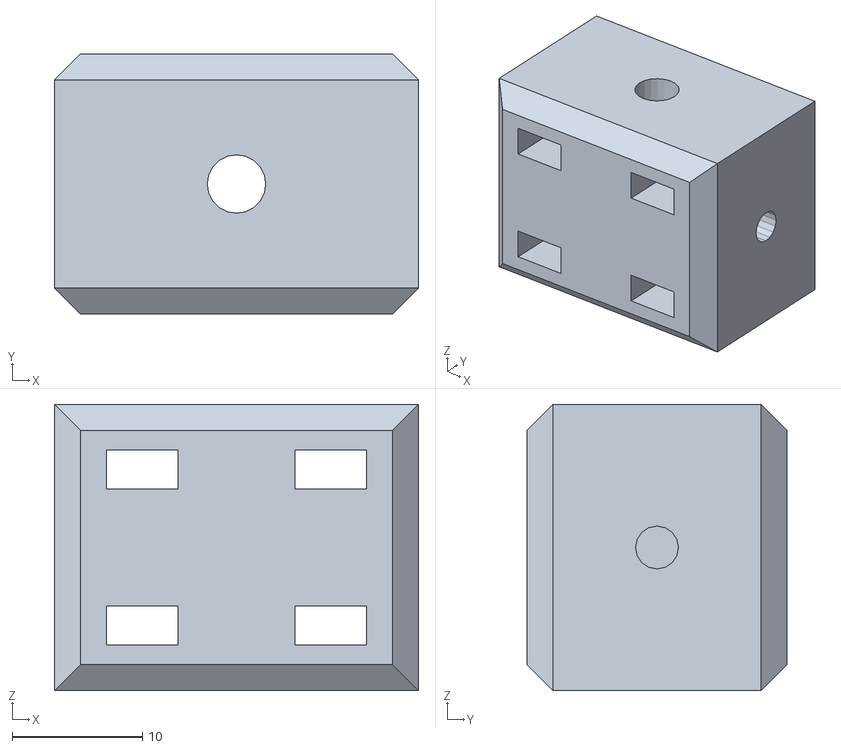
[picture p91: CAD file, 2026-10-19]
research/cad_estetik/out/stl/N3.stl
28.0 x 20.0 x 22.0
