Rynnat/endoskull/research/kuponlar/out/stl/K5_dis_0.4.stl

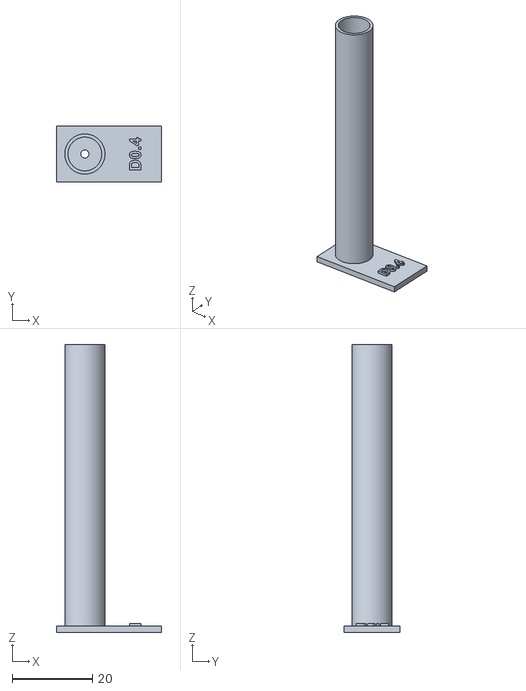
[picture p92: CAD file, 2026-10-19]
research/kuponlar/out/stl/K5_dis_0.4.stl
26.0 x 14.0 x 71.6
