Rynnat/endoskull/research/kuponlar/out/stl/K2_pim_sabit.stl

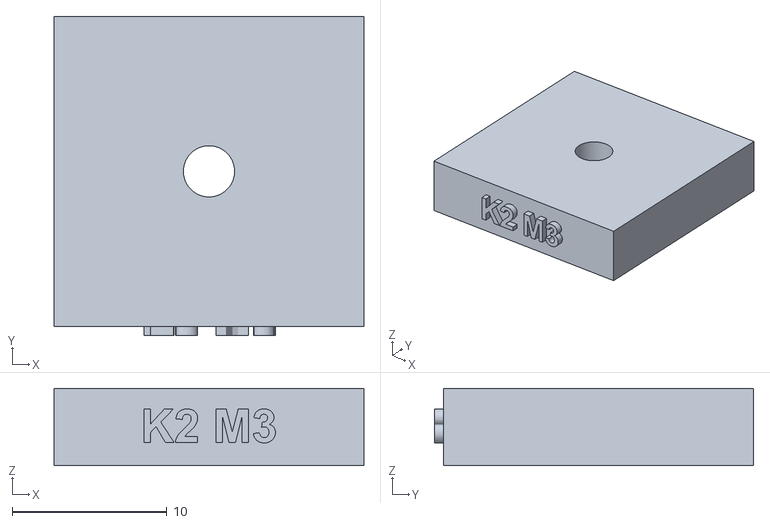
[picture p93: CAD file, 2026-10-19]
research/kuponlar/out/stl/K2_pim_sabit.stl
20.0 x 20.6 x 5.00
