Rynnat/endoskull/research/cad/out/stl/B2.stl

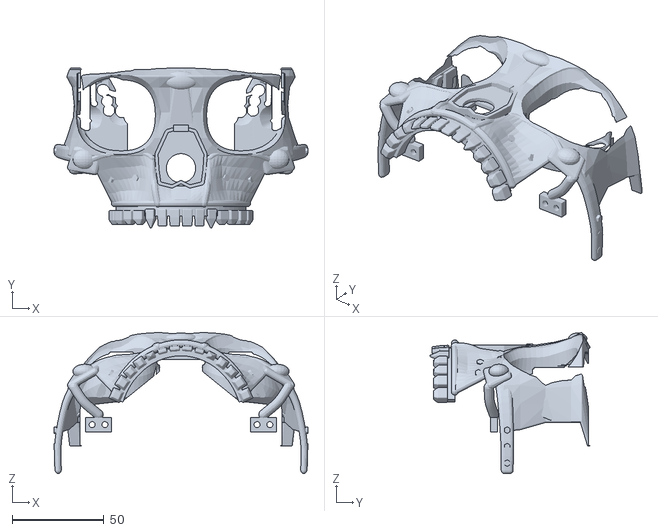
[picture p94: CAD file, 2026-10-19]
research/cad/out/stl/B2.stl
138.6 x 87.5 x 77.0
