Rynnat/endoskull/research/cad_estetik/out/stl/B3R.stl

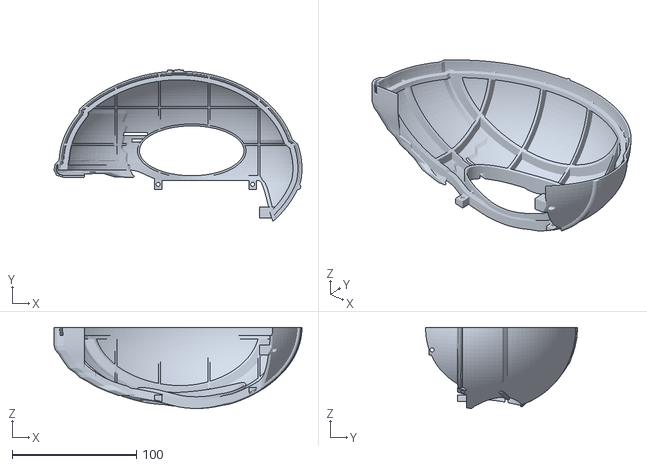
[picture p95: CAD file, 2026-10-19]
research/cad_estetik/out/stl/B3R.stl
199.4 x 122.1 x 65.1
