Rynnat/endoskull/research/cad/out/stl/G4R.stl

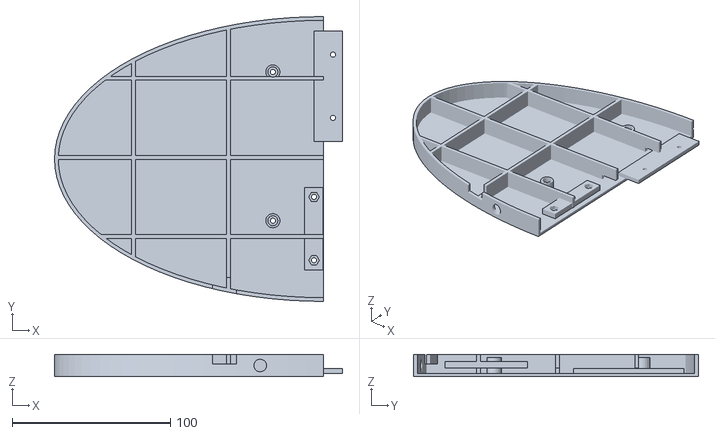
[picture p96: CAD file, 2026-10-19]
research/cad/out/stl/G4R.stl
182.0 x 180.0 x 14.0
