Rynnat/endoskull/research/cad_estetik/out/stl/B5a.stl

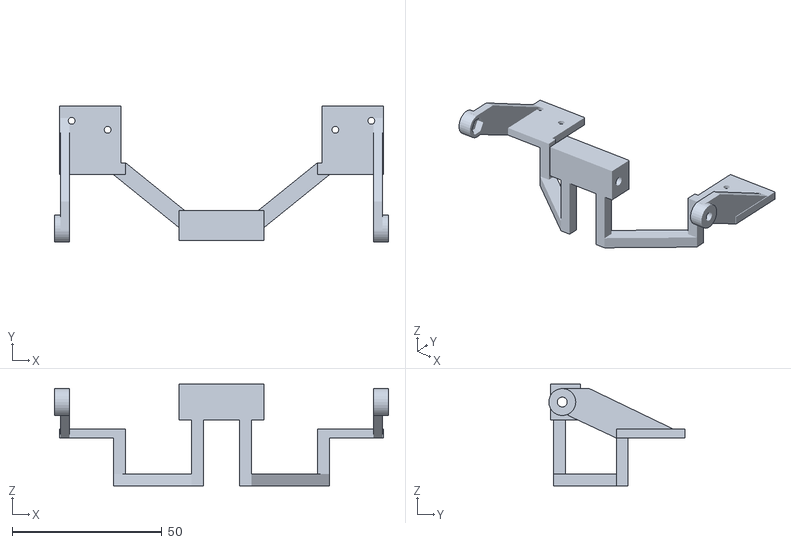
[picture p97: CAD file, 2026-10-19]
research/cad_estetik/out/stl/B5a.stl
111.4 x 45.5 x 34.0
