Rynnat/endoskull/research/kuponlar/out/stl/K5_kardan_ic.stl

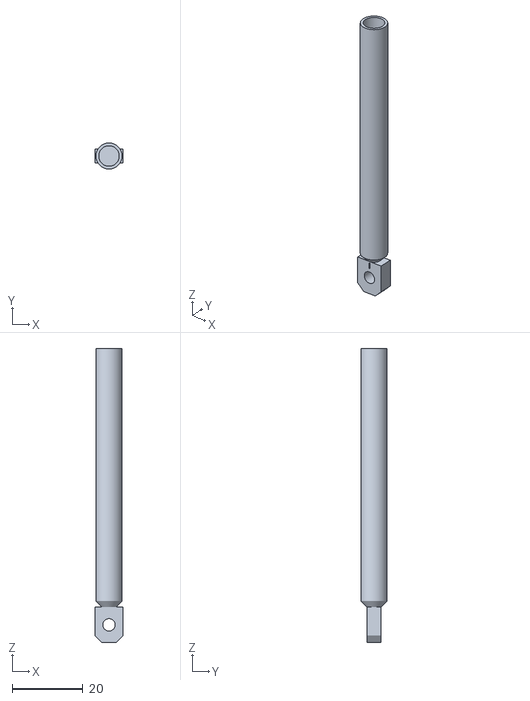
[picture p98: CAD file, 2026-10-19]
research/kuponlar/out/stl/K5_kardan_ic.stl
8.00 x 7.40 x 83.2
