Rynnat/endoskull/research/cad/out/stl/O1R.stl

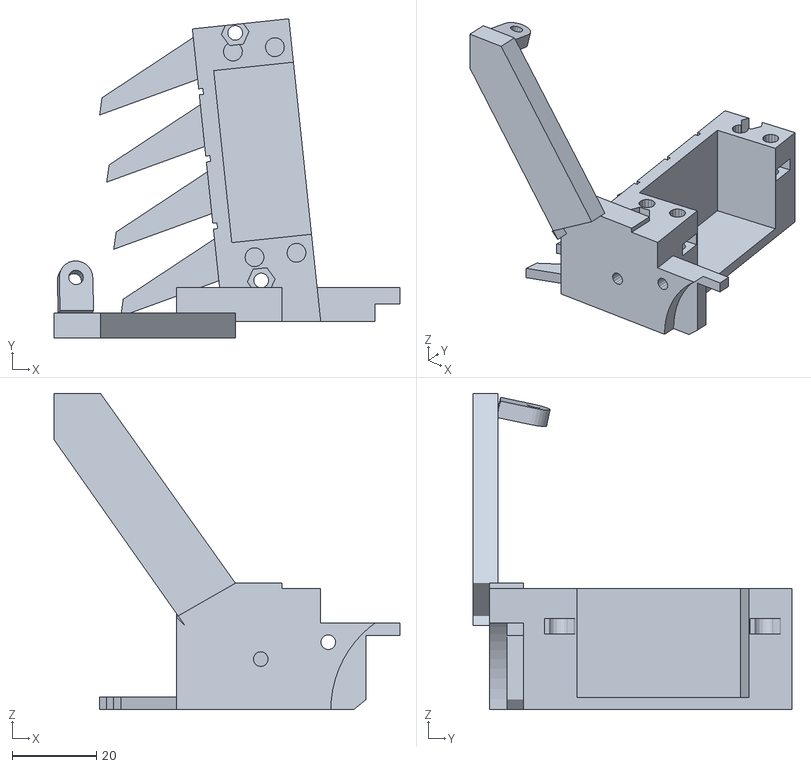
[picture p99: CAD file, 2026-10-19]
research/cad/out/stl/O1R.stl
82.0 x 75.7 x 75.0
