Rynnat/endoskull/research/cad/out/stl/B5f_yaw.stl

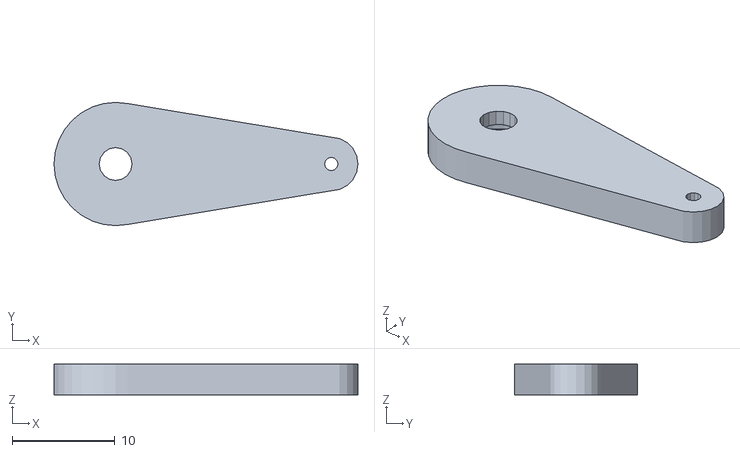
[picture p100: CAD file, 2026-10-19]
research/cad/out/stl/B5f_yaw.stl
29.6 x 12.0 x 3.00
