Rynnat/endoskull/research/cad_estetik/out/stl/P1_dis.stl

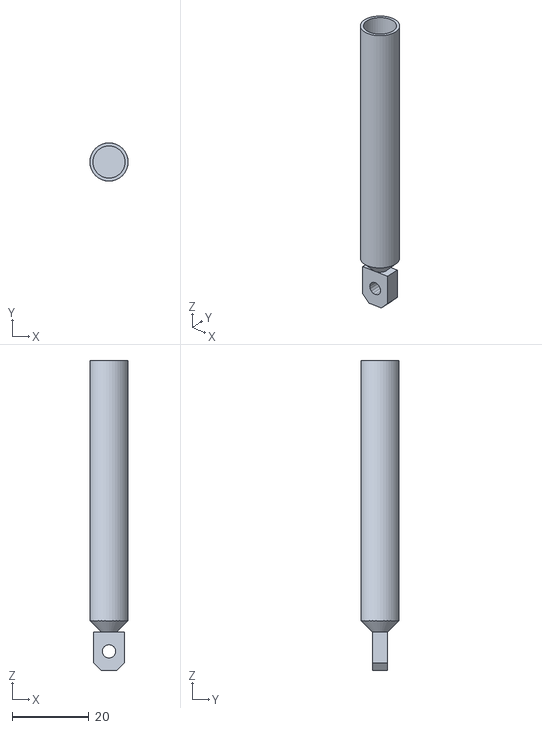
[picture p101: CAD file, 2026-10-19]
research/cad_estetik/out/stl/P1_dis.stl
10.0 x 10.0 x 81.0
