Rynnat/endoskull/research/kuponlar/out/stl/K2_pim_donen_3.4.stl

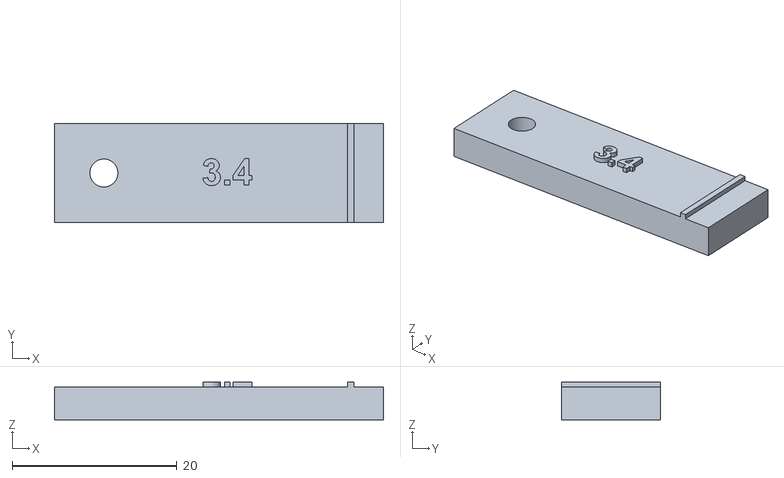
[picture p102: CAD file, 2026-10-19]
research/kuponlar/out/stl/K2_pim_donen_3.4.stl
40.0 x 12.0 x 4.60
