Rynnat/endoskull/research/kuponlar/out/stl/K5_kama.stl

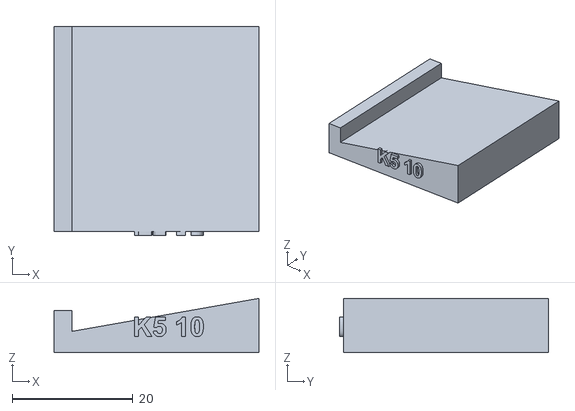
[picture p103: CAD file, 2026-10-19]
research/kuponlar/out/stl/K5_kama.stl
34.0 x 34.6 x 9.00
