Rynnat/endoskull/research/cad/out/stl/P1_ic.stl

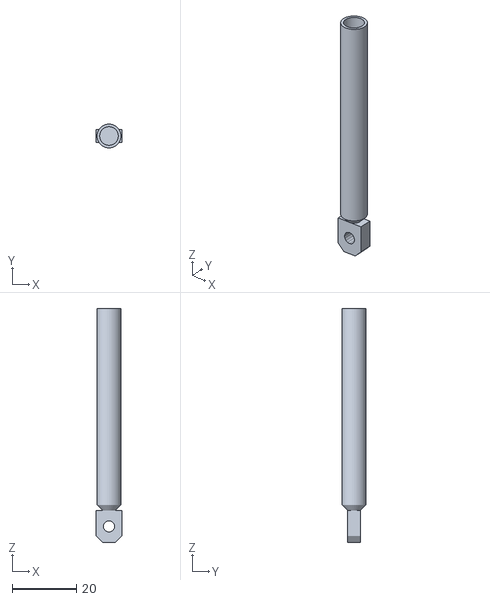
[picture p104: CAD file, 2026-10-19]
research/cad/out/stl/P1_ic.stl
8.00 x 7.40 x 72.7
