Rynnat/endoskull/research/kuponlar/out/stl/K7_panel.stl

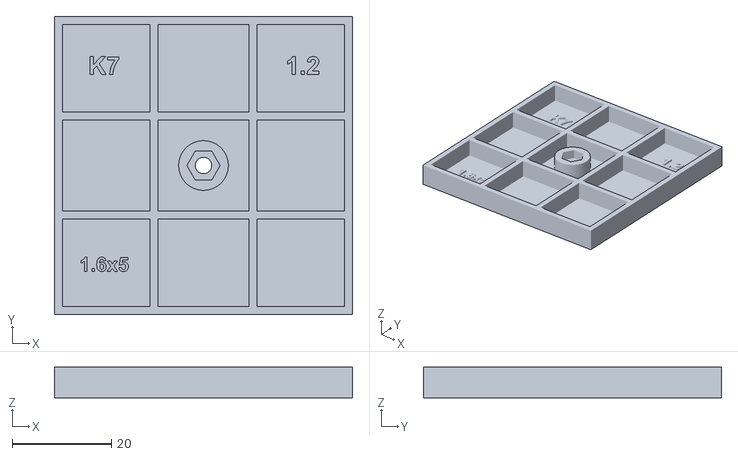
[picture p105: CAD file, 2026-10-19]
research/kuponlar/out/stl/K7_panel.stl
60.0 x 60.0 x 6.20
