Rynnat/endoskull/research/cad_estetik/out/stl/B5f_alt.stl

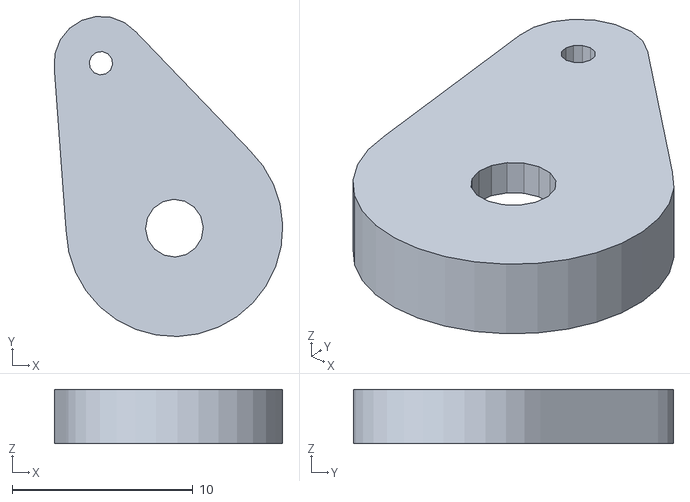
[picture p107: CAD file, 2026-10-19]
research/cad_estetik/out/stl/B5f_alt.stl
12.7 x 17.7 x 3.00
