Rynnat/endoskull/research/cad_estetik/out/stl/N5.stl

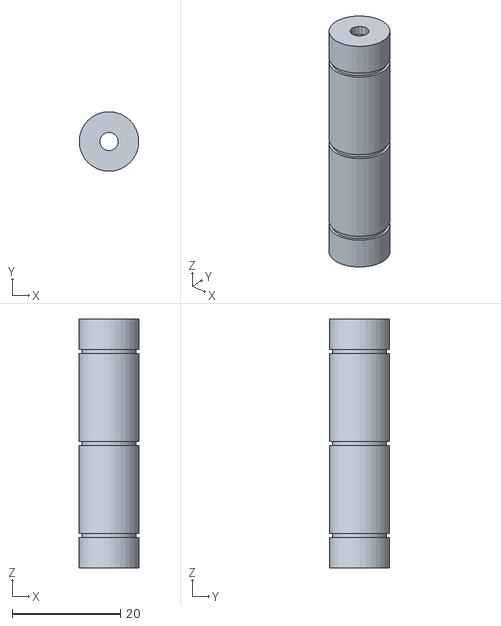
[picture p108: CAD file, 2026-10-19]
research/cad_estetik/out/stl/N5.stl
11.0 x 11.0 x 46.0
