Rynnat/endoskull/research/cad_estetik/out/stl/C1.stl

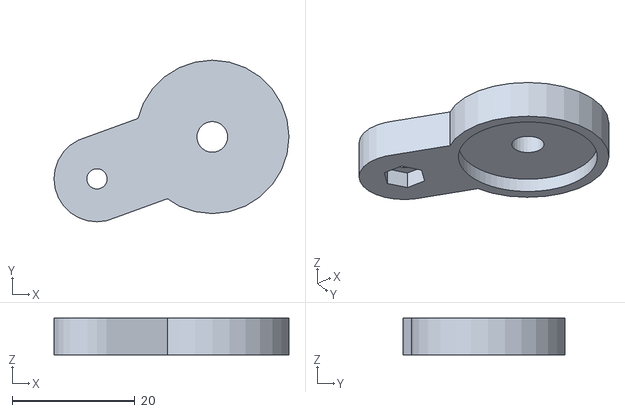
[picture p109: CAD file, 2026-10-19]
research/cad_estetik/out/stl/C1.stl
38.3 x 26.3 x 6.00
