Rynnat/endoskull/research/cad/out/stl/P1_dis.stl

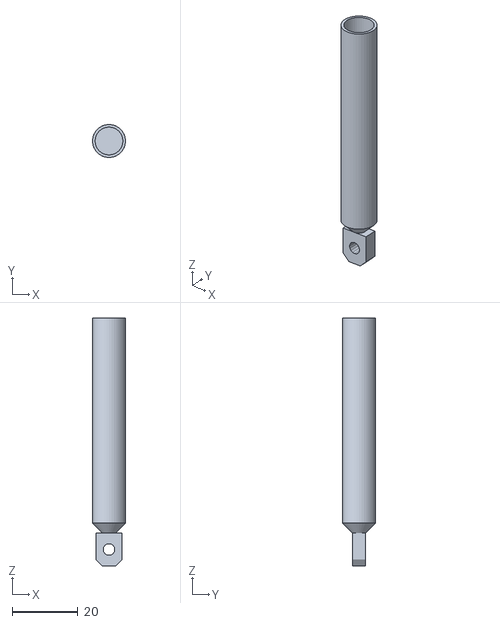
[picture p110: CAD file, 2026-10-19]
research/cad/out/stl/P1_dis.stl
10.0 x 10.0 x 75.2
