Rynnat/endoskull/research/cad_estetik/out/stl/B2.stl

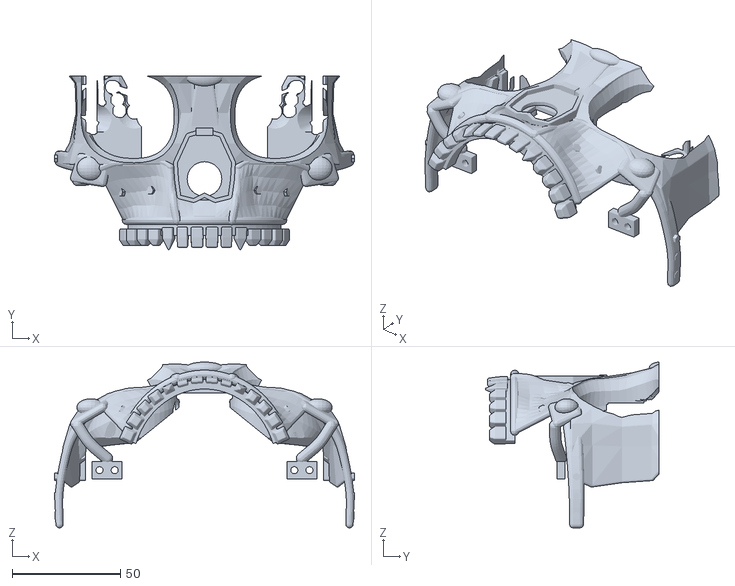
[picture p111: CAD file, 2026-10-19]
research/cad_estetik/out/stl/B2.stl
138.6 x 80.2 x 76.7
