Rynnat/endoskull/(list of files, cad)

Other CAD files:
research/cad/out/stl_varyant/N4_R_pay01.stl
research/cad_estetik/out/stl/P1_orta.stl
research/cad_estetik/out/stl_varyant/N4_L_pay01.stl
research/cad_estetik/out/stl_varyant/N4_R_pay03.stl
research/cad/out/stl_varyant/N4_R_pay03.stl
research/cad_estetik/out/stl_varyant/N4_R_pay01.stl
research/cad/out/stl_varyant/N4_L_pay01.stl
research/kuponlar/out/stl/K2_mg_p0.1.stl
research/cad_estetik/out/stl/B5g_L.stl
research/kuponlar/out/stl/K2_sg_p0.2.stl
research/cad/out/stl/B6R.stl
research/cad/out/stl/N4_R.stl
research/cad/out/stl/G2R.stl
research/cad_estetik/out/stl/B5d_L.stl
research/kuponlar/out/stl/K2_mg_p0.2.stl
research/kuponlar/out/stl/K2_sg_p0.1.stl
research/cad_estetik/out/stl/B5f_ustR.stl
research/cad/out/stl/B5b_L.stl
research/cad_estetik/out/stl/G2R.stl
research/kuponlar/out/stl/K5_dis_0.5.stl
research/cad_estetik/out/stl/B6R.stl
research/kuponlar/out/stl/K5_dis_0.6.stl
research/cad_estetik/out/stl/B5b_L.stl
research/kuponlar/out/stl/K2_pim_donen_3.3.stl
research/cad/out/stl/P1_orta.stl
research/cad/out/stl/B5e_R.stl
research/cad_estetik/out/stl/B5e_R.stl
research/cad_estetik/out/stl/G4L.stl
research/cad/out/stl/B5c_R.stl
research/cad/out/stl/B5g_L.stl
research/cad_estetik/out/stl/N4_L.stl
research/cad/out/stl/B5d_L.stl
research/cad_estetik/out/stl/B5c_R.stl
research/cad_estetik/out/stl/N4_R.stl
research/cad/out/stl/B5f_ustR.stl
research/cad/out/stl/G4L.stl
research/cad/out/stl/O1L.stl
